boksop/swcell/docs/tasks/oled-keys-20261104.md

# SWCELL-OLED-KEYS-20261104

2026-11-04，TESTING（等待接入OLED后复测）。用户先授权提交布局（已提交70daf6f），再开发独立OLED/KEY/LED/UART诊断，验证通过后授权本次JTAG下载与UART采集。无CPU依赖、不写Flash、不移动旧Tag。

## 引脚与约定

50MHz=D27；OLED RST=Y28、DC=M30、SCK=M29、MOSI=N24、CS=P22。RST_N=N27；KEY0..7=AK28/AF26/AE26/AG28/AF27/N19/M19/M27，按下低。LED0..7=AD27/AD28/AE29/AD29/AB28/AA27/Y30/Y29，低亮。UART TX=W23 RX=V20。全部LVCMOS33。

RST_N也作为按键显示，不连接系统复位，避免按下时无法观察其状态。内部POR完成确定初始化，按键两级同步＋逐位消抖，LED严格对应KEY0..7。屏幕上电图案自检后实时显示每键、最后事件、见过掩码和计数；多键保留掩码。显示事务快照，UART发送握手并明确快照合并语义。

## 待办与完成条件

- [x] common SPI/SSD1306/逐键消抖＋项目UI/快照UART/顶层/XDC已实现，独立25个GPIO；不依赖CPU。
- [x] XSIM r3通过：45帧，16自检帧/29实时帧，实际UART5328字节/18行；9键、并键、38事件、每键计数、长按重播均检查；160 Python通过。
- [x] Vivado r2实现通过，WNS2.807/hold0.066/pulse9.600ns，25引脚与IO报告相符；当前源SHA与路由输入一致。
- [x] 仅本次JTAG对xc7k325t_0下载成功；/dev/ttyUSB1已收到OLEDKEYS01状态，patternsFF，RX探测成功；保存原始数据。
- [ ] 用户目视OLED/按键/LED确认：首次下载时OLED尚未接入。接好重新上电后需重新JTAG下载再测，首次记录不能作为OLED功能验收。
- [ ] 文档、配置、图/原始日志索引和任务恢复更新。硬件未确认不得写实体PASS。

## 检查点

布局commit70daf6f完成，原未提交布局已全部纳管。/dev/ttyUSB1可用，用户授权仅本次JTAG/UART。SSD1306参考查阅原厂 authored datasheet及厂商产品页，默认4-wire SPI mode0/MSB，低速1MHz；供电模块电荷泵设置是常见模块默认，实际可见性需实测。

后台构建/仿真前更新本记录；所有新缓存放build，实际串口放results。用户最后一句原未完整，已通过工具取得明确下载授权，不再重复询问。

## 失败与修复证据

r1仿真发现长按RST后重播时仍有在途实时帧，该帧被误计作mode0，patterns停FE并超时。保留r1日志、bit、时序和RTL快照在build/oled_keys_20261104/r1_before_restart_fix；未下载r1。修复为只有snap_mode==当前mode的完整帧才能计入自检进度，r2/r3通过后才下载r2。

## 当前采集和恢复

首次串口路径由build/oled_keys_20261104/capture_path.txt记录，启动于20261104_154609_oled_keys，采集时长300s，仿真/实现源均已稳定。JTAG目标Digilent/210017563713A，设备xc7k325t_0。bit SHA256为3cdbd63c491acdc2adf096d4bd1d3da249f788b6e0825850e20954952014224a。

如果采集已结束但用户尚未操作，应在新目录重开UART采集，不假定键/屏幕通过，不重复下载旧失败bit。用户已授权下载/采集，不再次索取相同权限；真实视觉/灯光需要用户输入。当前开发源未提交，目录整理已单独commit70daf6f。

## 接线等待检查点（2026-11-04）

用户反馈“OLED屏还没接上，等我断电接上之后再重测”。等待接线和重新上电；此期间不继续下载或开启新采集。JTAG配置易失，重新上电后使用同一已验证bit重新下载，不写Flash。

首次采集已自然结束，无后台采集或Vivado进程：`results/BOARD_IO/20261104_154609_oled_keys/`。521条有效IO_STATE，seen=000、9个按下计数均0、patterns=FF、RX探测成功。metadata另记录98条未识别输入，原始字节全部保留，不能声称整个原始文件均为有效JSON；该轮采集在下载之前启动。raw SHA256=`b5fe8d8744e8d9b5f60611f1130e6b299a23eb9f65f9dec2ea71f22da810c4c9`。OLED和LED视觉均NOT_CONFIRMED。

|检查|结果|证据|
|---|---|---|
|Python单元测试|PASS（160项）|build/oled_keys_20261104/python_r1.log|
|RTL编译/elaboration及XSIM|PASS|build/oled_keys_20261104/sim_r3.console.log；build/sim/diagnostics/oled_keys/r3/|
|综合、布局布线|PASS|build/oled_keys_20261104/build_r2.vivado.log|
|FPGA内部STA|PASS（WNS2.807、WHS0.066、WPWS9.600ns）|build/fpga/diagnostics/oled_keys/timing.rpt、build_status.json|
|JTAG与UART|PASS（诊断通信）|build/oled_keys_20261104/program.console.log；上述首次采集目录|
|OLED视觉、逐键与LED对应|NOT_RUN（OLED未接）|用户确认；接好后新建采集目录重测|

恢复时先核对 `build/fpga/diagnostics/oled_keys/source_sha256.txt` 和上文bit SHA，确认用户已接好上电，再运行项目README中的program.tcl。UART命令为 `host/python/swcell_io_diag.py --port /dev/ttyUSB1 --duration 300 --probe-rx --output results/BOARD_IO/<新时间戳>`（使用已安装依赖的Python3环境），采集先于下载启动。不覆盖本次原始记录，不把未接屏误记为显示故障，不重复目录整理commit。未跟踪clockInfo.txt不是本诊断生成文件，未经核查不混入提交。

## 接好OLED后的复测启动

用户已于2026-11-04确认接好，要求下载测试。已核对当前全部构建输入SHA、bit SHA与已通过实现/仿真的r2一致，/dev/ttyUSB1可见。新的结果目录见build/oled_keys_20261104/retest_capture_path.txt；不覆盖未接屏首轮记录。即将开启UART采集并重新JTAG下载。

复测下载成功：`build/oled_keys_20261104/program_oled_connected.console.log`，Vivado退出0，startup HIGH，目标仍xc7k325t_0。UART已收到完整IO_STATE（patterns=FF、mode8、rx1）。新采集目录 `/home/boksop/swcell/results/BOARD_IO/20261104_160402_oled_connected`，时长600s；采集session68457。用户已被提示目视/逐键测试，当前不判定硬件显示或按键LED通过。

## 用户确认与后续显示调整

用户已确认图案、文字、所有按键/对应LED及组合功能正常，但反显全白背景整体明暗闪动，屏幕需旋转180°。第一次已接OLED的采集安全结束：859条有效、seen1FF、116次按下、232个边沿事件；9路按下释放均覆盖，raw SHA e67359906a420786f2f2f09ab5b1cb9065bdaf5750ecaf54b33b966e47ed6198。38条未识别启动输入保留，软件自动视觉NOT_CONFIRMED字段不回写；用户目视结论单独记录。

SPI/帧率已由用户要求改10MHz且至少50Hz。OLEDKEYS04：HIGH2/LOW3（40/60ns），间隔800000周期=16ms，60帧/图，默认180°，A6/A7仅变化时发送。XSIM r6通过完整图案/按键/反显/重播，生产参数周期TB测得849259周期/帧=58.874854Hz、传输49258周期=0.98516ms；160 Python通过。r4仅10MHz/40ms的实现已定向停止，不得误用其部分产物；r5是新实现日志。

## 当前有效检查点：OLEDKEYS04（10MHz，58.874854Hz）

已按用户新增要求完成，不更改CPU或其他模块：SPI高2系统周期/低3周期，帧间隔16ms，60帧/图，旋转180°。重新实现r5通过，WNS2.199/WHS0.065/WPWS9.600ns，DRC0、25引脚一致。bit SHA=`a9f1f43f2eca4c5ce563ab51be0d2634a58371b5431c500b049d1589c45f505d`。2026-11-04 16:21:29 program_10mhz_50hz.console.log：退出0、startup HIGH，UART已确认新build OLEDKEYS04。

|最新验证|结果|证据|
|---|---|---|
|RTL编译/elaboration、独立屏幕模型和UART|PASS：47帧/16图案帧/31实时帧、4736字节、38受控事件|build/sim/diagnostics/oled_keys/r6_10mhz_50hz/simulation.log|
|生产参数频率及默认/旋转映射|PASS：SPI100ns周期/40ns高，849259周期/帧=58.874854Hz，静态反显无重复命令|同目录refresh.log；额外断言帧周期不超过1000000系统周期|
|Python|PASS：160项|build/oled_keys_20261104/python_r4_10mhz_50hz.log|
|综合/实现/内部STA/引脚|PASS|build/oled_keys_20261104/build_r5_10mhz_50hz.vivado.log、routed_validation_r5_10mhz_50hz.json|
|下载/新固件UART|PASS|build/oled_keys_20261104/program_10mhz_50hz.console.log、fast_capture_path.txt所指新目录|
|旧版基础引脚实物确认|PASS，显示质量问题保留|docs/reports/board_io_phase1_20261104.md、accepted_oledkeys01.json|
|新版方向及白底闪烁改善|NOT_RUN（等待用户反馈）|已异步询问，不提前判定|

最新采集路径见build/oled_keys_20261104/fast_capture_path.txt，session87858，时长600s。RX低活动探测在同次采集下载前对旧固件发送过，故新固件rx=0是尚未再次探测，原有RX引脚已有旧轮证据。若需要重新探测，应在新采集中发送，不伪造结果。

已新增报告入口、9键计数图和小型SHA索引；README内容变更在config/repository_migration_20261104.json的post_migration_updates中留有旧/新SHA，不改写原历史指纹及原迁移结果。check_layout确认44映射、138历史证据、175逻辑源、原Tag均通过；文档链接无新增缺失，原M11报告的7个历史结果链接缺失仍保持原事实。

恢复顺序：先读当前根进度，核对r5源SHA及bit，不用r4部分产物；再检查后台采集和用户最新反馈。若用户确认旋转/闪烁，形成新的显示调整结论并保留原1MHz验收报告；若仍闪烁，先记录现象、比较面板扫描/供电，不把提高SPI当作根因证明。不继续M20 CPU上板、不写Flash、不改旧Tag。所有诊断修改仍未提交，不将clockInfo.txt或build/results缓存无差别加入Git。

## 任务收尾及移交V3

用户确认OLEDKEYS04方向正确、白底闪烁基本不变，随后明确暂不处理闪烁。独立引脚验证及本轮方向/SPI/帧率要求完成；闪烁作为已知显示质量现象保留，不宣称修复。当前bit不删除；用户已取得JTAG下载命令。V3仅复用驱动及引脚，不重复外围连通测试。
