boksop/swcell/docs/m20/M20_157_FANOUT_POWER.md

# M20：扇出、负载和电源估算

2026-11-02。pin连接数量VERIFIED；Cin/PCB/活动率应用ESTIMATED；SI和稳压器额定TBD。

## 负载

见[逐网负载](physical_resources/loads.csv)和[结构扇出](v21_resources/fanout.csv)。内部最大MUX输出负载21pin，主输入rst为34pin。物理模型另加每位Q的Slave反馈、D驱动Master、33个QM反馈/Slave负载及FPGA输出接口负载；clock66个S另外计，不混入组合图。

以LVC典型Cin2.5pF、每网走线10pF、FPGA输入5pF的假设，n0095、n0235、rst超出50pF的手册时序测试负载。负载不是datasheet绝对最大允许值；“超测试负载”表示该延迟模型不再适用，不能据此直接判芯片损坏。Cin无最大值，未超也不是已保证PASS。

|信号|风险/处理|
|---|---|
|n0095、n0235公共译码/提交|高扇出跨模块；先考虑物理分组/专用缓冲，保持逻辑同源|
|rst|分区驱动，避免单FPGA IO直接驱动95pF估算负载|
|66个clock S|两相/分支扇出树，独立skew与边沿测量|
|ROM/状态选择网络|控制端延迟与数据端不同；每个分支负载列入分析|

157可用常量选择作逻辑缓冲，但每个实例应额外计数；速度/边沿/skew也需验证。优先研究专用缓冲，避免为节省外围器件破坏反馈时序。

## 功耗场景

参数来源：[Nexperia手册](https://assets.nexperia.com/documents/data-sheet/74LVC1G157.pdf)。543颗的ICC最大条件项估算约2.172mA、7.17mW；仅为输入在电源轨的静态条件，不含中间电平额外电流。

模型使用内部Cpd和输出电容分别估计动态项，66个DFF选择端内部Cpd不随数据活动率降低，clock外部必切换负载另列；活动率0.05/0.2/1.0、内部等效输入切换系数1，见[power_scenarios.csv](physical_resources/power_scenarios.csv)。它不是功耗上下界，未计多输入同时切换、组合毛刺、慢边沿额外ICC、缓冲/FPGA损耗及温漂，不能据此选定电源额定。

|CPU频率|示例模型总功率范围W，活动率0.05…1|
|---|---:|
|100kHz|约0.0096…0.0274|
|1MHz|约0.0313…0.2094|
|10MHz|约0.2483…2.0296|

这些数值包括假设的接口负载充放电，部分实际由FPGA/时钟驱动供电；不是单一CPU电源轨实测。须分轨测流。

## 电源约束

每颗157邻近一个100nF起点，共543个（名义54.3µF，非高频有效总值）；每功能分区再预留bulk和缓冲去耦。电容封装/介质/DC偏压/ESL和电源平面回路需PCB评审。100nF为工程建议，不是厂商专属强制值。

初始实验台具备3.3V、可调限流、约1A级供电能力；最终稳压器、电流裕量与瞬态额定待实测。上电时避免CPU输出向未上电FPGA反灌；MUX partial-power-down不能代替整个接口电源时序分析。快速边沿下L·di/dt地弹、串扰和慢输入ICC可能比平均功率更先限制可靠性。
