boksop/swcell/software/README.md

# 模块参考软件

小型汇编/ISA/冻结ROM按模块保存。既有m20_300保留，以保持原Pong/Snake镜像与版本证据；新增模块使用software/<模块>并记录确定的生成方法。

ROM是CPU功能参考，不是FPGA配置bitstream。大型构建镜像在build中保存和备份，不无差别纳管。
