boksop/swcell/docs/reports/README.md

# 阶段验收报告

这里保存每个正式通过阶段的中文总结，供查看、评审和交接。正式报告回答四个问题：**测了什么、在什么条件下测、结果如何、通过说明什么**。

| 模块 / 阶段 | 测试日期（UTC+8） | 验收结论 | 测试规模 | 报告 |
| --- | --- | --- | --- | --- |
| M11 / 第一阶段低速基础功能 | 2026-10-16 | 用户正式确认通过 | 17项，4742次检查，Q/QM错误0 | [正式报告](m11_phase1_20261016.md) |
| M20 / V1.0–V1.3 CPU RTL功能 | 2026-10-29 | 用户在V2任务确认通过；仅RTL仿真 | 87场景57331事件差分一致，86项Python通过 | [正式报告](m20_phaseV1_20261029.md) |
| M20 / V2.3 模式A两相联合仿真 | 2026-11-03 | 用户确认；仅FPGA直接两相数字仿真 | 每配置87/57331；全非法50521及恢复 | [正式报告](m20_phaseV2.3_20261103.md) |
| M20 / V2.4 前馈时钟完整数字联合 | 2026-11-04 | 用户批准有条件数字验收；实体/FPGA实现/硬件开放 | 六配置各87/57331；B/C各50521非法及恢复；151 Python | [正式报告](m20_phaseV2.4_20261104.md) |
| 板卡 / 第一阶段外设引脚 | 2026-11-04 | 基础功能用户确认；反显白底闪烁保留 | 9键/8LED/8图案，116次按下、232边沿；不运行CPU | [验收报告](board_io_phase1_20261104.md) |
| M20 / V3-F06 FPGA启动与按键交互 | 2026-11-04 | 用户确认完全正常；仅功能存储原型交互 | 164项Python；BOOT/游戏4帧SPI、5877 UART字节；实机75条记录及独立人工确认 | [验收报告](m20_phaseV3-F06_20261104.md) |
| M20 / V3 FPGA CPU游戏功能原型 | 2026-11-04 | 用户在发布任务确认两游戏实机通过；FUNCTIONAL_STORAGE | 87/57331核心差分；315乱序场景；实际游戏/有限ISA/全RAM快照；最终F06 | [正式报告](m20_phaseV3_20261104.md) |

| M20 / V3.1 CPU自主软件系统 | 2026-11-05 | 用户确认基本功能及修正版球拍/加号；FUNCTIONAL_STORAGE | 181 Python；2589535退役/9566 SPI字节；两次A重开仿真；实机45条UART及独立人工确认 | [正式报告](m20_phaseV3.1_20261105.md) |

## 后续阶段的记录方式

1. 确定用于验收的有效记录：实际 DUT 已连接、数据完整、条件明确，且用户已确认本阶段正式通过。
2. 从[模板](stage_report_template.md)创建 `{模块}_phase{阶段}_{YYYYMMDD}.md`，记录实际配置、逐项结果和证据路径。日期采用 Asia/Shanghai。
3. 用表格展示参数和结果；必要时增加时序图、检查量或性能曲线。图表须说明单位和依据；没有实测的数值应标为推导或仿真。
4. 写清本阶段成功的意义及尚未覆盖的范围，并说明诊断过程是否影响验收数据。
5. 核对报告与原始 JSONL、CSV、构建参数一致，更新本索引和主 README。后续验收另建报告，不覆盖旧结论。

`assets/`保存报告插图，Markdown 表格提供其对应的可读数值。正式报告和少量插图可纳入版本管理；原始数据仍在`results/`，交接时应同时归档报告引用的结果目录。仅取得 Markdown 而没有原始目录时，可以阅读结论和参数，但无法重新解析原始串口记录。

当前报告由工程协作流程维护；UART 采集程序负责保存数据，不会自行宣布某个阶段获得正式验收。
