boksop/swcell/docs/m20/README.md

# M20 — SwCell Game CPU

## 最新通过：V3.1 自主软件系统

[架构](M20_V31_ARCHITECTURE.md)、[软件SPI](M20_V31_SOFTWARE_SPI.md)、[性能](M20_V31_SOFTWARE_PERFORMANCE.md)、[测试状态](M20_V31_TEST_REPORT.md)。独立工程m20/autonomous；用户确认基本功能及修正版重开/加号正常，[正式报告](../reports/m20_phaseV3.1_20261105.md)。不改冻结ISA/477节点/V3 F06，FUNCTIONAL_STORAGE通过不代表实体双MUX DFF时序通过。下方V1～V3保留历史验收边界。

**2026-11-04：用户批准 V2.4 有条件数字验收。** [正式报告](../reports/m20_phaseV2.4_20261104.md)｜[本地定版及干净恢复](M20_V24_LOCAL_GIT_REPORT.md)｜[纳管文件清单](M20_V24_GIT_FILES.csv)。本地 annotated tag `m20-v2.4-digital-verified`；下列开发阶段“待审核”保留为历史，失败配置不改判，物理/实现/实物仍 OPEN。

## 当前V2.4主线：16级四抽头前馈20颗发生器

**最新 C/D：数字系统开发完成，待用户审核。** [完整联合验证报告](M20_V24_FULL_SYSTEM_VERIFICATION.md)：A/B/C logic/timed 各 87 场景、57,331 事件通过，B/C 各 50,521 非法终态/恢复，151 Python 通过；实际 TAP16 叶端 D1/D2=22/22ns（假设包络）。[实际波形](ffcd_resources/memory_service_timing_complete.svg)｜[存储服务](M20_V24_MEMORY_ADAPTER_DESIGN.md)｜[实体开放事项](M20_V24_PHYSICAL_TIMING_OPEN_ISSUES.md)。冻结 CPU/ISA/ROM 和 V23 不改，未 commit/Tag，未进入 V3。

以下为 A/B 历史评审；其停止门槛已被用户明确的数字/实体分层验收授权替代，原负测失败仍保留。

2026-11-04 B深化：[架构评审/十二项结论](M20_V24_ARCHITECTURE_REVIEW.md)、[参数灵敏度](M20_V24_TIMING_SENSITIVITY.md)、[时钟树与五种Buffer](M20_V24_CLOCK_TREE_BUDGET.md)、[79真实短路径](M20_V24_REAL_CPU_SHORT_PATH_ANALYSIS.md)。复核7ns为模型分配3ns＋有效边界4ns；新增632次局部实验、146项Python通过。存在条件工作区，建议保留20颗但暂不准入C/D，不作实体时序保证。

2026-11-04：[A/B开发报告](M20_V24_TEST_REPORT.md)、[结构审计](M20_V24_MUX_AUDIT.md)、[时序反例](M20_V24_NONOVERLAP_VERIFICATION.md)。固定20颗结构及模型检错VERIFIED；56组为32 CONDITIONAL、24 FAILED。快速链敏感性下四抽头均有负D1/D2，按门禁停止在A/B，尚无实体推荐抽头，不启动存储/完整CPU联合，不创建验收tag。CPU543、ISA、ROM和V2.3基线保持。

## 历史V2.4候选：116颗自主发生器与同源存储服务

[设计审核稿](M20_V24_DESIGN_REVIEW.md)：116颗发生器候选+543核心，A/B/C预设参数完整对照PASS；独立混合选择弧覆盖缺口尚未解决，已按用户指令暂停，无验收tag。V23模式A定版及原PASS不受影响。

## V2.3：真实双相锁存器与同步FPGA存储联合仿真

2026-11-03：保持477组合/33状态/543等价，新增IDEAL_FF与真实66反馈MUX状态切换，四阶段非重叠调度、停钟/单步和同步ROM/RAM服务。

- [双相架构](M20_300_V2_3_TWO_PHASE_ARCHITECTURE.md)
- [两相与FPGA存储接口时序契约](M20_300_V2_3_FPGA_MEMORY_TIMING.md)
- [回归入口及压力矩阵](M20_300_V2_3_VERIFICATION.md)
- [实际结果与关键波形](M20_300_V2_3_TEST_REPORT.md)

V1/V2.1旧源、机器码、历史证据和标签保留；不是实体157时序签核。

## 当前入口：V2.1正式543结构 / V2.2物理规格

2026-11-02：用户接受500+规模，不再以300为硬约束。正式版477组合+66存储折算=543（纯功能542），33状态/原ISA/2-5profile保持。本轮已重新完成全部50521非法CPU终态和恢复、87场景57331事件三方及内存测试；物理规格属于估算，真实DFF/时钟/PCB尚待实测。

|入口|内容|
|---|---|
|[V2.1结构](M20_300_V2_1_STRUCTURE.md)|正式生成器、完整退役接口、477/476口径|
|[V2.1审计](M20_300_V2_1_MUX_AUDIT.md)|独立SV/pin/FF/锥/扇出CSV|
|[V2.1验证](M20_300_V2_1_VERIFICATION.md)|全非法终态/数学/三方与一条命令|
|[V2.1结果](M20_300_V2_1_TEST_REPORT.md)|本轮实际PASS与未执行边界|
|[物理可实现性](M20_PHYSICAL_FEASIBILITY.md)|最长/最短路径、器件/时钟/接口/PCB规格导航|
|[活动任务](../tasks/m20-v21-physical-20261102.md)|检查点和证据|

## 历史入口：V2 157结构与精确审计

2026-10-29：V1原件及原始证据保留并复跑通过。新增baseline/shared两版显式MUX网表，保持33位状态/原ISA/2-5profile；每版87场景57331事件的V1/V2/Python三方回归通过。独立审计得到**738→603颗核心157等价**，尚未达到328/300；未进入板级/物理阶段。

|入口|内容|
|---|---|
|[V2结构](M20_300_V2_STRUCTURE.md)|唯一原语、MUX逻辑构造、生成网络及FF边界|
|[精确预算](M20_300_V2_MUX_BUDGET.md)|逐组/逐实例CSV、328偏差、共享效果与拓扑|
|[V2验证](M20_300_V2_VERIFICATION.md)|两版三方入口、不可变V1/输入、独立审计与失败证据|
|[V2结果](M20_300_V2_TEST_REPORT.md)|实际测试和最终八个问题的回答|
|[Git基线提案](M20_300_V2_GIT_BASELINE.md)|首次纳管范围/排除/历史证据归档，待用户确认，不commit|
|[V2任务记录](../tasks/m20-300-v2-20261029.md)|完成状态及下一次恢复入口|

## 已冻结的V1.3功能基线

2026-10-29：正式 ISA 为 **M20-300-ISA-0.1**，编码/标志/软件状态与V0一致。七模块功能RTL、原生FF状态33位；已用真实XSIM2026.1.1完成86项Python、全编码/ALU、87个CPU场景共57331事件差分，原Pong/Snake机器码执行通过到V1.3。

|文档|用途|
|---|---|
|[ISA正式冻结规范](M20_300_ISA_FROZEN.md)、[机器规则表](isa_v0_1.json)|软硬件共同依据；FAULT软件边界与ISA/周期profile分离|
|[V1 RTL设计](M20_300_V1_RTL_DESIGN.md)|实际模块/33位/提交边沿/总线/资源风险|
|[V1验证方法](M20_300_V1_VERIFICATION.md)|一条命令、输入/输出协议、独立比较及失败证据|
|[V1测试结果](M20_300_V1_TEST_REPORT.md)|实际XSIM统计、逐项PASS、镜像SHA及验证边界|
|[V1任务入口](../tasks/m20-300-v1-20261028.md)|当前恢复记录|

执行 `sim/scripts/run_m20.sh` 可重现。**ISA冻结不冻结微架构**；当前2/5周期是所选profile，328颗仍未结构审计。V1通过指RTL功能仿真，不包含综合/STA/FPGA上板或157物理性能。用户原架构文档保留撰写时状态，后续实现以本索引的冻结规范/设计/验证为准。

## V0 软件原型来源

2026-10-28：用户指定的 [M20_300_architecture_v0_1.md](M20_300_architecture_v0_1.md) 是本轮依据：16-bit 指令字、无 IR/B/T/LR、4-bit A、RAM 直接操作数、软件返回编号、候选 8 微状态。该源文档的“尚未实现工具”描述是撰写时快照，保留原文；当前实现与证据见以下新增文档。

|入口|内容|
|---|---|
|[16-bit ISA 与工具](M20_300_isa_v0_1.md)|完整编码、标志、汇编器/解释器及 trace 契约|
|[V0 验证与周期预算](M20_300_software_validation_v0_1.md)|77 项 Python 回归、2158 个核心场景、ROM 和实际动态指令计数、ISA 能力复核|
|[Pong/Snake 机器程序](../../software/m20_300/README.md)|汇编源码、RAM/输入/软件 ABI、一条命令复现|
|[当前任务记录](../tasks/m20-300-software-20261028.md)|进度、证据与下一阶段恢复入口|

Pong 为 168 words/336 bytes，Snake 为 368 words/736 bytes；尚无 OLED/SPI、按键消抖或硬件验证。328 颗仍待结构审计；本轮软件验证不构成架构冻结或物理阶段验收。此前 747 方案的 ISA/周期预算保留如下，作为历史比较，不能与 M20-300 混用。

## 历史方案：M20-747 规划 v0.2

日期：2026-10-28（Asia/Shanghai）。**提案v0.2，供评审；尚未冻结架构、实现CPU或验证性能。** 本目录现有10份中文规划Markdown及1份预算CSV，没有创建工程、RTL、XDC、程序工具或测试数据。

## 建议摘要

推荐优先评审**4位累加器、多周期、硬布线控制、12位PC、8位RAM地址、8位指令、单层CALL/RET**方案。程序ROM与数据RAM分离；8位物理数据接口中RAM先仅使用低4位，避免打包读改写。OLED先由CPU软件bit-bang，六键同步后轮询、软件消抖。Pong和Snake全部状态更新/碰撞/绘图决策由机器程序完成。

**用户已明确RAM/ROM不使用157构造**：方案1由FPGA提供；方案2使用外部并口芯片，例如IS61WV5128BLL-10TLI-TR与MX29LV320ETTI-70G。两方案存储容量均计0颗157，只计CPU侧寄存器及接口逻辑。原627–747估算已经不包含存储阵列，因此这个澄清不会自动从747扣除一块“RAM成本”。[747逐项明细](mux_budget.md)与[机器可读CSV](mux_budget_747.csv)已补齐。

**300颗目标与本提案不相容。** 显式MUX树及状态预算为：最小配置约555–651颗，Pong/完整Snake配置约627–747颗；加20%工程余量后，完整配置建议预算至900颗。控制器尚未逐门审计，这不是已证明的上界，也不是器件采购定案。应先决定是否接受该预算，或另立以300颗为硬上限的串行架构研究。

|问题|提案回答|
|---|---|
|为什么先4位|相对8位候选约省116–156颗的规划量级；可复用ALU做PC/地址运算，但执行更慢，须用真实软件验证|
|寄存器|PC12、AR8、A4、B4、T4、IR8、LR12、Z/C/K共3位、微状态6位、等待计数2位、GPIO5位；另键同步12位、复位同步2位|
|存储器|4KiB逻辑程序ROM；256个4位RAM单元；游戏各自独立程序镜像，暂不承诺一个镜像同时容纳两游戏|
|游戏可编程性|有完整条件分支、间接RAM读写、动态AR、借位/进位及单层调用；Snake用环形身体表与32-nibble占用位图|
|性能是否足够|条件性预算：零额外等待时，Pong突发帧≤390400周期，Snake含食物搜索最坏tick≤364900周期；约2MHz才有5Hz级规划余量，真实157频率未知|
|FPGA与实物一致性|同一寄存器/微状态/ISA/总线时序；FPGA仅把状态单元绑定原生FF，真实映射恢复MUX反馈DFF|

## 文档导航

|文档|内容|
|---|---|
|[architecture.md](architecture.md)|现有工程检查、候选比较、数据通路、寄存器、微状态与共享资源|
|[isa_proposal.md](isa_proposal.md)|完整候选编码、标志、周期、硬件与游戏用途、地址/调用示例|
|[memory_architecture.md](memory_architecture.md)|ROM/RAM总线、等待、8/16位接口比较、物理器件边界|
|[io_interface_plan.md](io_interface_plan.md)|软件SPI、六键、GPIO、辅助模块与外部器件职责|
|[mux_budget.md](mux_budget.md)|逐项157折算、三档预算、优化代价与网表审计方法|
|[game_feasibility.md](game_feasibility.md)|Pong/Snake循环、数组/位图、指令/访存/帧预算|
|[fpga_prototype_plan.md](fpga_prototype_plan.md)|FPGA分层、复用边界、观察口、原生FF与结构映射模式|
|[verification_plan.md](verification_plan.md)|P0–P8验收、独立参考模型、覆盖、故障注入与证据|
|[open_decisions.md](open_decisions.md)|必须冻结的决策、用户需补充的参数和风险|

## 事实、提案、TBD

- **工程已确认**：板卡part为`xc7k325tffg900-2`，配置50MHz；资料来自`fpga/projects/m11/functional/config/default.tcl`。M11 P1/P2/P2B证据保留，但不是M20频率依据。
- **用户已确定**：真实CPU主要由单路2:1 MUX构成；自定义ISA；CPU自主执行游戏；RAM/ROM由FPGA或外部并口芯片提供而非157；FPGA原型用原生FF；不复用/移植旧M11 Vivado工程；本次不编写CPU或引脚约束。
- **推荐、未冻结**：本文全部CPU位宽、编码、存储布局、GPIO位定义、显示假设及预算。
- **TBD**：OLED控制器/分辨率/时序/电平、六键电路、两存储方案的最终选择和候选器件的具体连接模式、M20实际157厂商料号、PCB时钟/复位/负载、外设引脚与可接受数量上限。

## 已有资料检查及本次完成状态

检查了AGENTS、TASK_PROGRESS、现有架构、公共RTL、板卡配置、M11正式与高速验证文档、用户本次附件。未找到独立项目纲要、既有M20设计或通用结构级ALU/MUX库；这表示**当前工作区未找到**，不声称工程外从未设计过。发现的旧模块保持原样。

- [x] 架构/ISA/总线/IO/资源/软件需求/验证路线规划落盘。
- [x] 规划内部的预算加总、编码族覆盖、周期计算、文档链接及原工程未改动检查；这是文档一致性检查。
- [ ] 用户审查并冻结P0（未执行）。
- [ ] P1资源网表审计、P2以后实现/仿真/FPGA/PCB验收（全部未执行）。

**规划编写任务完成，架构冻结与硬件验证未完成。** 本次遵守仅写M20文档的限制，未更新根TASK_PROGRESS或旧110文件首次提交清单。后续会话先读本页、open_decisions和verification_plan；如要实现，须先取得架构冻结结论并更新任务入口/纳管清单。不得把文档完成标成M20阶段硬件PASS。

## 外部资料口径

器件逻辑参考[Nexperia 74LVC1G157数据表](https://assets.nexperia.com/documents/data-sheet/74LVC1G157.pdf)：用来核对单路MUX功能及无运行时三态输出使能的接口边界，不将其料号/典型延迟当作用户实物规格。FPGA状态单元参考[AMD UG953 FDRE](https://docs.amd.com/r/en-US/ug953-vivado-7series-libraries/FDRE)。2026.1的器件/许可须在P6前核实，参见[AMD许可说明](https://www.amd.com/en/products/software/adaptive-socs-and-fpgas/licensing-faq.html)，本次没有执行工具检查。

## 本次文档核对

2026-10-28已检查10份文件的相对链接/代码围栏、63个微状态、229种有效首字节与27种非法IO编码的数量划分、预算加总和游戏周期算术，均一致。这是文本/数学自检，没有运行CPU模型或指令仿真。

原rtl/fpga/sim/host/results范围308个既有普通文件的路径+SHA映射摘要前后一致：`f041b6f2968310a116071cfdbee184aab5f431abbe10f4f6b739a69909949f69`；Git index的SHA仍为`ac2b0d7c6dbd88a804b174f62e84e0c672a987d508deabbed8bd5ff3d0ef0c6a`。本次没有新增暂存、commit或push。

v0.2补充：已将747取值拆成164颗存储MUX、62颗保持/使能MUX、521颗其它组合/控制预算；容量阵列为0。下一状态/控制240仍是估算上沿，存储/IO控制各12也待结构审计，不能写成已经实现的精确门数。此次只修改M20规划文件，根任务入口保持不变；下次继续时先阅读本页、预算和待决项。

## 本地版本与恢复

[版本历史/标签](M20_RELEASE_HISTORY.md)、[来源SHA与只读审计](M20_SOURCE_MANIFEST.md)、[实际恢复报告](M20_LOCAL_GIT_REPORT.md)。数字逻辑tag不代表实物时序；物理分析tag保留ESTIMATED/TBD。

## V3 FPGA实机原型（2026-11-04）

[工程与按键](../../fpga/projects/m20/cpu_validation/README.md)、[架构](M20_V3_FPGA_ARCHITECTURE.md)、[结构映射](M20_V3_STRUCTURAL_IMPLEMENTATION.md)、[时钟/存储](M20_V3_CLOCK_MEMORY_INTEGRATION.md)、[按键/OLED](M20_V3_KEY_OLED_INTERFACE.md)、[游戏](M20_V3_GAME_VERIFICATION.md)、[STA/资源](M20_V3_TIMING_RESOURCE_REPORT.md)、[硬件记录](M20_V3_HARDWARE_TEST_REPORT.md)、[总报告](M20_V3_TEST_REPORT.md)、[Pong固定发球说明](M20_V3_PONG_SERVE_REVIEW.md)。功能存储模式已实机运行且用户确认两游戏操作；严格反馈模式85项LUTLP-1，不宣称543物理反馈存储已在FPGA上通过。当前按用户反馈默认Pong10/Snake5tick/s，KEY5暂停，KEY4中键忽略。

F04方向事件缓存已获用户确认短按明显改善。另有[固定乱序食物变体](M20_V3_SNAKE_SHUFFLED.md)：原ASM/ROM不变，新软件315场景/154611事件及实机66tick/12份全RAM对照通过，已下载；食物分布的新人工体验尚待确认。

当前键位调整：[F05互换记录](M20_V3_KEY_SWAP_F05.md)，KEY5/A切游戏、KEY7暂停/继续。前述KEY5暂停为F03/F04历史确认，F05不改游戏ROM、CPU或速度。

启动页入口统一：[F06记录](M20_V3_BOOT_ENTRY_F06.md)。BOOT页KEY5启动当前游戏，KEY7不启动；游戏中继续KEY5切换、KEY7暂停。F05键位互换已获用户确认，新启动入口独立记录验证状态。

用户随后确认F06“已经完全正常了”；[启动与按键交互正式验收报告](../reports/m20_phaseV3-F06_20261104.md)及独立人工确认记录已保存。该范围不扩展为实体543颗157时序或整个V3最终冻结。

后续首次Private发布任务中，用户明确确认V3整体游戏功能已通过：[V3整体正式报告](../reports/m20_phaseV3_20261104.md)、[GitHub发布记录](../GITHUB_PUBLISH_REPORT.md)。Private仓库boksop/swcell及m20-v3-fpga-hardware-verified Tag保留历史代码；仅FUNCTIONAL_STORAGE通过，不修改早期证据或扩展实体时序结论。
