boksop/swcell/software/m20_300/rom/README.md

# 冻结参考机器码

2026-11-03从原汇编器只读组装并核对既有冻结SHA，不替换历史ROM或实测数据。

{
  "pong": {
    "words": 168,
    "binary_sha256": "e1029928d763ab5b0d21fe347687f52b326f545e9072f4c04365597439eead8c",
    "format": "16-bit word, little-endian unpadded binary; four hex digits per memh line"
  },
  "snake": {
    "words": 368,
    "binary_sha256": "466cb149c8e5d6914d0b78dc8a3ec5074c77020edf880cedbd520b41b3376b98",
    "format": "16-bit word, little-endian unpadded binary; four hex digits per memh line"
  }
}
