boksop/swcell/docs/reports/m20_phaseV1_20261029.md

# M20 第V1阶段验收报告：CPU RTL 功能与游戏ROM差分

> 状态：用户已在V2任务开头确认V1.0～V1.3完成并通过指令级差分。本报告验收对象是RTL仿真，不是FPGA板卡或157实物。

|项目|内容|
|---|---|
|测试日期/时区|2026-10-29，Asia/Shanghai|
|DUT|M20-300行为CPU RTL，33位状态；无物理板卡DUT|
|目标|冻结ISA，实现真正CPU执行Pong/Snake机器码，逐指令与Python一致|
|验收依据|用户V2任务确认；原`build/m20_300/v1/`及[V1详细结果](../m20/M20_300_V1_TEST_REPORT.md)|
|结果|86项Python通过；65536编码/32768 ALU向量通过；87场景57331事件一致，最终RAM一致|

## 1. 测试内容与方法

CPU RTL实际取16-bit ROM指令、读写256×4 RAM、读取逻辑六键，按冻结ISA更新A/AR/PC/Z/C/GPO。TB只装载启动夹具/外部输入，观察真正退役，不计算游戏行为。Python参考解释器独立计算预期，每条指令比较旧PC/机器字、next_pc、提交状态、RAM事务及实际微周期；所有场景结束比较完整RAM。

Pong包括初始化、运动、墙/球拍、双输入、得分进位；Snake包括清RAM、身体环/位图、旧尾格、自撞、增长、63次食物探测、64节封顶和重启。两游戏各有连续64tick，运行期间没有宿主状态回写。

## 2. 实际参数与频率

|参数|实际值|来源/边界|
|---|---|---|
|ISA|M20-300-ISA-0.1|冻结规则，机器码与V0不变|
|CPU状态|33bit|PC12/AR8/A4/ZC2/GPO4/uSTATE3|
|仿真微时钟|周期10ns，分辨率1ps|仅仿真时基；不是157实测100MHz|
|执行周期|普通2、RAM5、reset1单列|真实XSIM边沿计数与Python一致|
|ROM/RAM|4096×16 / 256×4|外部仿真模型，不使用157构造存储容量|
|内存模型延迟|ROM1.5ns/RAM2ns及注册读适配|逻辑时序压力，不是物理芯片规格标定|
|复位|同步高有效，立即屏蔽WE|不清RAM，不回滚已发生写入|
|工具|Vivado Simulator2026.1.1、Python3.12|实际xvlog/xelab/xsim|
|电压/温度/板卡时钟/UART|不适用，本阶段未实测|没有烧写、串口或板外仪器|

## 3. 逐项结果

|检查项|次数/规模|错误/差异|结果|
|---|---:|---:|---|
|Python回归|86项|0失败|PASS|
|严格译码|65536 word，15015合法/50521非法|0不符|PASS|
|ALU独立数学oracle|32768向量|0不符|PASS|
|内存/运行中复位|7组|0失败|PASS|
|CPU指令差分|49场景、22223事件|0差异|PASS|
|游戏CPU差分|38场景、35108事件|0差异|PASS|
|完整RAM|87场景×256nibble|0差异|PASS|

57331事件中57314正常退役、17 TRAP；一条事件可比较多个信号，但不将信号数重复计入事件总数。全空间编码是译码单元覆盖，不宣称CPU逐个时序执行了50521非法字。

## 4. 图表及解读

|程序|ROM指令字|有效字节|普通tick周期|本轮关键长路径周期|
|---|---:|---:|---:|---:|
|Pong|168|336|202|308，多分支/得分进位|
|Snake|368|736|926|13419，63次食物探测|

表中单位是执行微周期，来自真实RTL轨迹；单tick未含末尾NOP/JMP的4周期，不是完整游戏帧率或Fmax曲线。

## 5. 通过的意义及验证边界

V1建立了可综合行为RTL作为以后MUX结构优化的可信功能基线，证明核心算法确实能由当前ISA机器码和CPU数据通路执行。ISA冻结不冻结内部微架构；调整周期必须同步性能profile和参考测试。

未综合、未实现/STA、未上板；未做OLED/SPI/消抖/WAIT、同步ROM/最终BRAM或物理反馈DFF验证；33位只证明功能状态边界，不证明328颗预算。原始数据和报告保留供后续三方对照。

## 6. 异常与排除记录

本机xelab有LIBRARY_PATH环境提示，实际编译/仿真成功。早期根目录产生的M20编译缓存已移入build，旧.Xil不动。V2后来发现的结构生成命名冲突不属于本V1验收，不改写原V1记录。

## 7. 证据与复现

|证据|路径/标识|
|---|---|
|源码/规则/测试方法|[冻结ISA](../m20/M20_300_ISA_FROZEN.md)、[V1设计](../m20/M20_300_V1_RTL_DESIGN.md)、[验证入口](../m20/M20_300_V1_VERIFICATION.md)|
|原始数据|`build/m20_300/v1/{instructions,games}/`的输入、预期、实际CSV、完整最终RAM|
|日志/波形|`build/m20_300/v1/xsim/`及四个WDB、`python_tests.log`|
|汇总SHA256|原`verification.json`：`f0ab7e77643c1fd24fcad6cb330dc1b4ffbb9251f3cb1158baa6721bf3d2d8cb`|
|Pong小端ROM SHA256|`e1029928d763ab5b0d21fe347687f52b326f545e9072f4c04365597439eead8c`|
|Snake小端ROM SHA256|`466cb149c8e5d6914d0b78dc8a3ec5074c77020edf880cedbd520b41b3376b98`|

入口`sim/scripts/run_m20.sh`；为了不覆盖正式原证据，后续应指定新的`M20_OUTPUT_DIR`。源/输入关联清单与报告一并归档；本次Git尚无首个提交，不虚构commit。
