boksop/swcell/docs/tasks/m20-v31-autonomous-20261105.md

# M20 V3.1 自主软件系统

**COMPLETED，2026-11-05，Asia/Shanghai。** main基线4a7d1fd。用户确认菜单/两游戏/长按/暂停/复位正常，随后报告Pong重开球拍和图案问题；固件0.2修复、验证、重新下载后，用户确认“重开后两边球拍均正常”“两处均已显示为加号”。正式报告[已保存](../reports/m20_phaseV3.1_20261105.md)。

## 完成清单

- [x] 检查AGENTS/TASK/Git，保留用户docs.zip和先前Public进度修改，不改现有历史/Tag。
- [x] A：冻结ISA下软件可行性、统一重定位和软件ABI；最终ROM4052/4096字，剩44字，RAM剩10nibble。
- [x] H1/H2：六GPI仅2FF，GPO直连；所有SSD1306初始化/字节/SPI边沿由CPU OUT产生，无FPGA硬件渲染。
- [x] H3/H4：软件菜单、消抖/单次事件/长按、两游戏、乱序食物、局部绘图和软件节奏；Pong重开缓存/加号回归已修复。
- [x] H5：原CPU指令/存储/非法/算术回归，真实新系统V1/结构CPU/Python逐退役对照、STOP/STEP/RESET和单次写。
- [x] H6：综合/实现/STA/DRC/CDC、route audit、bit/JTAG、UART及独立人工确认。
- [x] 正式阶段报告、报告索引、README/模块入口、JSON人工确认、源SHA及原始证据索引。

不属于本次验收：ILA（采用UART辅助）、STRICT_MUX、真实157/两相发生器/PCB时序签核、温压/长期可靠性、Flash。没有开始这些后续工作。

## 最终配置和验证

|项目|命令/方法|结果|证据|
|---|---|---|---|
|Python|tools/test/run_python_tests.py|PASS，181项|build/m20_v31/restart_plus_python_r2.txt|
|原CPU基线|sim/scripts/run_m20_v3_core.sh|PASS，87/57331、50521非法/恢复、27840数学、7访存|build/sim/m20_v31/v3_core_baseline_r1|
|GPIO/平台|run_m20_v31_units.sh；源未因本次软件修复改变|PASS|build/sim/m20_v31/units_r4|
|完整新系统|sim/scripts/run_m20_v31.sh|PASS，2589535退役、9566SPI字节、373773RAM写、最终全RAM相同；A重开2次与plus像素|build/sim/m20_v31/restart_plus_joint_r2|
|游戏重定位|tools/m20/v31/verify_relocation.py|PASS，177 Pong/315 Snake，Python独立规则对照|build/m20_v31/restart_plus_relocation.json|
|综合/实现/STA|autonomous/scripts/build.tcl|PASS，750LUT/984FF、2RAMB36+1RAMB18、DSP0、1BUFG；WNS1.972/WHS0.092/WPWS9.6ns、DRC0|build/fpga/m20/autonomous/restart_plus_r2|
|路由审计|tools/m20/v31/route_audit.tcl|PASS，477MUX/33CPU FF，4OLED唯一驱动为GPO FDRE/Q|同上route_audit|
|JTAG|fpga/common/tcl/program.tcl|PASS，12:31:13 startup HIGH|build/m20_v31/restart_plus_program_r2.txt|
|最终UART|host/python/swcell_m20_v31.py，45s|PASS，45条完整记录，errors0；1起始残行单列|results/M20_V31/20261105_restart_plus_r2|
|UART控制，原平台|swcell_m20_v31_control_test.py|PASS，7条状态；STOP稳定、STEP+1、RESET PC0/GPO8无新写、RUN恢复|results/M20_V31/20261105_debug_controls_r1；属于原r5实机，平台未改|
|人工验收|本会话两个阶段的独立回复|PASS，基本功能及两处修复均确认|v31_resources/user_acceptance_restart_plus_20261105.json关联初始确认|

当前bit：build/fpga/m20/autonomous/restart_plus_r2/swcell_m20_v31_top.bit；SHA181fb8844407a69f405594440245dc5ed1e50a24e81e103d194aa531835cfd0f。ROM SHAae5be5055052c8ea9c8a5e4d00de5dcaf2dfe531e84a57fb9dec0b4feef71619。原F06 bit仍972d8ebc5378c244ce5f530be9c8f0b0c9b04853c6c56576c82f96e995d79c49。

## 决策与限制

固定477组合MUX＋33原生FF；无新增ISA/CPU状态/FPGA游戏逻辑。普通2/RAM5微周期，50MHz单域＋CE，CPU1MHz。共享软件例程使用RAM返回编号静态分派，非递归。无framebuffer，用SSD1306 GDDRAM；软件SPI54..89μs/bit，不能仍称V3的10MHz硬件SPI。当前常规Pong约9.59Hz、Snake约4.76Hz，为指令预算而非板外仪器实测。

本次bug修复仅6个软件/生成/测试文件改变，平台RTL/冻结CPU/ISA不动。每次launch_pong置OLDL/OLDR=15使缓存失效；PIX6输出00/00/18/7E/7E/18/00/00。最长轮询间隙58.523ms；3样本滤波不保证所有短按。Pong顶行比分布局取舍及仅44字ROM余量保持披露。

## 失败与历史证据保留

- 原r5 179 Python/2051485指令/7250SPI字节和最初用户回复仍是真实历史。后来新增实际A重开测试复现球拍全黑、旧球8列0x66；v31_initial_r5_resources/restart_and_glyph_counterexample.json。
- 初始源/ROM/测试快照build/m20_v31/pre_fix_20261105，初始指标/SHA/图在docs/m20/v31_initial_r5_resources；当前指标在v31_resources，两个版本不混用。
- 首个加号比较方向错误导致181测试2项失败、软件验证断言失败，未下载；build/m20_v31/plus_first_encoding.json和restart_plus_python_r1.txt原位保留。
- restart_plus_r1构建检测ROM改变而拒绝写bit，SOURCE_CHANGED_DURING_BUILD不是器件时序失效；锁定输入的新r2通过。
- 更早joint_r1超时常量在0时刻溢出、units_r1漏端口elaboration、implementation_r1误计同步器等失败仍原位；不放宽产品断言。
- 新仿真UART351完整行＋1末行截断；新实机45完整行＋1起始残行。旧r5首次143新协议＋8旧协议/前缀、旧控制7记录不回写为新固件。

## 恢复入口

任务已完成，不自动继续STRICT_MUX/PCB/Flash或优化。先看根TASK、正式报告和当前验收JSON；板上是restart_plus_r2，正常运行菜单/游戏，无后台仿真或采集依赖。不重复下载旧r5。

如有新缺陷，基于当前固件0.2保存新的复现/目录，保持旧证据。若用户要求Git定版，先检查全部未跟踪和已有修改，docs.zip不自动纳管。当前没有本轮commit/Tag/push，HEAD仍4a7d1fd，暂存区空；不能将V3旧Tag当作V3.1已发布。

最终收尾检查：32份当前源指纹、冻结V3、初始r5源快照及两个版本的全部原始证据SHA一致；正式报告链接和7工程catalog检查通过，git diff --check通过。文档收尾未改任何功能源码/测试数据，未重复运行已通过的大规模仿真或重新下载。

后续Git/Release定版已由用户授权完成，源码d0df9f9及Tag m20-v3.1-autonomous-fpga-verified已发布；旧“未commit/Tag/push”仅指功能验收当时检查点。新入口m20-v31-release-20261105.md及M20_V31_LOCAL_GIT_REPORT.md，不重复建立版本。用户也已自行删除未跟踪docs.zip。
