boksop/swcell/docs/tasks/m20-v31-release-20261105.md

# M20 V3.1 本地定版与Release归档

2026-11-05，COMPLETED，main起点4a7d1fd。用户授权commit/annotated tag/远程同步/GitHub Release bit归档；不包含新的设计或实物测试。

- [x] 读取AGENTS/TASK/本地工作流，暂存区空、只有V3.1和先前Public进度/入口变更，用户docs.zip另保留。
- [x] gh认证boksop，origin明确为https://github.com/boksop/swcell.git；live Public，main与5个旧Tag和本地一致。
- [x] 生成82来源/16实际bit构建输入绑定，65份原字节精选证据（1122412bytes）入Git；73份完整证据50566239bytes压缩为2307369bytes Release包，大文件索引与bit SHA通过。
- [x] 82来源/16输入、三文件再生成、独立计数、发布扫描和155路径暂存门禁通过；原181测试与硬件阶段证据原样归档。
- [x] 源码commit d0df9f97893019687bb2d8c81473a13ac6a074fb，干净detached worktree恢复/181 Python/完整XSIM/新综合全部PASS。
- [x] annotated tag对象42c2b7f3539551d238512309ea4db3b200fcf71c、main/tag正常atomic push；Release四附件已发布。
- [x] 真正远程Tag检出来源/ROM/证据/资源校验PASS；四附件及73份内层文件完整读回PASS，报告/索引落盘。

采用最终固件0.2（4052字/余44，ROM ae5be505…）和已用户验收的restart_plus_r2 bit（181fb884…）。FUNCTIONAL_STORAGE 477组合MUX+33原生FF，非STRICT_MUX/实体157/物理两相签核。所有原始build/results保持，失败不能改PASS；无新增许可证。

下一步打开tools/git与docs/m20/v31_resources；所有新发布辅助输出写build/v31_release_20261105新目录。不要重做Git初始化、移动旧Tag或混入docs.zip。提交/Tag/Release如果中断，先核对实际对象与远程资产后恢复，不能盲目重建或--clobber。

预提交审计：所有当前源/ROM/实际build输入及65份拷贝SHA通过，3个固件文件可逐字节再生成，独立CPU477/33/543通过；故意错误ROM预期SHA被拒绝。发布扫描17历史提交与当前候选PASS，无匹配秘密/超限文件/缓存；新增厂商版权抬头均为原始Vivado生成报告，不含工具或许可。暂存清单将按明确V3.1路径建立，docs.zip已忽略留本机。

源码提交已实际建立：d0df9f97893019687bb2d8c81473a13ac6a074fb（155路径变更）。干净worktree路径见build/v31_release_20261105/worktree_path.txt；clean_source_audit.json已PASS，82源/16实际输入、3生成文件、477/33/543、65归档证据均可仅由提交文件恢复，git status空。clean_python/clean_units/clean_joint/clean_synthesis正在独立运行；等实际结果再Tag/push，不重做硬件。

用户后续明确告知已自行删除docs.zip：这是未跟踪备份文件，不在source commit或Release选择中，不恢复也不将其删除计为工程变化；早期“保留本机”仅描述删除前检查点。/docs.zip忽略项仍用于防未来同名备份误提交。当前发布归档/源码不受影响。

干净恢复全部PASS：181 Python、2589535退役/9566SPI/373773写/全RAM、GPIO/存储/控制及新工程综合，原V3 67源/10生成文件也保护通过。已创建annotated tag对象42c2b7f3539551d238512309ea4db3b200fcf71c，目标d0df9f97893019687bb2d8c81473a13ac6a074fb；已正常atomic push main与新Tag。准备4个Release资产，manifest已绑定精确source/tag/SHA，等Release创建及独立下载校验。

## 最终恢复入口

任务COMPLETED；主功能交付及远程Release均已实际核实。source/tag目标d0df9f97893019687bb2d8c81473a13ac6a074fb，Tag对象42c2b7f3539551d238512309ea4db3b200fcf71c；后续main仅提交本轮恢复/下载证明，不移动Tag。Release https://github.com/boksop/swcell/releases/tag/m20-v3.1-autonomous-fpga-verified 。

独立远程克隆和下载路径见build/v31_release_20261105/{remote_clone_path.txt,downloaded_assets}；干净源码恢复181 Python、GPIO/内存/控制、2589535指令联合及新综合均PASS；原板上用户验收与源/bit绑定不变，发布期间未重跑硬件。源82/构建16/小证据65/Release内原文件73全部SHA通过，5旧Tag保持，未重写历史。完整报告docs/m20/M20_V31_LOCAL_GIT_REPORT.md及v31_release_resources/{recovery_verification,release_asset_manifest,download_verification,publication_verification}.json。

最后执行只对本轮元数据新增/更新文件显式暂存、独立补充commit及正常push；如这一步中断，核对git status、本地HEAD、ls-remote main后恢复，不重复source commit/Tag/Release创建。不自动--clobber或改Tag。最终精确main/资产SHA另存build/v31_release_20261105/final_receipt.json；该文件不嵌入自身Git提交。docs.zip已经用户自行删除，不恢复。本任务后不继续设计/PCB/硬件开发。
