boksop/swcell/docs/tasks/m20-v3-fpga-20261104.md

# M20-V3-FPGA-20261104

状态COMPLETED（FUNCTIONAL_STORAGE功能原型），2026-11-04，main。任务来源：用户附件10551b44的V3要求及按键补充。实现独立fpga/projects/m20/cpu_validation，不改冻结ISA/477组合网表/原游戏ROM、不改M0～M19和V23/V24证据或Tag。原“无远程/无V3 Tag”是开发阶段限制，已由用户后续首次Private发布授权取代，详见github-publish-20261104.md。

## 已核实

- [x] V24已在本地tag m20-v2.4-digital-verified（48564b5）正式定版；当前HEAD70daf6f为后续目录整理。
- [x] 现有独立OLED诊断在工作树未提交，硬件功能/方向已用户确认：SSD1306、SPI10MHz/58.87Hz、180°，驱动rtl/common/display/swc_ssd1306.sv；引脚fpga/boards/swcell_k325t/oled_keys.json及独立io.xdc。白底闪烁保留，用户要求暂不处理。
- [x] 冻结CPU rtl/m20/v21/generated/m20v21_cpu_core.sv含477显式组合MUX和33原生FF；V23/V24是仿真双锁存器适配，不可直接将延迟链当FPGA时钟。
- [x] 按键用户映射：逻辑K0=KEY2上，K1=KEY0下，K2=KEY3左，K3=KEY1右，K4=KEY5预留A，K5=KEY6 B重启。均低按下，经同步消抖转高有效。Snake由原IN1bit1重启；Pong原机器码该位预留，不改ISA/ROM。

## 待办

- [x] 派生可追溯V3适配网表和逐位存储映射；477节点/33位校验，保持冻结源字节不变。
- [x] STRICT_MUX综合/布局布线尝试，实际85项LUTLP-1；无严格bit，不关闭组合环检查，继续FUNCTIONAL_STORAGE。
- [x] 同一50MHz时钟＋受约束CE调度、同步ROM/RAM、单次写、RUN/STOP/STEP/RESET、每tick只读一致快照与节奏控制。
- [x] 复用OLED像素流，实现CPU状态只读可视化，不实现游戏规则或回写CPU RAM推进游戏。
- [x] 原87/57331及非法/访存、新系统/输入/控制/游戏回归通过，详细证据见后文。
- [x] F模式综合/布局布线/STA/CDC/资源审计、bit/JTAG/UART；用户确认游戏、慢速键位、F04短按改善。
- [x] V3八份技术报告已落盘并更新F04/变体信息；严格模式限制明确。
- [x] 独立乱序食物变体已实现、315场景差分、实机66tick/12份全RAM对照通过，原版保留。
- [x] 用户在首次GitHub发布任务明确确认两游戏实机通过，整体功能阶段报告m20_phaseV3_20261104.md完成；不扩展为实体157或全条件时序通过。

## 设计决定与风险

优先一个50MHz全局时钟，CPU用CE提交；多周期约束必须对应已验证的输入稳定窗，不能用全局false_path掩盖。ROM不添加CPU IR，保持CPU执行期间原字；RAM状态只由CPU写，显示另用只读端口/停止边界快照。硬件调试采用ILA或可完整快照/事务记录的UART等价接口。

## 恢复入口

先检查根进度及git diff，保留现有未提交OLED/V3代码与clockInfo.txt、tight_setup_hold_pins.txt（后两项非正式源码）。实现、仿真、实机均已有证据，不重新生成覆盖旧目录。当前板上snake_shuffled_r1，原版F04 functional_r6保留。打开M20_V3_SNAKE_SHUFFLED.md、变体manifest、hardware_snake_shuffled.json；下一步收集新食物分布体验，用户正式阶段确认后按模板写docs/reports报告及索引。无新的commit/Tag授权，不操作Flash或远程Git。

## 2026-11-04 实际验证检查点

- core_r1：F模式原87场景/57331事件与V1/Python一致，27840算术、50521非法TRAP及恢复、7访存专项通过。生成器逐项477连接校验通过。
- system_r5：F/严格MUX数字模型40398次提交边界一致，129帧，STOP/STEP/运行/停止复位/速度切换通过；两游戏各64tick完整256nibble与Python一致。
- board_r4：复用真实SSD SPI接收模型验证两游戏像素及6实体键映射，真实UART3918字节/6条完整JSON，UART控制STOP/STEP/选游戏通过。
- STRICT_MUX实际Vivado strict_r2保留543LUT3，综合及P&R完成，但85项LUTLP-1违规，故未生成bit/未下载；全部日志/DRC保留，不加ALLOW_COMBINATORIAL_LOOPS。该次是两周期复位调度的中间版本，反馈网络与当前仍相同；当前F有3周期复位释放修正。
- core_strict_r1尝试同样完整套件：ISA阶段通过，datapath反向注入初态后PC与参考不一致，未宣称87严格模式全套通过；从真实RESET启动的129帧F/S模式一致证据独立保留。强制初始化与反馈网络的交互仍待核实；不是已经证明CPU算法错误。
- functional_r1综合/P&R/DRC0，但WNS=-7.059ns，路径是游戏帧定时器runtime除法（并非CPU）。未生成bit；改为两个编译期常量除法再选择，不改ISA/CPU；functional_r2及system_r6/board_r5正在验证。未用多周期/false_path掩盖该失败。
- Python163项通过（build/m20_v3_python_r1.log）。当前新模块/脚本尚未提交，没有V3tag或远程操作，尚未对CPU实机下载。

关键原始日志：build/fpga/m20/cpu_validation/{STRICT_MUX,strict_r2,FUNCTIONAL_STORAGE,functional_r2}；sim证据build/sim/m20_v3/；控制台/tmp/swcell_v3_*.console.log（最终需将必要摘要/索引落在工程build或文档中，不依赖/tmp长期存在）。

## 用户实机确认及易用性修改（2026-11-04）

用户已确认Pong显示/控制/反弹得分正常；Snake方向/反向拒绝/食物/死亡/B重启、游戏切换、暂停等“有效，都正常”。仍认为原30/10tick/s偏快，并要求实体KEY4中键不用于暂停，因五向键易误触。决定暂停改KEY5（A），KEY4无操作；逻辑K4仍读KEY5，游戏ROM预留该位不变。新默认Pong10tick/s、Snake5tick/s，CPU主动1MHz不变。

functional_r3（F02）已通过实机UART STOP、单步、停止复位、100k/500k/1MHz三速和Snake128tick全RAM对照，证据results/M20_V3/20261104_181159_controls_and_snake/verification.json。原F02源和bit保存；准备F03新配置，需重新仿真/实现/STA后下载，不覆盖旧结果。

## F04输入可靠性修改检查点

用户新增：食物一直沿中间横条依次出现、按一次有时无反应。核实冻结snake.asm为从旧食物后一个位置顺序查空，不是随机；保留ROM。短按问题存在5Hz轮询空隙200ms，20ms消抖后仍可能漏采；相反方向另受原ROM拒绝，不混同消抖。

新增rtl/common/swc_key_event_buffer.sv：bank0深度8方向按下状态FIFO、bank1动作sticky；只有真实CPU IN0/IN1退役才消费，phase0给呈现token。覆盖采样后新事件不能被旧ACK清掉、空队列采样与入队同拍不能重复、满队列同时出入、溢出饱和上报等。该逻辑是FPGA外设，不增加33位CPU或修改477网表。

inputs_r1单元通过；board_r8集成验证暂停时短按已松开仍送到CPU（监视实际IN0 ack），KEY4忽略/KEY5暂停/六键及OLED/UART通过；system_r9保持F/S40398提交及两游戏64tick完整RAM与Python一致。F04新bit functional_r5正在实现，尚未下载。原F03bit及全部源已快照。

UART M20V3F04：debug[94:91]队列占用、[90:81]10位饱和溢出计数、bit95溢出标志；其余CPU状态格式不变，旧F01～03保留兼容。LED7合并报告CPU周期错误或输入溢出。

用户已确认F04短按正常、明显改善。V3功能原型基础和输入修正已有实机认可；新要求固定乱序食物表，作为独立Snake软件变体实现，原snake.asm/ROM保持不变。表128唯一格子、CPU软件选择与跳过占用，RAM22/23存索引；不新增CPU状态或指令。原V3源/bit已快照，程序tick_done地址须随变体元数据参数传入，不能沿用316。

## 20:20 固定乱序食物完成检查点（优先于前文历史状态）

原始需求：用户希望预设乱序坐标，蛇身占用则跳下一项。独立软件SNAKE-SHUFFLED-0.1已完成，生成器tools/m20/v3_snake_shuffled.py，软件目录software/m20_300/variants/snake_shuffled_v0_1。128唯一位置、索引循环，额外2个软件RAM单元；ROM1295/4096words，tick_done313。原版368words及CPU/ISA不改。

|测试|命令/方法|状态|证据|
|---|---|---|---|
|Python|tools/test/run_python_tests.py及unittest discover|PASS，164项；末次postcontrol日志见build|build/m20_v3_python_shuffled_final.log；build/m20_v3_python_shuffled_postcontrol.log|
|原核心RTL|run_m20_v3_core.sh|PASS，87场景/57331事件、50521非法、27840算术、7访存|build/sim/m20_v3/core_r2/|
|同步系统RTL|run_m20_v3_system.sh|PASS，40398 F/S提交、129帧；原两游戏各64tick全RAM|build/sim/m20_v3/system_r11/|
|输入FIFO|run_m20_v3_inputs.sh|PASS|build/sim/m20_v3/inputs_r1/|
|变体V1/V3/Python|run_m20_v3_snake_shuffled.sh|PASS，315场景/154611事件/464505周期|build/sim/m20_v3/shuffled_r1/|
|变体板级|run_m20_v3_board.sh，显式传变体文件和断点313|PASS，SPI/6键/UART3918字节|build/sim/m20_v3/shuffled_board_r1/|
|综合|build.tcl显式--snake-rom/--snake-done 313|PASS|build/fpga/m20/cpu_validation/snake_shuffled_r1/|
|实现/STA|独立路由及STA|PASS，WNS0.735/WHS0.060/WPWS9.232ns、DRC0|同上timing.rpt、drc.rpt|
|路由结构审计|v3_route_audit.tcl|PASS，477 LUT3/33CPU FF/1 BUFG|同上route_audit/counts.json|
|实机|20:14:18 JTAG成功；control_test.py显式变体source|PASS，STOP/STEP/RESET/三速、Snake66tick/12份完整RAM一致，错误/溢出0|results/M20_V3/20261104_201445_snake_shuffled/|
|新食物体验|用户试玩|NOT_RUN，尚无回复|不把UART结果当作人工确认|

当前bit：build/fpga/m20/cpu_validation/snake_shuffled_r1/swcell_m20_v3_top.bit，SHA256 d58128b860ff512fd0bb36b6ae70afa35496844b098c39df6b27bf2e77eb3440。新实机raw SHA256 55cbab6e1f415e82e45e4b9a977b5faae16f4f9dc88f22b5aebee694d2457d45。实际食物10,3→2,6，新增表索引0→1、长度3→4；12份全RAM匹配并不代表板上已经遍历128个食物。

所有主要新增源/测试/报告尚未提交，main HEAD70daf6f；不创建V3 Tag。历史core_strict_r1、strict_r2、functional_r1失败保留；本次没有改它们的结论。原版F04 bit及源在functional_r6保留，原始599条/600s采集及用户短按确认均保留。新功能小型证据在docs/m20/v3_resources/snake_shuffled_*，只含汇总/CSV/哈希，构建缓存/大波形/原始数据不纳管。

## 六键游戏选择方案咨询

用户询问能否取消暂停、改用六键切游戏。实际核对：KEY7选择ROM并复位、KEY5切RUN均在FPGA板级top；CPU仍只有六逻辑键。两款CPU程序的IN1 bit0（A）未用于游戏规则，Snake只检查IN1 bit1（B）重启。建议四方向＋KEY5/A切游戏＋KEY6/B重启，暂停保留UART空格；不增加CPU输入或157、不改ISA。此处是方案说明，尚未修改RTL/镜像；如果希望切换本身也由CPU程序执行，需要另建合并ROM/菜单软件并验证，不与当前FPGA切ROM机制混同。

## F05键位互换实施中

用户明确要求“先将切换游戏和暂停位交换”：KEY5/A切游戏，KEY7暂停/继续，保留暂停功能。仅交换板级select_request/run_toggle两个按键来源，UART命令不变；F05标识及Python兼容同步更新，原F04原始证据/bit保留。板级测试新增物理A切Snake且RUN不变、KEY7暂停不切游戏、暂停时A切回Pong仍暂停、KEY7恢复不切游戏的断言。

当前未验证修改：top两键及F05版本、TB期望、PythonF05兼容。运行中：build/sim/m20_v3/swapped_keys_r1/、build/fpga/m20/cpu_validation/snake_shuffled_keys_r1/；Python build/m20_v3_python_swapped_keys_r1.log。STA/仿真通过前不下载；继续使用乱序变体ROM和313完成断点。无CPU/ISA/软件修改。

### F05完成检查点（取代上一段运行中状态）

- [x] XSIM编译/elaboration/板级互换断言、6键/短按/SPI像素/UART3918字节PASS：swapped_keys_r1。
- [x] Python164项PASS：build/m20_v3_python_swapped_keys_r1.log。
- [x] 综合/布局布线/STA/DRC PASS：snake_shuffled_keys_r1，WNS0.849/WHS0.042/WPWS9.232ns、DRC0；8789LUT/5986FF、4RAMB36/1RAMB18/4LUTRAM，DSP0。
- [x] CPU路由477逻辑LUT3/33原生FF/1BUFG；22输入SHA、25引脚核对PASS；与F04比较，top只有按键来源/版本变化，其余21输入SHA不变。
- [x] 21:00:11 JTAG下载成功；bit SHA256 8143bb2d4b1a38ebdd65b06ec15d9dcc65151dc03e8a746ccf22557413e16afe。
- [x] UART60有效记录/1未识别启动行，错误/溢出0，当前Pong；results/M20_V3/20261104_210020_swapped_keys_f05/，raw SHA256 f7a472d18587f5bdab4948f2fe66a9209234ed71a1319de23dcb0b2b509b161a。
- [x] 用户后续确认F05互换“符合预期”；另要求BOOT页改KEY5入口，由F06独立处理。互换实现及下载子任务COMPLETED，V3整体正式验收仍待收尾。

当前操作KEY5/A切游戏、KEY7暂停/继续，KEY6/B重启、KEY4无用；暂停切换后仍暂停。详见M20_V3_KEY_SWAP_F05.md，关键记录和哈希在v3_resources/f05_*。原F04 bit及历史失败保留，不commit/Tag/远程Git/Flash。

## F06启动页KEY5入口实施中

用户确认F05新键位符合预期，但“M20 CPU”页面仍需KEY7进入，要求该入口也改KEY5。先只读采集8条复现：build=F05，frame_valid=0/run=0/PC0/FETCH，计数稳定，错误0；results/M20_V3/20261104_boot_entry_diagnosis_r1/。这是暂停后复位、尚未生成游戏快照，不是独立菜单；未断言用户确实断电或Flash版本错误。

F06策略：frame_valid=0时KEY5恢复当前游戏，不切ROM；KEY7只在frame_valid=1游戏页承担暂停/恢复。默认自动启动不变、UART控制不变；暂停时切换仍先保持暂停，BOOT后再按KEY5进入。无新增CPU状态，依赖已有frame_valid/run_requested。OLED BOOT第二行显示KEY5: START。F05原始PASS及用户确认保留。

当前修改top/显示/TB/版本兼容尚待验证。板级boot_entry_r1及实现snake_shuffled_boot_r1运行中；不能在仿真/STA失败时下载。无CPU/ISA/机器码改动，无Flash/远程Git/commit/Tag。

### F06实现与下载完成检查点

- [x] 164项Python PASS，build/m20_v3_python_boot_entry_r1.log。
- [x] boot_entry_r2 XSIM编译/elaboration/集成PASS：暂停复位BOOT、KEY7不启动、KEY5进入当前游戏不切ROM、第二行提示真实SPI像素；2Pong/1Snake/1BOOT帧、5877 UART字节，正常互换/短按/单步检查保留。
- [x] boot_entry_r1失败保留：旧测试在Snake初始化尚无快照时期待KEY7暂停，新定义该页KEY7不启动；r2等待实际游戏快照后再验证暂停，不放宽产品断言。
- [x] F06综合/实现/STA/DRC PASS：snake_shuffled_boot_r1，WNS0.982/WHS0.062/WPWS9.232ns、DRC0；8774LUT/5986FF、4RAMB36/1RAMB18/4LUTRAM、DSP0，477CPU逻辑MUX/33原生FF/1BUFG不变。
- [x] 22输入SHA、25引脚校验；除top/显示外20个构建输入与F05未变；源快照保留。
- [x] 21:27:31 JTAG成功，bit SHA256 972d8ebc5378c244ce5f530be9c8f0b0c9b04853c6c56576c82f96e995d79c49。
- [x] F06 UART75条有效/1未识别启动行，错误/溢出0；明确发送空格＋r暂停/复位，BOOT页等待已复现。results/M20_V3/20261104_212750_boot_entry_f06/，raw SHA256 0b89238f60ea046d27febdc2baae0336523ec5c70f777a5b8f34b699a1801f63。
- [x] 用户后续明确确认新BOOT入口“已经完全正常了”，并说明为本次JTAG下载后或切游戏后的页面。人工确认独立保存，不将75条等待快照当作按键轨迹。F06入口/键位子任务COMPLETED。

F06当前启动行为及复现命令见M20_V3_BOOT_ENTRY_F06.md，证据与哈希在v3_resources/f06_*。默认JTAG启动自动运行不变，测试期间主动停在BOOT供KEY5试玩。F05互换已用户确认；旧Tag/原始证据/软件/CPU不改，无本轮Git提交。

### F06人工验收完成

2026-11-04用户确认“已经完全正常了”。仅落盘人工确认JSON及正式报告docs/reports/m20_phaseV3-F06_20261104.md，更新报告/README入口和任务；不改RTL、不重构建、不重新下载、不改变原采集和测试结论。已核对f06_evidence_sha256.csv全部原指纹一致、板级PASS及164测试日志存在。新报告限定FUNCTIONAL_STORAGE启动/按键交互；未推定实体157时序或全部V3最终冻结、未提交Git/Tag。恢复时无需重复F06修复。

## 后续整体确认与Private发布

用户在最新发布任务明确确认V3 FPGA上CPU、按键、OLED、Pong/Snake已通过。整体FUNCTIONAL_STORAGE子任务COMPLETED，正式报告docs/reports/m20_phaseV3_20261104.md，代码commit8fab9f6及Tag m20-v3-fpga-hardware-verified已发布至Private boksop/swcell。早期“待整体确认/不提交”保留为历史检查点，不能阻止最新授权；实体157时序及STRICT_MUX仍开放。

发布后工具origin兼容修正仅改审计策略，不动F06硬件代码；新远程检出170项Python和源/ROM再生成通过，干净核心/板级XSIM与综合通过。恢复入口为根TASK及docs/GITHUB_PUBLISH_REPORT.md；不重复实现或重新下载本阶段，不自动做后续功能/PCB工作。
