boksop/swcell/docs/tasks/m11-phase2b-20261016.md

# M11-PHASE2B-20261016：75/100/125MHz独立扫描与可靠性验证

## 当前任务

- 状态：**COMPLETED（实现、回归、实物采集和分析完成；待用户正式验收，不是所有频率全面PASS）**。
- 更新时间：2026-10-17 06:35:03 +0800。后台runner于`2026-10-17T02:22:00.486885+08:00`正常结束；本次恢复已核实无遗留控制器，不要重复启动。
- 目标/范围：75/100/125MHz独立Q/QM各16点、全部窗口、中心0101/0011、PRBS1e6→门控1e8、可恢复采集与离线图表。在既有Phase1/2增量开发。
- 非目标：Flash、完整setup/hold、温压扫描、GUI、其它模块；32点扫描为可选，未实现。
- 分支：`main`尚无首个commit；用户仅授权初始化及暂存四份进度文档，其它源码仍未跟踪。
- 完整图文参数/测试/证据见[验证总结](../m11/phase2b_validation.md)，[使用与文件清单](../m11/phase2b.md)，根入口[TASK_PROGRESS.md](../../TASK_PROGRESS.md)。

## 完成清单：已修改、已验证

- [x] 复用静态MMCM/ODDR/独立Q/QM IOB架构；相位真实改变采样边沿，重配后重新初始化。
- [x] M11 engine本域启动同步、reference早相位相同事务标签；无任意延后参考周期。
- [x] UART固件m11_hs_v2_2两路独立首错，旧v1/v2兼容；Python真实日志解析通过。
- [x] 构建脚本逐镜像STA/DRC/ILOGIC门控；局部复位PRE例外，保持内部数据计时。
- [x] Python独立双轴、全窗口/参考边界、分级门控、原始校验/恢复、CSV/JSON/三图/报告。
- [x] 三频率共96个轴测点实采；无UNSUPPORTED、无漏扫QM；另一轴错误未中止当前轴。
- [x] 每频率0101、0011、PRBS百万次及亿次两路均零错，窄窗频率结论保持MARGINAL。
- [x] 全部XSIM回归PASS；最新Python52项PASS；105个独立镜像综合/P&R/STA/DRC通过。
- [x] 最终离线重建和108个有效job的raw/bit/source/计数/偏移/时序证据核验PASS。
- [x] 更新README、验证总结、3张文档插图、根进度与任务详情；保留Phase1报告和全部旧诊断。
- [x] 可上传证据包约5.4MiB，含原始数据、源码、105个镜像文本报告和三份亿次镜像；逐成员SHA256读回复核通过，路径见验证总结。

**已修改、未验证：无当前已知功能修改。** 未完成的工程外部标定、125MHz裕量证明及用户正式验收不冒充已验证内容。

## 最终实测结果

|DUT频率|Q零错索引 / 点数|QM零错索引 / 点数|所选Q / QM|最终分类|
|---:|---|---|---|---|
|75MHz|9,10,11,12,13,14,15 / 7点|1,2,3,4,5,6,7 / 7点|12 / 4|`PASS_1E8_ZERO_ERRORS`|
|100MHz|12,13,14,15 / 4点|4,5,6,7 / 4点|13 / 5|`PASS_1E8_ZERO_ERRORS`|
|125MHz|15 / 1点|7 / 1点|15 / 7|`MARGINAL_WINDOW`|

每轴每点10000次；每频率36个job、35个独立镜像。亿次N/f分别1.333333、1.000000、0.800000秒；这是有效数据时长推导，不含主机JTAG/UART墙钟。最高可靠窗口亿次零错100MHz，最高观测125MHz，不是器件保证Fmax。逐长测结果及全部镜像最差WNS/WHS/WPWS见验证总结。

## 关键设计决策

|决策|依据 / 必须保持|
|---|---|
|多静态bitstream|MMCM/BUFG/ODDR，Q由CLKOUT2/2B、QM由3/3B，各独立；不在运行中切Fabric时钟MUX|
|16点 / 最少3点可靠窗口|75/100/125MHz步进833.333/625/500ps；1或2点保守MARGINAL，全部候选窗保留|
|参考事务边界|D于nT+T/4发b[n]；Q=b[n−1]，QM0..7=b[n−1]、8..15=b[n]；Q15→0不合窗，QM7→8不合、15→0可合|
|PRBS31|x^31+x^28+1，左移反馈bit30 XOR27，输出旧30，seed13579bdf；冻结/停止不得误推进|
|统计 / CDC|两路64bit本域计数；完成冻结256bit快照，done同步+额外稳定等待；禁止逐位同步递增计数器|
|时序例外|只对未知外部pad→IOB及首级控制同步、复位同步PRE端局部例外；所有内部数据路径保留STA|
|频率分类|可靠多点窗口+模式/百万/亿次门控才频率PASS；125MHz亿次单点零错仍MARGINAL|
|构建预算|--jobs2，仅预构建当前频率未完成点；扫描结束后本频率长测，再下一频率；避免OOM及预算额外+1|
|协议兼容|Phase1v1和旧v2仍解析；独立首错字段可选，不能破坏旧数据|

系统50MHz、UART115200、IO LVCMOS33 DRIVE12 SLOW；名义3.3V、实际V/T未知。相位ps为配置推导值，未标定绝对延迟。

## 测试与验证

|项目|命令/方法|结果|证据|
|---|---|---|---|
|语法/elaboration|xvlog/xelab|PASS|完整回归及各elab日志|
|Phase1/2/2B XSIM|`sim/scripts/run_all_regressions.sh`|PASS|`build/phase2b/regressions.console.log`，最终SWCELL_ALL_REGRESSIONS_PASS|
|独立模型 / 采样 / 周期故障|`sim/scripts/run_phase2b.sh`|PASS|`new_regression.console.log`；三频率双轴全点、外部可配置延迟、整周期故障|
|Python全套|`.venv/bin/python -m unittest discover -s host/python/tests -v`|PASS，52项|`build/phase2b/python_tests_final.log`|
|综合|105个静态镜像|PASS|各console/build_status|
|实现 / 布局布线|同上|PASS|各routed.dcp、DRC违例0|
|内部STA / IOB / CDC审查|逐镜像报告及只读核验|PASS（外部IO未标定）|`final_timing_audit.csv`、`final_evidence_audit.json`及各镜像报告|
|真实中断恢复|SIGINT后同目录--resume，保留中断attempt、跳过完成job|PASS|`resume_exercise.log`和resume系列控制台|
|实物测试|JTAG/UART完整矩阵及分级长测|75/100 PASS；125 MARGINAL|当前checkpoint/CSV/raw；不是总体三个频率PASS|
|离线分析 / 校验|`--analyze`及`build/phase2b/final_audit.py`|PASS|`final_offline_analysis.log`、`final_evidence_audit.log`|
|外部绝对延迟 / 电气时序|示波器和PCB延迟标定|NOT_RUN|超出本轮测量范围|
|用户正式验收|用户明确确认阶段通过|NOT_RUN|确认后才生成正式docs/reports报告|

## 后续动作与完成条件（不影响本轮任务完成）

1. 用户评审验证总结；正式确认通过后，按`docs/reports/stage_report_template.md`生成新报告并更新索引，保留125MHz MARGINAL边界。
2. 如安排125MHz裕量扩展，先定义更细网格、邻点重复及外部测量条件，再新建独立任务/结果目录；不得把本轮改成全面PASS。
3. Git完整源码纳管和首个commit尚未获授权；仅四份进度文档暂存，不自动add其它文件或commit/push。

## 证据与历史风险

- 当前源指纹 `b0209deae54271113fb461148b4a794d467ba2612ed6996ff19f13c1d16fb79b`；FPGA21文件归档`build/phase2b/source_b0209deae542.tar.gz`，SHA256 `ff5a3c3410c94a313fbbd33c9338d33eca04130e2a1358cf7796e0629a13e35c`。
- 当前完整目录`results/M11/phase2b_20261016_reset_sync/`，raw SHA256 `bcbcc762a6b4eaed474da83274722a0414112dd39d908ae42b2b14c4e25b4a56`。111条attempt保留108成功、2中断、1历史STARTED，latest_jobs均完成；另保留1个0字节孤立attempt，不计入统计。
- 旧88e源码轮次有复位PRE recovery −0.586ns正确拒绝；已与当前b020轮次隔离，诊断/局部约束依据见验证总结。更早25/50MHz结果保持历史边界。
- 真实闪退时曾出现checkpoint.RUNNING但进程消失；下次仍须核对PID/cmdline而非仅看字段。22:29内核OOM杀Chrome，VS Code闪退直接原因未证实；减至jobs2后完整结束。
- 快照CDC报告512项warning及外部输入/复位critical项经过结构审查，不称零告警；外部IO延迟仍未知。电压/温度null、没有保证Fmax。
- build/results受Git忽略，保留原始证据后才可清理；暂存不是提交历史或异机备份，不引用不存在commit。

## 下一次恢复入口

本任务实现、采集、分析均已完成，无后台扫描需要续跑。先读根文件、验证总结和本文件，核实Git/源指纹/结果hash；**不重新启动--resume或重跑已完成亿次测试**。仅离线核查可运行：

```bash
MPLCONFIGDIR=/tmp/swcell-mpl .venv/bin/python host/python/swcell_phase2b.py \
  --analyze results/M11/phase2b_20261016_reset_sync
.venv/bin/python build/phase2b/final_audit.py
```

没有已落盘未测试的功能修改；下一步是用户评审和按确认生成正式报告。新硬件测试使用新目录及明确条件，不改raw/原checkpoint，不写Flash，不自动提交Git。无可引用commit。

## 附录：完整扫描矩阵

### 已实采矩阵（当前b0209源码，最近核实 2026-10-17 06:30:48 +0800）

|频率MHz|轴/相位|固定另一相位|每路检查|Q错误|QM错误|WNS ns|WHS ns|
|---:|---|---:|---:|---:|---:|---:|---:|
|75|Q0|6|10000|5016|0|+3.468|+0.108|
|75|Q1|6|10000|5016|0|+3.465|+0.093|
|75|Q2|6|10000|5017|0|+3.259|+0.079|
|75|Q3|6|10000|5017|0|+3.253|+0.108|
|75|Q4|6|10000|5016|0|+1.895|+0.101|
|75|Q5|6|10000|5017|0|+2.534|+0.093|
|75|Q6|6|10000|5016|0|+2.994|+0.100|
|75|Q7|6|10000|5016|0|+3.460|+0.108|
|75|Q8|6|10000|5017|0|+3.359|+0.085|
|75|Q9|6|10000|0|0|+3.482|+0.108|
|75|Q10|6|10000|0|0|+3.208|+0.108|
|75|Q11|6|10000|0|0|+2.918|+0.108|
|75|Q12|6|10000|0|0|+3.549|+0.085|
|75|Q13|6|10000|0|0|+3.276|+0.085|
|75|Q14|6|10000|0|0|+3.134|+0.108|
|75|Q15|6|10000|0|0|+3.349|+0.108|
|75|QM0|12|10000|0|5016|+3.793|+0.085|
|75|QM1|12|10000|0|0|+3.839|+0.108|
|75|QM2|12|10000|0|0|+3.463|+0.085|
|75|QM3|12|10000|0|0|+3.598|+0.099|
|75|QM4|12|10000|0|0|+1.682|+0.078|
|75|QM5|12|10000|0|0|+2.685|+0.108|
|75|QM6|12|10000|0|0|+3.549|+0.085|
|75|QM7|12|10000|0|0|+3.548|+0.108|
|75|QM8|12|10000|0|5016|+1.808|+0.108|
|75|QM9|12|10000|0|5016|+2.493|+0.108|
|75|QM10|12|10000|0|5016|+3.180|+0.108|
|75|QM11|12|10000|0|5016|+3.550|+0.108|
|75|QM12|12|10000|0|5016|+3.483|+0.108|
|75|QM13|12|10000|0|5016|+3.567|+0.108|
|75|QM14|12|10000|0|5016|+3.521|+0.108|
|75|QM15|12|10000|0|5016|+3.714|+0.108|
|100|Q0|6|10000|5016|0|+2.386|+0.108|
|100|Q1|6|10000|5017|0|+2.392|+0.108|
|100|Q2|6|10000|5017|0|+2.416|+0.108|
|100|Q3|6|10000|5017|0|+2.247|+0.086|
|100|Q4|6|10000|5017|0|+1.018|+0.108|
|100|Q5|6|10000|5017|0|+1.498|+0.047|
|100|Q6|6|10000|5017|0|+2.280|+0.108|
|100|Q7|6|10000|5017|0|+2.161|+0.068|
|100|Q8|6|10000|5017|0|+2.163|+0.108|
|100|Q9|6|10000|5017|0|+2.286|+0.086|
|100|Q10|6|10000|5017|0|+1.978|+0.092|
|100|Q11|6|10000|2520|0|+2.253|+0.108|
|100|Q12|6|10000|0|0|+2.144|+0.067|
|100|Q13|6|10000|0|0|+2.127|+0.108|
|100|Q14|6|10000|0|0|+2.202|+0.085|
|100|Q15|6|10000|0|0|+2.012|+0.099|
|100|QM0|12|10000|0|5016|+5.203|+0.108|
|100|QM1|12|10000|0|5016|+4.926|+0.078|
|100|QM2|12|10000|0|5017|+4.470|+0.075|
|100|QM3|12|10000|0|5017|+4.886|+0.079|
|100|QM4|12|10000|0|0|+1.002|+0.108|
|100|QM5|12|10000|0|0|+1.518|+0.108|
|100|QM6|12|10000|0|0|+2.144|+0.067|
|100|QM7|12|10000|0|0|+2.748|+0.108|
|100|QM8|12|10000|0|5016|+1.101|+0.102|
|100|QM9|12|10000|0|5016|+1.495|+0.108|
|100|QM10|12|10000|0|5016|+2.221|+0.063|
|100|QM11|12|10000|0|5016|+2.730|+0.065|
|100|QM12|12|10000|0|5016|+3.444|+0.093|
|100|QM13|12|10000|0|5016|+3.883|+0.093|
|100|QM14|12|10000|0|5016|+4.518|+0.108|
|100|QM15|12|10000|0|5016|+5.179|+0.079|
|125|Q0|6|10000|5016|5017|+1.269|+0.108|
|125|Q1|6|10000|5016|5017|+1.445|+0.108|
|125|Q2|6|10000|5017|5017|+1.169|+0.085|
|125|Q3|6|10000|5017|5017|+1.256|+0.102|
|125|Q4|6|10000|5017|5017|+0.512|+0.108|
|125|Q5|6|10000|5017|5017|+0.964|+0.108|
|125|Q6|6|10000|5017|5017|+1.257|+0.108|
|125|Q7|6|10000|5017|5017|+1.276|+0.108|
|125|Q8|6|10000|5017|5017|+1.063|+0.108|
|125|Q9|6|10000|5017|5017|+1.277|+0.108|
|125|Q10|6|10000|5017|5017|+1.141|+0.108|
|125|Q11|6|10000|5017|5017|+1.202|+0.108|
|125|Q12|6|10000|5017|5017|+1.218|+0.108|
|125|Q13|6|10000|2509|5017|+1.076|+0.108|
|125|Q14|6|10000|2443|5017|+1.073|+0.108|
|125|Q15|6|10000|0|5017|+1.285|+0.107|
|125|QM0|12|10000|5017|5016|+1.256|+0.099|
|125|QM1|12|10000|5017|5016|+1.138|+0.085|
|125|QM2|12|10000|5017|5017|+1.260|+0.064|
|125|QM3|12|10000|5017|5017|+1.331|+0.108|
|125|QM4|12|10000|5017|5017|+0.407|+0.108|
|125|QM5|12|10000|5017|5017|+1.044|+0.070|
|125|QM6|12|10000|5017|5017|+1.218|+0.108|
|125|QM7|12|10000|5017|0|+1.537|+0.085|
|125|QM8|12|10000|5017|5016|+0.638|+0.108|
|125|QM9|12|10000|5017|5016|+1.041|+0.092|
|125|QM10|12|10000|5017|5016|+1.190|+0.078|
|125|QM11|12|10000|5017|5016|+1.259|+0.108|
|125|QM12|12|10000|5017|5016|+1.309|+0.108|
|125|QM13|12|10000|5017|5016|+1.282|+0.108|
|125|QM14|12|10000|5017|5016|+1.289|+0.085|
|125|QM15|12|10000|5017|5016|+0.845|+0.108|

表中Q/QM是每条轴记录的两路原始错误数；判断窗口只使用当前轴。逐点首错、hash和完整build路径见CSV/checkpoint。
