boksop/swcell/docs/tasks/m20-v24-release-20261104.md

# M20-V24-RELEASE-20261104：有条件数字验收与本地定版

2026-11-04，COMPLETED（本地定版，最终tag以Git解析）。用户明确批准V2.4有条件数字验收，并授权本地commit及annotated tag `m20-v2.4-digital-verified`；不进行远程Git、V3、PCB或实机。

## 已核实

- [x] main原HEAD5e601a9；V23 tag对象及目标已快照；无remote；本仓库作者boksop <boksop@163.com>。
- [x] 原90份stage逐文件检查，均属V24历史116/前馈A/B开发；保存索引原件、各blob和SHA至 `build/m20_300/v24_release_20261104/`，不reset索引。
- [x] 206份V23保护源及C/D源指纹、8089原始文件SHA重新核对；未改ISA/CPU/发生器/旧数据。
- [x] 清单审计发现旧632实验入口依赖ignored历史build。保留原入口，新纳管157071字节原79见证JSON及来源，新独立重放入口使用相同网表/模型/判据；一键C/D入口仅改调用，不修改CPU/测试预期。
- [x] 新独立632重放、全151Python（12.858s）通过；干净恢复另执行。
- [x] 正式阶段报告、纳管/排除清单及当前release源指纹已建立。
- [x] 原90 stage历史快照提交86fdc9e，90个blob完全一致。
- [x] 完整当前版本提交4a95665，干净夹具修复80593a1；无amend/rebase。
- [x] 最终干净检出151测试、56/632负测、B/C门禁、7份生成文件/563计数通过；最终文档和annotated tag按本记录完成。

## 决策及范围

不伪造开发时间点。原90 staged blob逐字保存为独立“历史候选/A-B开发快照”提交；其旧TASK反映当时进度，完整正式版本提交包含当前进度和最新接口。历史候选与失败证据是版本树中的历史资料，不属于tag认可的物理时序保证。

新入口隔离“历史证据重新审计”和“固定向量负测重放”：原review保留原用法，clean源码可用版本化79向量独立重跑632例，并逐项比较每个错误path ID，不能只看有非零错误。负测既有24问题配置及131局部错误不改判。

忽略build/虚拟环境/XSIM数据库/大波形/bitstream；正式生成SV/JSON、参数、关键结果CSV/JSON、图和复现脚本纳管，原始数据原位保留＋SHA索引，不上传。

## 验证与恢复

最后证据 `build/m20_300/v24_release_20261104/`；新负测 `build/m20_300/v24_ff16/release_versioned_replay_20261104/`。提交前检查两个进程/日志已完成，避免在Python测试检查索引期间修改Git。下一步完成正式报告和明确路径清单，先历史再当前commit，最后恢复验证和tag。无远程、无rebase/amend/reset/clean，不覆盖V23 tag，不重写历史数据。

## 干净恢复发现的测试夹具依赖

首轮151测试：149通过、2个“拒绝覆盖既有输出”断言失败，原因是干净树中`small_r4`/`session_20261103`不存在，不是CPU失败。日志`clean_python_initial_FAILED.log`保留。冻结V23及测试文件不修改；新增`tools/test/run_python_tests.py`仅在缺少时创建受控空目录夹具，结束后只rmdir自己创建且仍为空的目录；不复制历史数据，不删除任何已有文件。一键system使用该入口，待重新实际验证后再tag。

## 最终恢复结果与后续入口

最终干净树80593a1：151测试PASS/13.309s，创建2受控空目录夹具后清理；56仍24问题、632仍131错误；B/C内存/控制/最小CPU通过。7生成件字节一致、513技术指纹及206V23保护匹配。记录`docs/m20/v24_release_resources/recovery_validation.json`，原始SHA索引相邻；旧失败日志不覆盖。最终标签`m20-v2.4-digital-verified`只代表条件数字验收，目标commit以Git解析，最后提交不改逻辑。

下一会话先读根TASK、定版报告和Git状态，不重复commit/tag；不移动V23标签、不改失败为PASS。阶段已完成，等待用户下一项任务；本轮不继续V3/PCB/实机/远程。原90stage已完整历史提交86fdc9e，当前不应有遗漏未提交非忽略文件。两个本次创建的detached worktree及其新证据保留在build，未清理原数据。
