boksop/swcell/docs/tasks/m20-v24-b-review-20261104.md

# M20-V24-B-REVIEW-20261104：前馈时序深化评审

更新2026-11-04（Asia/Shanghai）。**COMPLETED：本轮分析/评审交付；V2.4整体未验收，C/D不准入。** main HEAD5e601a9、V23 tag目标aecf570保持。

## 范围

用户要求先复核56组，再分解根/叶裕量、扫描TAP16包络、核对79真实短路径，最后评审20颗架构。保留固定16级/四tap/20颗、543核心/ISA/机器码、原A/B/17/116历史。禁止本轮完整CPU、PCB、远程Git和新验收tag。

## 已完成与验证

- [x] 旧10源码/116输入/272证据SHA及XSIM日志逐项校验，56＝32 CONDITIONAL＋24 FAILED，normal为3/8/10/11，原数据不改。
- [x] 根/叶重新计算；7ns损失为原假设聚合分配3ns＋锁存有效差4ns，PCB/跨芯片/输出skew未被独立辨识。输出6,864叶事件、113,256配对、104方向最坏记录。
- [x] 新 `ff16_review.py` 输出816链延迟、784独立分配/有效边界、144频率点及译码/控制/安全包络。全部min和系统偏差assumed；五款Buffer原厂资料及未知字段在 `config/m20/ff16_buffer_sources.json`。
- [x] 79组历史轨迹、source翻转/side条件/实际route/目的布尔影响重验。含4层4组、5层17、6层14、7层17、8层27。
- [x] 原477连接生成局部模型，仅两位活动反馈双MUX状态、其余固定历史见证；632次实际XSIM。名义316次全一致；压力0.125/0.25/0.5/1ns每级分别79/52/0/0次错，共131。不是全CPU回归。
- [x] Python146项PASS（12.571s，原142保留），新4项覆盖原证据对照、1089配对、独立分量和Buffer指标口径。
- [x] 四份新中文分析/评审、三份既有报告追加新证据入口；图表/CSV/JSON/原始SHA/本地证据包落盘。
- [x] 字节保护、Git索引保护、文档链接/JSON/CSV/SVG及脚本语法检查，详见新resources/review_validation.json。
- [x] 用户追加“有效非重叠D1/D2—79条短路径错误数”图： `tools/m20/plot_ff16_margin_errors.py`只读提取原632条，输出8点CSV、PNG/SVG及SHA；现有−2/22ns两组不插值，未独立扫描D2或新增CPU仿真。图在 `ff16_review_resources/margin_error_relation/`，生成后实际查看与数据核验通过。

## 结果与决策

保持20颗主线，不增加延迟级。平衡译码家族R(τ)=max(τ−3,0)；L=7ns时，guard0/4/8需每方向累计链至少10/14/18ns。TAP16平均每级min分别0.625/0.875/1.125ns。它们不是原厂保证，也不能覆盖任意译码不匹配角落。

没有发现需要改变20颗布尔连接才能规避的SAFE_HOLD问题，但任意解除不安全；FPGA需合格窗口/初始化/周期身份/写事务状态。当前仅设计契约及原小测，完整控制器NOT_VERIFIED。保留20颗，不准入C/D，不能只降低参考频率或用0.5ns/级未错替代全局A约束。

## 验证表

|项目|方法/命令|结果|证据|
|---|---|---|---|
|证据复核/扫描/79条件|`python -B -m m20.ff16_review --output <fresh-build-dir>`|PASS计算，时序仅CONDITIONAL|deep_review_r4/baseline_review.json及分析CSV|
|局部SV语法/elaboration|run_m20_ff16_review.sh自动xvlog/xelab|PASS|deep_review_r4/xsim/compile.log/elaborate.log|
|632局部实验|`M20_FF16_REVIEW_OUTPUT_DIR=$PWD/build/m20_300/v24_ff16/deep_review_r4 bash sim/scripts/run_m20_ff16_review.sh` 已执行，勿覆盖|PASS引擎/正对照；压力131 FAILED|cone_verification.json、cone_results.csv、xsim/cones.log/VCD|
|Python全量|`PYTHONPATH=host/python build/venvs/python312/bin/python -B -m unittest discover -s host/python/tests`|PASS，146项|deep_review_r4.python.log|
|冻结/旧证据/索引|SHA、tag逐字节、git ls-files --stage前后比较|PASS|review_validation.json|
|SAFE_HOLD完整控制/RAM事务|只评审，未实现本轮控制器|NOT_RUN|架构评审的控制契约|
|完整CPU/综合/实现/STA/硬件|明确不执行|NOT_RUN|没有借用V23或旧116 PASS|

deep_review_r1保存首次分析和资料获取记录；直接下载四份PDF遇HTTP403，但已通过web工具阅读原厂PDF，未伪造本地PDF SHA。TI原厂PDF另在r1/sources保存。deep_review_r2保留新TB实数字面量编译失败及源码；修正后r3运行，r4增加完整配对/包络后作为最终依据。原small_r1～r4不覆盖。

## 文件与恢复入口

- 主报告 `docs/m20/M20_V24_ARCHITECTURE_REVIEW.md`。
- `M20_V24_TIMING_SENSITIVITY.md`、`M20_V24_CLOCK_TREE_BUDGET.md`、`M20_V24_REAL_CPU_SHORT_PATH_ANALYSIS.md`。
- 新代码 `host/python/m20/ff16_review.py`、`tools/m20/ff16_review_{xsim,evidence}.py`、`sim/m20_ff16_review/`、`sim/scripts/run_m20_ff16_review.sh`、`host/python/tests/test_m20_ff16_review.py`。
- 原始新运行 `build/m20_300/v24_ff16/deep_review_r4/`；摘要 `docs/m20/ff16_review_resources/`。完整30文件12,374,519字节有索引，数据包853,192字节/SHA df1c3d4fe827d76fb68dfb35a0cc7afa24b5fb2eaeb180e57400259a016ded9b，未上传。

本轮不改Git索引，原90份暂存blob保持；新增交付暂未暂存/提交，已有报告与进度的工作文件有新修改。不能直接commit整个索引；无新tag/远程操作。旧A/B任务仍保持未验收状态。

下一项须由时序/控制边界评审决定：获取或明确批准链min/max、全部叶端分配/有效开闭边界和控制预算，按小型门槛再验证。硬件测量需要用户安排，本轮未执行；不得自动进入87场景或改CPU来通过。若只是复现，使用全新输出目录运行上述脚本；不得改原配置匹配SHA。
