boksop/swcell/docs/tasks/m20-v24-ff16-20261103.md

# M20-V24-FF16-20261103：固定16级前馈发生器

更新2026-11-04（Asia/Shanghai）。状态 **IN_PROGRESS / STOP_BEFORE_C_AND_D**。main HEAD `5e601a99019f09d2ca59360165106e089826415b`；无本轮commit或验收tag。

后续[B深化评审任务](m20-v24-b-review-20261104.md)已完成独立分析和局部实验交付，仍不批准C/D。本文件保留原A/B检查点；恢复以新任务和根TASK_PROGRESS当前入口为准，不重复原56组。

## 当前目标与范围

用户指定NC7SZ157P6X、3.3V，固定16级链、TAP4/8/12/16静态0Ω选一；2译码＋2SAFE_HOLD共20颗。CPU543/ISA/机器码不修改。先A结构和B独立延迟/小型反例，通过可信条件后才C存储和D完整回归。全部tap在未排除角落失败时必须停止报告。

非目标：PCB/新选型、M0～M19、FPGA工程/bitstream/实体测试、V23重定版、17/116候选继续优化、Git远程或新V24验收tag。

## 已完成：已修改且已验证

- [x] `rtl/m20/v24_ff16/`：纯MUX原语与固定20颗结构，四tap仅静态接线，未删后级、无状态/反馈。原参考SHA一致，无需改极性。
- [x] `host/python/m20/ff16_structure.py`独立SV/引脚/DAG/计数审计；9项结构测试；导出20连接、0Ω装配、负载和信号表。
- [x] `sim/m20_ff16_static/`实际XSIM 24项真值/四tap/末级存在检查。
- [x] `sim/m20_ff16/`逐芯片DATA/SELECT独立上下降、33叶端开/关与Buffer/skew、真实双MUX锁存、跨位流水反例。原语自测能实际检出上下两个方向穿透。
- [x] `ff16_timing.py`及 `run_m20_ff16_small.sh`完成14场景×4tap；完整脉冲重汇合min/max解析与实际时间一致，未删失败角落。
- [x] 最终small_r4完整结束；32 CONDITIONAL、24 FAILED；全部fast_chain_sensitivity为负全局裕量，各有4次流水错误而自身重叠为0。门禁STOP_BEFORE_C_AND_D。
- [x] 全部Python142项PASS（12.608s），包含新增9结构＋6时序工具测试。输出 `build/m20_300/v24_ff16/python_all_20261104.log`。
- [x] `tools/m20/ff16_evidence.py`实际整理272份原始证据、图表、两寄存器见证和本地tar.gz；所有原始文件/数据包SHA复核一致。
- [x] 8份 `docs/m20/M20_V24_{FEEDFORWARD_ARCHITECTURE,DELAY_TAP_DESIGN,TIMING_MODEL,NONOVERLAP_VERIFICATION,SAFE_HOLD_CONTROL,FPGA_MEMORY_TIMING,MUX_AUDIT,TEST_REPORT}.md`及来源/边界JSON完成，链接/JSON/CSV/SVG及shell语法检查通过。
- [x] 独立只读复核10源码/116输入/206冻结文件、实际反例时间和充分条件；修正文档的SAFE_HOLD描述与额外检查次数，没有改变模型/断言/原始数据。

## 尚未执行与完成条件

|优先级|具体下一步|完成条件|依赖/阻碍|
|---|---|---|---|
|P0|评审 `parameter_sources.json` / `parameter_envelope.json` 的链最小延迟与叶端开/关差|建立每方向可接受边界，或先提出20颗以内修正方案|datasheet没有所需保证min；不能直接排除0.5ns敏感性|
|P0|若获合理边界或修正方案，在新目录重跑小型A/B|保留原反例且模型能检错；合格tap在明确条件内满足D1/D2、透明窗和功能要求|不要覆盖small_r1～r4，也不以CPU运行替代交接检查|
|P1|C：按 `M20_V24_FPGA_MEMORY_TIMING.md`建立快服务事件/稳定总线采样|最小LDI/LD/ST/OUT、地址变化和7组事务/复位通过；写一次、停钟不重复|先通过B门槛；f_micro=f_REF，不能复用Johnson除8事件|
|P1|完整SAFE_HOLD/RESET/STOP/STEP控制|持续外部参考、请求相位、复位和RAM提交有日志/断言|当前只有手动延长窗口的保持/恢复小测|
|P2|D：模式A/B/C冻结CPU完整对照|49CPU＋38游戏/57331事件、50521非法终态、64tick及原异常回归，分别列零延迟/带延迟|C与B先通过；ISA/477组合网表/33状态不可改变|

上述未执行项没有伪装成“已实现未验证”。当前最终A/B源码都有对应实际仿真或工具运行；存储/控制文档只是设计要求，尚非实现。

## 关键决策与已知风险

1. 物理固定20，不因tap改变；543＋20＝563不含Buffer/FPGA控制。四tap只模拟静态装配，不能热切换或多个0Ω短接。
2. 全局D1=min所有SlaveOpen−max所有MasterClose；D2反向，覆盖33×33最坏组合。只同位检查不足，实际跨位反例已出现。
3. 惯性数字模型可取消短脉冲；不模拟电压/亚稳态，多毛刺不能简化为完整脉冲公式。锁存有效开关不是原厂保证，全部自行配置最低值均assumed。
4. 4ns guard和100ns小测Master窗口是测试假设，不是CPU或实体setup/hold。所有物理结论NOT_VERIFIED。
5. nominal D1/D2=8/16/24/32ns；fast_chain=−7/−6/−4/−2ns。TAP16仅在11组normal_assumed中最坏6ns，不能据此批准实体配置。降低参考频率不消除同边沿负裕量。
6. SAFE_HOLD正常例在C/Cd稳定高、Slave更新已稳定且仍透明时钳位，拉长参考高窗口；监视全程启用。晚释放每tap漏1窗/错1次。它不证明完整单步或RAM事务正确。
7. 新服务应使用较长稳定窗口和明确截止时间，不要求在短死区内完成BRAM；外部源与FPGA关系须独立约束/CDC预算。当前C/D均NOT_VERIFIED。

## 测试与证据

|检查|命令/方法|结果|证据|
|---|---|---|---|
|固定20连接/无环|`python -B -m m20.ff16_structure --output <fresh-build-dir>`|PASS / VERIFIED|small_r4/structure；docs/m20/ff16_resources/structure_audit.json|
|SV语法/elaboration|XSIM入口自动xvlog/xelab|PASS|small_r4/xsim/compile.log、各elaborate.log|
|实际SV静态24项|run_m20_ff16_small.sh内structure快照|PASS / VERIFIED|structure.log的vectors=24|
|独立延迟/双向穿透自测|同入口pin_model快照|PASS / VERIFIED|pin_model.log标记actual_penetration_directions=2|
|14×4场景|`M20_FF16_OUTPUT_DIR=$PWD/build/m20_300/v24_ff16/small_r4 sim/scripts/run_m20_ff16_small.sh`（已执行，勿原位重跑）|FAIL时序门槛；32 CONDITIONAL / 24 FAILED|timing_results.csv、small_verification.json、全部cfg/trace/错误CSV|
|Python全量|`PYTHONPATH=host/python build/venvs/python312/bin/python -B -m unittest discover -s host/python/tests`|PASS，142项|python_all_20261104.log|
|证据/源码完整性|逐文件SHA256、protected tag逐字节、JSON/CSV/SVG/相对链接|PASS|ff16_resources/additional_checks.json|
|新FPGA存储/完整控制/CPU|未运行，按用户门禁暂停|NOT_RUN|project_gate=STOP_BEFORE_C_AND_D|
|综合/实现/STA/硬件|本轮未要求执行|NOT_RUN|不以仿真替代物理签核|

small_r1有SV字面量编译失败，small_r2发现重汇合预测公式错误，均保留；修复后r3完整运行，再增强oracle/证据后r4作为最终依据。不要删除失败目录或反向改变V23 PASS。

原始目录 `build/m20_300/v24_ff16/small_r4/`，272文件/5,258,980字节有索引。汇总SHA `e9a12918974062d4e970a5f6e8075879724a622f383d92978fb4a83d82097aab`。本地数据包 `small_r4_evidence.tar.gz` SHA `ec6ae1e549db0e3fc4f85373f9d1434878cd3fcf3f863d9af72a64f492dcd652`；未上传。文件清单、参数、图、索引在 `docs/m20/ff16_resources/`，原始构建缓存仍忽略。

## Git与冻结边界

V23 tag `m20-v2.3-two-phase-sim-verified`仍指aecf570，206份指定保护范围已有文件与tag一致；V23正式报告另与HEAD一致。没有修改CPU/ISA/ROM、V23源码/报告/原始证据或tag；没有远程操作、commit或新tag。

恢复时已有38份暂存内容先做快照 `build/m20_300/v24_ff16/resume_20261104_index.json`，另按明确路径暂存52份FF16/原提案来源交付，索引共90份，38份旧blob全部未变。TASK_PROGRESS、M20索引和版本历史保留“旧暂存＋新工作文件”的可见差异，待后续审查合并；不得盲目commit整个索引。原提案/紧凑设计记录纳入新增文件审查组，仍标历史未验证。[本轮Git文件清单](../m20/ff16_resources/git_review.json)记录两组路径。无未跟踪的本轮源码；原始build/波形/数据包保持忽略。

## 下一次恢复入口

1. 读本文件、 `M20_V24_TEST_REPORT.md`、 `M20_V24_NONOVERLAP_VERIFICATION.md`，确认STOP门槛及实际失败。
2. `git status --short`、 `git diff`、 `git diff --cached --name-status`；核对旧38暂存保护，不能假设索引只含FF16。
3. 只读读取 `docs/m20/ff16_resources/small_verification.json` 及 `parameter_sources.json`、 `parameter_envelope.json`；检查原始small_r4配置/波形。不要重写原数据匹配SHA。
4. 下一项为P0时序边界评审。仅在修正/边界明确后，以新 `M20_FF16_OUTPUT_DIR`执行小型入口；原目录禁止复用。不能自动启动87场景、CPU/ISA/ROM修改、PCB或Git提交/tag。
5. 之后才按P1/P2条件继续。当前V24没有被正式接受，不在docs/reports新增阶段通过报告。
