boksop/swcell/docs/tasks/m20-v24-ffcd-20261104.md

# M20-V24-FFCD-20261104：20颗前馈完整系统数字联合

2026-11-04，**COMPLETED：数字开发交付完成，待用户审核定版**。分支main，HEAD5e601a9；V23 tag aecf570保持。范围仅RTL/仿真/工具/文档，不进入PCB、板级综合/实机或V3。

## 目标与已验证工作

用户本轮明确授权数字系统功能和实体可靠性分别验收。缺原厂min不再阻塞C/D，旧B门槛是历史结论；不删旧失败，不改CPU/ISA/ROM或20颗发生器。

- [x] 50MHz新服务从实际REF两级同步/边沿age导出，不用Johnson/V23内部计数。B寄存分频1MHz，C独立约0.9916MHz，共用同一个20-MUX模型；有效RUN下1REF=1微周期。
- [x] 新FPGA RUN/STOP/STEP：高age12释放/钳位，下一完整低窗口激活，写/ROM完成后停车，4tick guard。STEP ready/ack、STOP优先、RESET忽略STEP。
- [x] 从冻结V23派生的新存储绑定；477组合主体字节不变，33×2反馈MUX；独立审计总563，latch分支CPU原生FF=0；生成器临时重建全部文件字节一致。
- [x] dev_r3门禁：B/C各7内存＋7控制、各2最小场景9事件；服务单元6项PASS后才进入full_r1。
- [x] full_r1六配置A/B/C logic/timed，各49指令22223事件＋38游戏35108事件＝87/57331全部通过；另外5压力/12事件＋2smoke/9事件也通过。
- [x] 独立A运行冻结V23调度器/BRAM/CPU；B/C实际前馈；六配置全部PC/AR/A/Z/C/GPO/FSM/HALT/TRAP微状态、退役/事务/最终RAM一致。原87套件每配置166991微状态行，含额外项167066行。
- [x] B/C_timed各65536编码分类，50521实际TRAP及50521复位恢复；原2/5微周期保持。Pong/Snake原机器码冷启动及各64tick通过。
- [x] 内存7项×6配置、控制7项×B/C（各26显式单步）、服务6项PASS。RAM额外500ns与ROM额外300ns延迟负测分别触发原窗口断言。
- [x] 全量Python151项PASS（12.576s），不是146/5分开结果代替全回归。
- [x] 新目录重放旧56场景：32条件通过/24问题；79路径632次：131错误，316正向无错。保持问题配置FAILED，不借数字正常配置清除旧风险。
- [x] CSV/JSON/VCD提取图、原始SHA、系统本地tar与报告、源/输入和Git保护核对完成。

## 重要设计决定与限定

- 指定TAP16/链每级2ns，原独立33叶模型，ROOT29ns、LEAF22ns；clock DATA/SELECT路径不改。logic仅CPU数据延迟为0；timed数据组合DATA0.2/0.8、SELECT0.3/1ns，存储DATA0.1ns，均assumed。
- PREVIEW只是验证快照/参考FF取旧D，实际CPU只受真实H/S驱动；实际观察在Slave更新之后。写持久点在高WRITE事件，RESET之前取消pending、之后不回滚；不隐瞒与旧V23提交点的区别。
- 逻辑RAM读与CE/OE连续三状态期间的BRAM重复采样区分；逐项校验逻辑读、实际持久写、最终RAM，不将读重采样伪装成一次物理读。
- STEP只接受ready时上升沿，忙脉冲不排队；HALT/TRAP无CPU退役/RAM请求，不自动停止振荡或ROM刷新；STOP才是全服务停车。
- 实体链min/max、跨相Buffer/PCB、真实锁存边界/污染/hold、供电默认安全和FPGA亚稳态/实现STA均OPEN，不用于无限期阻塞数字开发，也不将数字PASS称实体签核。

## 实际测试与证据

|测试|命令/方法|结果|证据|
|---|---|---|---|
|RTL编译/elaboration、C门禁及六配置全回归|`M20_FFCD_OUTPUT_DIR=$PWD/build/m20_300/v24_ffcd/full_r1 bash sim/scripts/run_m20_ffcd.sh`（已执行，勿覆盖重跑）|PASS，exit0|full_r1.console.log；full_r1/verification.json；各profile/xsim日志|
|全量Python/旧负测重放/归档|`M20_FFCD_RESUME_FINISH=1`运行新system入口，指向full_r1（已完成，勿重复）|PASS，exit0|full_r1.finish.log、python_tests.log、readable_evidence/|
|旧56场景|旧small脚本，新`full_r1_ffcd_negative_small`输出|检测PASS；32 CONDITIONAL/24 FAILED配置|build/m20_300/v24_ff16/对应目录|
|79路径×8条件|旧review脚本，新`full_r1_ffcd_negative_cones`输出|检测PASS；131错误、316正向无错|同上，cone_verification.json|
|独立资源、重生成、全部原始SHA与冻结保护|临时目录重建、逐文件校验|PASS|docs/m20/ffcd_resources/final_checks.json|
|一键入口后加的独立baseline捕获/参数路径|shell/Python语法、实际快照与拒绝覆盖检查、代码核对|PASS（轻量检查）；未为此再次重复13分钟全回归|final_checks.json；交付源清单|
|综合/布局布线/STA/实物|未执行|NOT_RUN|实体事项另列NOT_VERIFIED|

主输出：`build/m20_300/v24_ffcd/full_r1/`；小型可读证据 `docs/m20/ffcd_resources/`。全系统原始索引8089文件、211505057字节；tar25187797字节，SHA256 `c1ceb0f32f305aa1ee567620f4d014799c8e27638c4d4bc70618bed2aa21c0f3`。系统tar不替代两套独立负测原始目录的备份。

本轮源147保护文件SHA保持；原V23保护206文件、正式报告和tag保持。原90暂存blob完全未动，本轮新增文件/文档保留工作区未暂存；无commit/tag/远程。

## 已定位开发失败（保留）

- dev_r1：测试驱动复位后未清STOP就等ready，握手超时。修正驱动；失败TB/日志原位保留。
- dev_r2：新4e9看门狗字面量32位溢出，t0触发；恢复原2e9合法界限。保留失败生成TB/日志，不改功能预期/断言。
- 最终文档核对时纠正bin和memh不同序列化的SHA标签；游戏字内容和冻结文件没有改动，填充4096字的仿真ROM另校验程序前缀一致。

## 下一步与恢复入口

1. 当前数字开发验收材料已完整交付；无未跑CPU功能项。先阅读[完整报告](../m20/M20_V24_FULL_SYSTEM_VERIFICATION.md)、[存储契约](../m20/M20_V24_MEMORY_ADAPTER_DESIGN.md)、[物理开放项](../m20/M20_V24_PHYSICAL_TIMING_OPEN_ISSUES.md)。
2. 等用户审核后再决定正式commit/tag或V3，不自动进入新阶段。正式docs/reports阶段报告应在用户确认通过后创建。
3. 若要复现：使用新的`M20_FFCD_OUTPUT_DIR=$PWD/build/m20_300/v24_ffcd/system_<new>`，执行`bash sim/scripts/run_m20_v24_system.sh`。不要复用full_r1；RESUME_FINISH仅用于未归档的中断收尾，不幂等重跑。
4. 未修改ISA/ROM/477主体/20发生器，保持V23及原A/B负测。禁止改期望、放宽断言或把原负测STOP历史分类重新变为本次数字门禁。
5. 原90暂存文件属此前工作；如用户批准提交，应单独审阅本轮清单，不执行git add全仓，也不重置用户索引。

## 2026-11-04 用户批准与后续本地定版

用户已批准有条件数字验收并授权本地commit/tag。[定版任务](m20-v24-release-20261104.md)为当前入口，[正式报告](../reports/m20_phaseV2.4_20261104.md)已创建。上文“等待审核/未提交/原90stage保持”是数字开发交付时的检查点，不再是当前Git状态；原90blob已单独归档提交86fdc9e，当前恢复补充不重写旧证据。
