boksop/swcell/docs/tasks/m20-v24-precheck-20261103.md

# M20-V24-PRECHECK-20261103

状态PLANNING（发现阻塞，按用户明确指令暂停，等待方案选择），2026-11-03。

## 目标与当前结论

先审V2.3与最终双模式时钟兼容性，条件满足后本地commit/tag，再开发纯157自主两相。用户特别要求发现理论缺陷/更优方案即提出并停止，不能先跑耗时验证。

已读附件、实际AGENTS/TASK、Git暂存48文件、V23适配器/调度器；隔离解压Johnson ZIP并检查源码，枚举16状态。发现V23服务CE依赖内部计数、外部相位CDC服务未定义；Johnson自身raw-clock DFF竞争风险未闭合，非法8状态独立环，17颗不含STOP/STEP/CDC。审查证据见[实施前审查](../m20/M20_V23_V24_PRE_IMPLEMENTATION_REVIEW_20261103.md)。

## Checklist

- [x] 检查main/c2edd9b、原48 staged文件SHA与manifest相符；无remote、原暂存未改。
- [x] ZIP只读校验并隔离解压`build/review/johnson8__2j78a1x/`；未覆盖正式源码。
- [x] 记录静态缺口、准确正常/非法环、候选改进及不确定项。
- [ ] 用户决定冻结范围与外部服务/发生器方案；补全截断附件。
- [ ] 后续才检查五款Buffer原厂电气/静态兼容性。
- [ ] 条件满足后才提交V23及annotated tag，不混入本轮审查文档。
- [ ] 方案通过评审后才实施V24并运行验证。

## 验证与边界

|项目|状态|证据|
|---|---|---|
|V23原暂存源码/文档SHA|PASS，只读检查|与delivery_manifest逐项git show :path比对，48文件；不能替代仿真|
|Johnson转移枚举|静态分析完成|build/review/johnson8__2j78a1x/static_review_evidence.json，两独立8状态环|
|新RTL/XSIM/长回归|NOT_RUN|用户要求先停|
|Buffer电气兼容|NOT_RUN|不据印象给规格|
|V23 commit/tag|NOT_RUN|架构审查未批准|
|硬件/远程|NOT_RUN|禁止范围|

## 恢复入口

先读实施前审查。原48文件索引仍是V23快照；根TASK工作树更新用于新任务，因此显示MM属预期，不重置索引。本轮审查/任务文档尚未暂存，避免混入V23。原V23 delivery_manifest的TASK哈希对应**索引中的旧TASK**，不是新增审查任务工作树；不要修改历史manifest追平。无新RTL，无待验证功能修改。等待用户选择后再继续，不能自动跑run_m20_v23.sh或任何V24长回归。

## 后续决定（2026-11-03）

用户已批准仅模式A冻结V23，并按同源参考优先方案继续V24架构/实施。V23原48文件提交aecf570，annotated tag m20-v2.3-two-phase-sim-verified，未混本文件。最新用户明确要求已覆盖附件截断处，不再以旧截断阻塞。当前活动任务转至[m20-v24-implementation-20261103.md](m20-v24-implementation-20261103.md)。本前置审查已完成；原静态发现保留历史，不回写V23 PASS。五种Buffer实物电气验证未执行，仍属后续物理工作。
