boksop/swcell/docs/tasks/m20-v23-two-phase-20261103.md

# M20-V23-TWO-PHASE-20261103

状态 **COMPLETED**，2026-11-03；工程任务完成，等待用户确认正式阶段验收。main基线c2edd9ba5baff58c86ef471b4435275e3f1bc876。没有本轮新commit。

## 目标和边界

原477组合节点/ISA/33状态/2-5周期不改；独立IDEAL_FF或真实双MUX反馈状态绑定，注册四阶段相位/双死区/停钟单步、同步FPGA存储服务、完整四RTL+Python对照及数字压力负测。不选器件、不做PCB/外设/bitstream/远程，不将模型当实体Hold签核。

## 已修改、已验证

- [x] 原284个跟踪文件建立SHA检查点；旧V1/V2/V21/ISA/游戏/历史证据不变。仅更新.gitignore、README、M20索引和TASK进度等管理文档。
- [x] 独立V23生成器与审计：477逐pin相同，33原D/Q/QM，66反馈MUX；543完整/542纯功能；临时目录重生成字节一致；拒绝额外原生FF/逻辑/伪造计数。
- [x] 四阶段注册调度、不对称死区、四阶段发起停钟及5次单步；真实CPU12单步及停钟33位冻结。
- [x] FPGA同步ROM/RAM RTL与sim延迟包装分离；地址快照/保持/单写、已知且新鲜响应/稳定窗口断言，IO模型及真实初始化。
- [x] 零/带延迟各49+38/57331事件，四RTL与Python及256项独立最终RAM一致；连续64tick不使用非零初态夹具。
- [x] 50521非法实际TRAP保持与复位恢复；零/带延迟分别7memory/reset。
- [x] 5短路径×6配置（含A3→C的历史SUBI3001），缩死区/偏斜/晚关/早开/min-max传播；实际穿透和fatal、ROM/RAM窗口负测。
- [x] 原V21原入口独立复跑PASS；全部123 Python测试PASS。
- [x] 4文档/接口契约、实际CSV与关键波形、原始证据SHA索引、自动入口、本地Git审阅文件。

无已落盘未验证RTL/测试修改；完整构建缓存和大量CSV未纳管，不删除原位置。小型证据docs/m20/v23_resources，原始2802项64,531,391字节文件在r6，逐项SHA索引。

## 设计决策

- CPU无额外状态，不用原生FF冒充锁存器；每bit两颗显式MUX反馈。监视器/FPGA服务不计入核心。
- commit_ce在M关闭边沿供同步适配器单写及参考观察，真正CPU可见状态在S打开后更新；观察延后，禁止瞬间比较。
- 同步BRAM地址先锁存、2系统边沿返回并保持。无IR保持指令直到提交；ROM只在Master关闭期更新。未增加等待状态，2/5仍原契约。
- 同步CPU复位依靠两个完整主从序列再RESET入口；RAM不清零，pending写可取消，完成写不回滚。
- 非零夹具只停钟驱动D/透明阶段捕获，禁止强制Q释放；冷启动/64tick无后门。
- 延迟参数为探索，不是物理标定；不选择新Buffer/器件，不开展PCB设计。

## 测试与证据

|测试|命令/方法|结果|证据|
|---|---|---|---|
|原V21回归|M20V21_OUTPUT_DIR=build/m20_300/v23/v21_baseline_20261103 sim/scripts/run_m20_v21.sh|PASS|v21_baseline_20261103/verification.json|
|V23 compile/elaboration|run_m20_v23.sh内xvlog/xelab|PASS|r6各profile/xsim/compile.log与elaborate日志|
|完整V23仿真|M20V23_OUTPUT_DIR=$PWD/build/m20_300/v23/regression_r6 sim/scripts/run_m20_v23.sh|PASS|r6/verification.json；零/延迟87/57331、50521全非法、2×7memory及6压力配置|
|实际穿透/fatal/错误内存窗口|脚本内负测，指定fatal标记并验证穿透Q错误|PASS|r6/zero/xsim/penetration.csv、bad_ram.log、bad_rom.log、negative/xsim/overlap.log|
|Python全测试|PYTHONPATH=host/python build/venvs/python312/bin/python -B -m unittest discover -s host/python/tests -q|PASS 123|session_20261103/python_tests_delivery.log|
|重生成/结构计数|v23_verify prepare与v23_audit|PASS|r6/resource_audit.json|
|综合|未运行|NOT_RUN|本轮纯仿真|
|布局布线/STA|未运行|NOT_RUN|无板级工程|
|实体157/FPGA实物|未运行|NOT_RUN|不能宣称物理Hold或Fmax通过|

r6验证JSON SHA：38b3de525918fcbd0689150f349e5e71f6bc01d0997b8956696d83cc7630adaa。各源及原输入结束哈希均与开始一致。r6本轮最终版本；r4/r5曾通过但不能证明其后增加的RTL。

## 已知问题/风险与失败保留

实体亚稳态、实际污染/传播、FPGA IO往返、PCB及缓冲skew未签核。RAM2ns观察阈值不是器件setup；下阶段应按接口契约实测标定。当前安全启动由联合平台任务发起，后续板级控制必须实现同一序列。

dev_r1 elaboration失败为漏连scheduler reset；dev_r2为强制Q夹具释放X。已修复并重跑。r4中A3→C压力使用ADCI2001不能证明目标活动，r5/r6改为V2.2见证SUBI3001。全部开发证据保留。预期相位重叠及ROM/RAM窗口fatal是检测验收，不混入正向失败。

## 下一次恢复

1. 阅读根TASK及4份V23文档，检查Git与source_sha256/delivery_manifest；本任务已完成，无需重复实现。
2. 要复跑用**新目录**：`M20V23_OUTPUT_DIR="$PWD/build/m20_300/v23/新名称" sim/scripts/run_m20_v23.sh`。压力入口run_m20_v23_stress.sh执行同一完整保护回归。
3. 已有r6不得覆盖。旧V1/V21、机器码/期望、旧tag不可改。没有远程；本轮只暂存，不自动新commit。
4. 用户确认正式阶段通过后按AGENTS模板另建docs/reports正式报告；当前测试报告不冒充用户验收。
5. 后续PCB/选型/硬件任务需用户新指令，本轮到此停止。
