boksop/swcell/docs/m20/M20_300_CANDIDATE_COMPARISON_20261102.md

# M20-300：545颗候选与603颗V2的结构对比评审

日期：2026-11-02（Asia/Shanghai）。这是候选分析与隔离验证记录，不是正式采用或阶段验收。未覆盖V1/V2、冻结ISA、游戏、既有测试期望或历史数据；未执行Git暂存/提交/推送。

## 1. 结论

候选的 **479个显式组合MUX＋33bit×2存储折算＝545颗** 可以从实际Verilog和连接JSON独立核实，计数边界与V2的603颗基本一致，没有把译码/ALU转移到FPGA外围。其译码和AR网络优于当前V2，原包最大MUX拓扑深度30，V2为50。

但原包不完全等价：**非法指令在EXEC被识别后进入HALT(6)，而不是TRAP(7)**。原包Python测试通过、Pong/Snake测试通过，均不能覆盖这个缺陷。本次使用原样候选RTL的最小XSIM测试，以及接入既有V1锁步的指令/内存测试，分别复现失败。

在build隔离副本中，仅删除状态低位方程的一项多余条件，得到 **477＋66＝543颗**，最大拓扑深度29；实际通过既有49指令＋38游戏、57331事件的V1/候选/Python三方比较及7组memory/reset测试。该版本可作为后续优化候选，但本轮没有并入正式RTL，也没有改变603颗基线的历史结论。

## 2. 比较对象与来源

|对象|来源/标识|状态|
|---|---|---|
|V2 shared|`rtl/m20/v2/generated/shared/`；[既有报告](M20_300_V2_TEST_REPORT.md)|603颗，已有完整指定回归|
|原候选|`docs/m20/swcell_m20_structural_candidate.zip`|545颗；本轮发现非法转态缺陷|
|修正实验|`build/m20_300/candidate_review_20261102/corrected_remove_guard/`|543颗；仅临时副本，指定回归通过|

原ZIP SHA256：`a3f3aff6199eab779e63df997508e31c41fde5aa7d180acb347e9daca9feef0c`。

原候选RTL SHA256：`85ab7b67584e99441471d7ce9a299468070a52b83f32890839632093381081a4`。

543实验RTL SHA256：`33c806bdc0880a6ef03baaec288f782b235074e5b47cf3c22266adf9164d1f52`。

原包23个文件全部保留原字节；仿真在其build子目录及独立评审目录运行。源/索引保护清单在评审目录的`protected_before.json`，最终核对见`review_receipt.json`。

## 3. 同口径数量及结构深度

|指标|V2 shared|原候选|修正实验|
|---|---:|---:|---:|
|显式组合MUX|537|479|477|
|功能状态bit|33|33|33|
|DFF折算，2颗/bit|66|66|66|
|总等价数量|603|545|543|
|其中显式复位选择，已含组合列|33|33|33|
|最大MUX拓扑层数|50|30|29|
|最大内部pin负载，含主输入|34，rst|34，rst|34，rst|
|MUX输出最大内部pin负载|21|21|21|
|普通/RAM指令周期|2/5|合法路径2/5；非法终态错误|2/5|

原候选相对603减少58颗（9.62%）；修正实验减少60颗（9.95%）。33位均为PC12、AR8、A4、Z/C2、GPO4、微状态3，没有增添IR、B、T或FPGA算术器。

候选中1个MUX只用于`trap_event`观察输出，未进入状态D或物理总线的功能锥。因此严格只算CPU功能根时，原候选为478＋66＝544、修正实验为476＋66＝542。本报告主数字保留候选完整交付端口的545/543，不混淆“修复”与“删除调试门”的收益。V2的537个均可从功能根到达。

两者都采用MUX常量/接线以及有成本的反相，均已含保持和复位选择。ROM/RAM容量、OLED、按键同步/消抖、外部存储器适配、驱动缓冲、电气时钟与PCB均不包含在这个核心数中。两MUX/bit仍是存储折算，不代表已经实现真实主从反馈时序。

## 4. 节省来自哪里

候选分组与V2不同。下表将候选storage组里的3个状态复位MUX归入控制；其余A/Z/C/GPO保持复位与输入/结果/标志逻辑合并比较。共享实例仍按其首次归属一次，表内差额不等同于逐门一一替换的因果分解。

|组合逻辑归属|V2|原候选|修正实验|修正实验−V2|
|---|---:|---:|---:|---:|
|译码|169|132|132|-37|
|AR更新|79|51|51|-28|
|PC更新|74|73|73|-1|
|微控制，含state复位|47|52|50|+3|
|RAM地址/控制|17|17|17|0|
|输入、ALU、结果/标志及A/Z/C/GPO更新|151|154|154|+3|
|**组合合计**|**537**|**479**|**477**|**−60**|

**译码：集中合法性判断，内部按类别控制。** V2先构造带保留位校验的各操作命中，再组合出legal和后续控制。候选将严格legal检查与内部操作分类分开：全局legal门控提交和访存，内部用major/sub的局部位直接选择。二者可以具有同样非法副作用保护，但候选少了重复校验/选择项。候选还用分层相等比较及AND/OR交换输入规范化，增加公共子表达式共享机会。不能把legal检查本身取消或将非法编码当don't-care。

**AR：按更新动作和nibble设计选择。** V2对ARL/ARH/MOVARL/MOVARH/INCAR逐项做8位选择，然后加寄存器写使能/保持。候选先以指令bit9选择立即数或A，共享4位来源；按低/高nibble分别使能加载，递增与保持直接进入每位更新路径。避免了部分重复“选回自己/再保持”的网络，因此AR少28颗。该方法不改变AR宽度、寻址或周期。

**数据通路并非全部更省。** 候选把AR/按键来源选择移到结果侧，并按指令原始位分层选择逻辑/移位结果；V2采用通用ALU构造及输入侧选择。合并同类后候选这一大组反而多3颗。因此不能用候选“alu55”直接对比V2完整“ALU107”，宣称ALU减半：两者归属边界不同。

**更浅的译码/合法性路径。** 候选按指令家族分层组织legal；V2较长的命中项OR链参与控制路径。相同单位延迟拓扑分析为50→30（修正后29），说明逻辑级数有优势。它不是真实关键路径的ns值，未证明所有路径可敏化，也不能推导Fmax比例。最大负载相同不代表每个节点的负载分布相同。

## 5. 原包功能缺陷及修正实验

原`tools/build.py`中状态低位的一项为：

```python
N.AND(S_exec, N.N(ram_exec), N.N(halt_instr), N.N(trap))
```

在EXEC执行FFFF时：`trap=1`，`ram_exec=0`，`halt_instr=0`。这项被最后的`!trap`清零；低位OR中又没有加入当前`trap`。状态高两位却均包含`trap`，最终产生`110`，进入HALT。注释写“illegal=111”与实际网络不符。

原样RTL的最小XSIM输出：

```text
ILLEGAL_BEFORE state=2 trap_event=1 retire_valid=0
ILLEGAL_AFTER state=6 expected_TRAP=7
Fatal: ILLEGAL_TRANSITION_FAIL got=6 expected_TRAP=7
```

这不是端口适配引入的差异：该最小测试直接编译ZIP中的原样`m20_300_mux.v`，没有使用适配器。

隔离修正为：

```python
N.AND(S_exec, N.N(ram_exec), N.N(halt_instr))
```

非法EXEC便会令低位为1，同时保持HALT、合法普通和RAM路径的原行为。相较原包删掉两颗live MUX，得到543。另评估“在低位OR末端显式加trap”的直接修复为546、深度31；该546副本仅完成结构计数，没有跑完整HDL回归，不作为已验证替代版。

候选原`test_isa.py`虽检查全部65536编码的legal，却在非法定向测试中只检查`trap_event`、`retire_valid`和PC，没有断言`u_next=TRAP`。游戏程序没有执行非法编码，因此也掩盖了缺陷。它说明“合法编码统计正确/游戏可运行”和“异常状态契约正确”需要分别验证。

## 6. 本次实际验证

环境：Ubuntu24.04，Python3.12，XSIM2026.1.1；所有新输出在`build/m20_300/candidate_review_20261102/`。没有综合、布局布线、STA或实物测试。

|测试|原候选545|修正实验543|证据，相对评审目录|
|---|---|---|---|
|MUX逐pin、SV/JSON、33FF-D/复位检查|PASS|PASS|`variant_audits.json`、`audit_variants.py`|
|原包Python legal穷举65536、数据/标志27648向量及控制定向|PASS|NOT_RUN（未对修正副本重复此入口）|`package_python.log`|
|原包Python两游戏最大场景及冷启动|PASS|NOT_RUN（已有下列更完整HDL回归）|`package_python.log`|
|原包HDL smoke，Pong2500退役|PASS|NOT_RUN|`smoke_pong.console.log`|
|原样RTL非法FFFF最小HDL|**FAIL，HALT代替TRAP**|NOT_RUN（修正由完整差分覆盖）|`minimal/original.log`|
|V1锁步＋Python，49指令场景|**FAIL，第15个场景触发非法终态差异**|**PASS，49case/22223事件**|两版各自`full_regression/xsim/instructions.log`、修正版`instructions/three_way_comparison.json`|
|V1锁步＋Python，38游戏场景|**PASS，35108事件**|**PASS，35108事件**|两版各自`games/three_way_comparison.json`|
|7组内存/复位|**FAIL，TRAP测试处终态差异**|**PASS，7组**|两版各自`full_regression/xsim/memory.log`|
|所有完成场景最终256nibble RAM与读写事务|游戏38组PASS|全部87组PASS|各case真实CSV/最终RAM及Python期望|
|33状态、2/5周期、连续64tick、RAM异步/同步适配|游戏覆盖PASS，指令全套未完成|PASS，包含既有指定覆盖|修正`full_regression.console.log`|
|隔离重生成SV/连接JSON|逐字节相同|生成及逐pin审计PASS|`regeneration.json`；候选报告JSON仅键顺序不同，解析后相同|
|源文件/ZIP/Git索引保全|PASS|PASS|`review_receipt.json`|
|综合/实现/STA/真实157电路|NOT_RUN|NOT_RUN|范围外|

三方测试使用未修改的V1 RTL和Python参考期望。为复用原TB，在build中只做候选端口/寄存器重命名，额外观察候选实际FF-D形成退役投影；未引用V1结果生成候选输出，所有479/477颗MUX保持对应接线。原TB也在每周期比较实际状态与总线，检查所有最终RAM。适配器观察逻辑不进入预算，也没有反馈至CPU。

临时适配器最初因`trap_event`声明位置编译失败，已将声明前移；日志保存在`adapter_attempt1_compile.log`，属于本轮测试接线问题，不算原候选缺陷。真实非法终态失败另有原样RTL最小复现。

原候选ROM二进制与既有游戏一致：Pong168字，SHA `e1029928d763ab5b0d21fe347687f52b326f545e9072f4c04365597439eead8c`；Snake368字，SHA `466cb149c8e5d6914d0b78dc8a3ec5074c77020edf880cedbd520b41b3376b98`。没有重新编译或更换游戏来取得通过。

## 7. 优劣与建议

|方面|候选方案|现有603方案|
|---|---|---|
|面积|译码/AR明显更少；修正后543|多60颗；是已审计基线，不是最小实现|
|拓扑深度|原30，修正29，明显较浅|50；控制译码OR链值得改进|
|功能正确性|原包有非法转态缺陷；修正实验通过既有完整指定回归|已通过原指定回归，异常/复位行为已有证据|
|结构复用|单个紧凑生成脚本易做局部优化，但单元边界和公共构造测试较少|通用MUX构造/ALU/译码、独立单元穷举和CPU回归分开|
|资源审计|包内audit主要数实例并硬编码33bit，未验证SV/JSON每pin或功能锥；本轮已补独立审计|已有独立审计、负向测试、来源/共享记录及可再生CSV|
|接口整合|CPU存储接口可对应；调试/退役端口与原工程不同，需要适配|直接匹配现有工具链与退役契约|
|物理可信度|真实反馈DFF、缓冲、STA均未完成|同样未完成；不能认为603版已有物理优势|

推荐保留603版作为冻结对照，将候选的局部译码和AR更新方式作为下一版优化基础。若采用候选，应带上非法转态修正，增加覆盖全部非法编码终态的专门测试，接入原有独立审计和完整回归，再形成正式候选版本。不要直接以原ZIP替换现有RTL。

本次已经表明：**603不是同ISA/同周期条件下的最小数量；面积约543颗的结构具有真实回归证据。** 但这仍不是全状态形式等价证明，也没有达到300颗。543距离300还差243颗，不对后续优化收益预作承诺。
