boksop/swcell/docs/m20/M20_300_V2_MUX_BUDGET.md

# M20-300 V2：精确MUX资源审计

> 此文件由 `python -m m20.v2_audit` 从实际结构SV/JSON重新生成；不是Vivado LUT估算。日期：2026-10-29。

## 1. 结论与口径

朴素结构版为 **672 组合MUX + 66 DFF等价 = 738颗**；全局共享版为 **537 + 66 = 603颗**。这是本次具体网表、普通DFF按2颗157/bit的核心逻辑等价数，包含显式CE/保持和复位选择，不是已完成物理PCB的全部BOM。

共享优化减少135颗组合MUX，未增加状态（仍33位）或改变2/5微周期。当前共享版相对328超出275颗，相对300超出303颗。

唯一原语为swc_mux157，每个显式实例一颗；接线/常量tie不计，NOT必须MUX。表中CE和reset是组合列的子集，DFF等价另加；共享MUX已计在唯一归属组，不重复相加。standalone ALU/decoder是单元测试副本，不再加进CPU top。

## 2. 两版逐组统计

|版/语义组|组合MUX|CE保持子集|复位子集|其它组合|状态bit|DFF等价|物理157等价|有CSE复用的归属MUX|
|---|---:|---:|---:|---:|---:|---:|---:|---:|
|baseline/decoder|264|0|0|264|0|0|264|0|
|baseline/control|60|0|3|57|3|6|66|0|
|baseline/input_select|20|0|0|20|0|0|20|0|
|baseline/alu.decode|11|0|0|11|0|0|11|0|
|baseline/alu.arithmetic|29|0|0|29|0|0|29|0|
|baseline/alu.logic|20|0|0|20|0|0|20|0|
|baseline/alu.result|32|0|0|32|0|0|32|0|
|baseline/alu.flags|42|0|0|42|0|0|42|0|
|baseline/writeback_a|9|4|4|1|4|8|17|0|
|baseline/flags|6|2|2|2|2|4|10|0|
|baseline/pc|74|12|12|50|12|24|98|0|
|baseline/ar|79|8|8|63|8|16|95|0|
|baseline/gpo|9|4|4|1|4|8|17|0|
|baseline/bus|17|0|0|17|0|0|17|0|
|**baseline合计**|**672**|**30**|**33**|**609**|**33**|**66**|**738**|**0**|
|shared/decoder|169|0|0|169|0|0|169|46|
|shared/control|47|0|3|44|3|6|53|7|
|shared/input_select|20|0|0|20|0|0|20|0|
|shared/alu.decode|11|0|0|11|0|0|11|4|
|shared/alu.arithmetic|29|0|0|29|0|0|29|4|
|shared/alu.logic|16|0|0|16|0|0|16|0|
|shared/alu.result|32|0|0|32|0|0|32|0|
|shared/alu.flags|19|0|0|19|0|0|19|0|
|shared/writeback_a|9|4|4|1|4|8|17|0|
|shared/flags|6|2|2|2|2|4|10|0|
|shared/pc|74|12|12|50|12|24|98|0|
|shared/ar|79|8|8|63|8|16|95|0|
|shared/gpo|9|4|4|1|4|8|17|0|
|shared/bus|17|0|0|17|0|0|17|0|
|**shared合计**|**537**|**30**|**33**|**474**|**33**|**66**|**603**|**61**|

## 3. 与原328预算按一致口径比较

为避免复位双算，本表先从各组移除reset子集，再集中到复位行；控制器与译码合并比较原70，并加原uSTATE存储6。原预算没有真实网表，归属只能按这一公开映射比较，不能声称找到了原估算中的逐门差异。

|对应模块|原预算|共享版精确数|差额|
|---|---:|---:|---:|
|PC12|82|86|+4|
|AR8|62|87|+25|
|A4写回|20|13|-7|
|Z/C|6|8|+2|
|GPO4|12|13|+1|
|控制/译码+uSTATE存储|76|219|+143|
|ALU|40|107|+67|
|RAM地址/控制|8|17|+9|
|输入选择|10|20|+10|
|集中复位选择|12|33|+21|

## 4. 优化与拓扑代价

|指标|baseline|shared|
|---|---:|---:|
|组合MUX拓扑最大层数|50|50|
|核心状态bit|33|33|
|内部信号最大输入pin负载数（不含常量/调试）|34|34|
|有跨语义组CSE复用的唯一MUX|0|19|

O1只合并完全相同(S,I0,I1)节点，包含重复NOT；两版采用同一逻辑构造/常量简化。拓扑层数不是ns，也未证明所有路径都可被敏化；扇出是内部pin负载代理，不能替代PCB驱动/缓冲/物理时序分析。最大路径节点清单在audit.json中。

## 5. 300颗目标与外围边界

当前共享版必须再减少303颗才达到300；这不是已证明不可达的理论下界，也没有证据可保证仅靠继续CSE达到。当前固定存储66、显式保持30和复位33合计129，余下171的目标额度需容纳其它组合；现有其它组合474。应另评审局部译码/控制因式分解和数据路径选择，再做每项等价验证。

PC/AR共用增量器、改微状态/复位策略可能引入选择MUX、扇出或周期代价；本轮没有实施，不能填入假节省。保持冻结ISA和本轮2/5验收配置，不为压数字隐藏状态/运算器。

六键两级同步12bit按storage至少24颗、复位同步2bit至少4颗另列；其CE/复位/输入整形及真实时钟缓冲仍需各自电路审计。RAM/ROM容量为0颗157但物理器件另列；SRAM方向/三态驱动、PCB负载、供电去耦不包含于核心逻辑数。

当前仅组合网络已逐MUX构造。nativeFF可继续用于FPGA原型；2-MUX/DFF是用户指定折算，尚未实现/验证真实反馈DFF时序。没有三态157原语或免费反相；电气辅助不能由本表凭空省掉。

## 6. 独立审计与复现

审计器不导入生成器/其stats：逐个解析SV的MUX实例和S/I0/I1/Y，核对JSON、端口/输出接线、无条件FF-D、33位边界、显式hold/reset和功能根可达性；拒绝其它单元/行为组合/组合环。共享请求也核对同一live节点/相同pins。

```bash
PYTHONDONTWRITEBYTECODE=1 PYTHONPATH=host/python \
build/venvs/python312/bin/python -B -m m20.v2_audit \
  --output docs/m20/v2_resources \
  --markdown docs/m20/M20_300_V2_MUX_BUDGET.md
```

逐组module_budget.csv、逐实例gate_instances.csv及audit.json同时生成；SHA关联实际SV和连接清单。独立单元副本统计在audit.json的standalone_units，不与top相加。功能三方验证和已知边界另见M20_300_V2_VERIFICATION.md及M20_300_V2_TEST_REPORT.md。
