boksop/swcell/docs/m20/M20_PHYSICAL_FEASIBILITY.md

# M20：真实157 CPU物理可实现性评估

2026-11-02。V2.1结构与指定数字回归 **VERIFIED**；V2.2物理规格/可配置分析已交付，物理数值为 **ESTIMATED**；完整CPU PCB投板放行 **TBD**。接受500+核心规模，不再为了300重复推翻架构。

## 结论

正式版完整验证口径477组合+66存储=543，纯CPU476+66=542；原V1/603保留。ISA/33状态/2-5profile保持，本轮重新执行50521非法终态/恢复和87场景57331事件通过。详见[V2.1结果](M20_300_V2_1_TEST_REPORT.md)。

可以继续围绕此结构进行时钟、供电、接口和小样实测；**尚不能保证任一实物主频或直接放行整板**。关键风险是主从交接、短路径与分布时钟，远不止最长组合逻辑。

## 关键物理发现

- 最长拓扑ROM→state 29层，FF→FF最多16；Top50没有被证明为真实可敏化最差路径。纯门数乘2–4ns只是粗算，不是CPU Fmax。
- 最短跨寄存器2层A→GPO未在同边沿发射；实际游戏轨迹找到79对最短路径同边沿活动见证，最短4层，包括PC0→PC1、AR0→AR1、A→C。需做真实hold/skew测量。
- clock负载为66个S；LVC典型输入电容合计165pF未含布线。建议评估非重叠两相、分支缓冲，辅助器件另计。
- 同步复位MUX能在数字模型中复位，但真实反馈DFF必须靠确定相位序列初始化；不能依赖FPGA GSR。
- FPGA ROM/RAM由固定相位适配器服务，不能省掉存储服务和IO往返时间。现有2/5周期通过模型验证，板级约束仍待闭合。

## 频率与游戏预算

[频率CSV](physical_resources/frequency_scenarios.csv)默认LVC85℃/50pF测试延迟，最长图149.35ns，再加假定FPGA服务160ns和CQ/setup/skew/PCB/裕量55ns，总场景364.35ns。全部值可在config/m20/157_timing_models.json修改。此是跨器件保守示例，不是测得的CPU临界周期；高负载和DFF hold缺口使所有点最终资格仍TBD。

|候选CPU频率|示例setup预算|Pong定向最长观察tick|Snake食物搜索最长观察tick|
|---|---|---:|---:|
|100kHz|正余量，实物未定|3.08ms|134.19ms|
|500kHz|正余量，实物未定|0.616ms|26.838ms|
|1MHz|正余量，实物未定|0.308ms|13.419ms|
|2MHz|正余量，实物未定|0.154ms|6.710ms|
|5MHz|该场景负余量|0.0616ms|2.684ms|
|10MHz|该场景负余量|0.0308ms|1.342ms|

游戏表来自本轮CPU实执行周期Pong308、Snake13419；未加主循环/调度/渲染开销，不是所有游戏输入最坏上界。100kHz下Snake该搜索tick约7.45次/秒，10Hz预算可能不足；500kHz逻辑余量更大。OLED刷新/输入由FPGA独立运行，但游戏状态仍由CPU指令计算。

建议物理启动100kHz并用充足死区，P1/P3闭合后研究500kHz–1MHz。减慢周期不能解决hold或时钟重叠。M11单DFF100MHz不作为M20主频依据。5/10MHz场景负余量也不等于已实测DUT失效。

## PCB可操作规格和待放行项

初步研究4–6层、160×180mm级CPU板，按PC/AR/ALU/译码/状态分区；每位Master/Slave紧邻，clock/reset分支，543个本地去耦起点。不是正式外形/封装/引脚。完整规格导航：

|文档|内容|
|---|---|
|[器件时序模型](M20_157_TIMING_MODEL.md)|三份原厂参数、模型局限和DFF简化仿真|
|[关键/最短路径](M20_157_CRITICAL_PATHS.md)|Top50、79个同边沿活动、setup/hold形式|
|[时钟复位](M20_157_CLOCK_RESET.md)|66负载、两相死区、缓冲与真实上电序列|
|[扇出功耗](M20_157_FANOUT_POWER.md)|逐网估算、3个超测试负载节点、去耦/功耗口径|
|[PCB初步规划](M20_157_PCB_PREPLAN.md)|面积、层叠、分区、辅助BOM、放行门槛|
|[FPGA接口](M20_FPGA_INTERFACE.md)|59/60基础IO、BRAM/写事务适配与联合仿真|
|[硬件验证计划](M20_HARDWARE_VALIDATION_PLAN.md)|P0–P4及每步实测验收条件|

未确定项：最终厂商/批次及缓冲器、真实DFF污染延迟/setup/hold/脉宽、两相skew/死区、PCB几何/寄生、FPGA HR引脚/IO时序/读延迟、供电时序/功耗/SI。模型不提供可信最高主频，待小样校正。没有伪造SPICE、FPGA综合STA或实物结果。
