boksop/swcell/docs/m20/M20_V21_GIT_PLAN.md

# M20 V2.1首次Git纳管提案

2026-11-02。main仍无首个commit，原四份Markdown staged保持；本轮不add/commit/push或切换分支。

在原201文件提案基础上，新增正式v21原语/生成SV/连接JSON、生成器/审计/验证、物理参数和分析器、独立测试、仿真模型与回归脚本、FPGA外设适配器、12份设计/物理文档、少量可重生成CSV/JSON、任务记录及索引。完整当前文件列表/大小/SHA见`M20_V21_GIT_FILES.csv`；它是待确认清单，不是已提交状态。

排除build/、虚拟环境、Vivado/xsim缓存、WDB/VCD/FST、原始采集results、硬件诊断镜像、个人提示词、.git内部。旧Git清单是历史快照，不覆盖。本CSV自身不填SHA，最终receipt另行绑定。现有.gitignore保持原样。

原候选ZIP和docs/m20.zip保留工程原位并建议外部归档，不自动加入首次提交；正式生成器/网表已独立保存，ZIP不再是唯一源码。对需审阅的结构生成SV/JSON及精简参数/结果CSV纳管，有助复核真实器件数；不能以归档ZIP替代可读源码。

证据独立归档建议：备份P1/P2/P2B原始UART/CSV/图表、routed报告/bitstream关联，V1/V2原始差分/波形、候选原包SHA和真实失败日志，以及本轮v21/regression_r3输入/期望/真实CSV/最终RAM/源码快照、异常/物理模型日志及receipt。用独立介质保留SHA256清单并验证恢复；Git保存可再生源码与小报告，不能替代历史实测数据。未自动执行复制/同步/外部备份。

建议用户确认后按独立单元提交：既有基线；V2.1正式化及异常回归；V2.2模型/物理规格。提交前重新核对工作区和清单，修改过的文件须重新计算SHA。当前尚未授权commit，本文不执行提交。
