boksop/swcell/docs/tasks/env-prep-20261028.md

# SWC-ENV-PY312-20261028：新机环境与首次Git纳管准备

- 状态：COMPLETED（环境与审核材料已准备；首次Git提交仍待用户确认）。日期2026-10-28，Asia/Shanghai。
- 当前分支main，无首个commit；索引保留原四项。本轮不新增暂存、不commit/push、不切分支。
- 范围：保留旧.venv；新Python3.12；现有依赖、52项测试、独立P2B重分析/图表；纳管与备份方案。
- 边界：没有修改RTL/XDC/Tcl/既有Python程序或单元测试/已有测试数据；未进行Vivado适配或实物测试。

## 已完成（修改/验证均已完成）

- [x] 新环境`build/venvs/python312`，Python3.12.3；原`.venv`不变，现有build忽略规则覆盖新环境。
- [x] 系统无ensurepip/pip，先--without-pip，再按官方PyPI元数据SHA引导pip26.2.2，仅安装到新环境。
- [x] 根据原requirements-analysis.txt（含requirements.txt）安装依赖，pip check PASS；原依赖声明未修改。
- [x] 全部52项Python单元测试PASS，无跳过，包括伪终端串口；未修改测试以绕过错误。
- [x] 独立新目录重新生成P2B全部统计和三张PNG；96/12行CSV、summary/report与历史版字节一致。
- [x] 新增已验证版本快照、环境说明、Git纳管/排除/备份方案及拟议忽略规则；根.gitignore未改。
- [x] 完整首次提交逐文件清单与审核SHA manifest；逐文件排除清单，全部不暂存。
- [x] 原4806个旧环境/源码/原始结果节点指纹校验PASS；Git index字节未变。

已修改但未验证的功能内容：无。需要用户确认的是纳管方案/忽略规则及以后的首次commit，不是环境测试。

## 实际参数与决策

- 新env位于build中以复用现有忽略规则；不替换旧venv、不装系统包。build可再生，清理它会移除新env，重建依据为版本快照。
- 原requirements仍作为兼容范围声明；新增`host/python/requirements-py312-ubuntu24.lock.txt`记录此次实际13项依赖，不号称跨平台严格hash lock。
- 关键版本：pyserial3.5、numpy2.5.4、matplotlib3.11.2。pip26.2.2独立记录。
- P2B只对新副本运行--analyze；已有results不写。新版PNG可因渲染版本不同而改变字节，CSV/JSON必须一致。
- Git只提出可审核清单；`.gitignore`不自动合并补充规则，不git add/commit/push。查询禁用diff.autoRefreshIndex避免前次审计的缓存副作用。

## 测试与证据

|验证|命令/方法|结果|日志/证据|
|---|---|---|---|
|依赖|新env python -m pip check|PASS|build/env_setup_20261028/pip_check.log|
|Python全套|新env python -B -m unittest discover -s host/python/tests -v|PASS，52项，无skip|python_tests.log，同目录|
|P2B数据重生成|新env swcell_phase2b.py --analyze build/env_setup_20261028/p2b_reanalysis|PASS|p2b_reanalysis.log、reanalysis_validation.json|
|PNG有效性|Pillow verify+尺寸/大小检查|PASS，3图|reanalysis_validation.json|
|保护校验|4806节点SHA/链接目标，对比原基线|PASS|protected_before.json、protected_validation.json|
|Git index|原始SHA比对|PASS，未改变|index_before.sha256|
|Git纳管候选|逐文件清单/现有忽略规则/文件存在性|PASS|git_first_commit_manifest.csv及git_plan_validation.json|
|RTL/XSIM/Vivado/硬件|本轮不执行|NOT_RUN|不能把Python通过称为新工具RTL通过|

日志均在build/env_setup_20261028/。详细使用方法见[环境说明](../environment_python312.md)；纳管与备份见[Git方案](../git_tracking_plan.md)。

## 下一步与恢复入口

1. 直接使用`build/venvs/python312/bin/python`；旧`.venv`不要修改。
2. 评审`docs/git_first_commit_files.txt`及`docs/gitignore.proposed`；用户确认范围后再另行暂存/首次commit，push需要单独授权。
3. 本轮无需再次安装或重跑已通过测试。若环境丢失，按新环境说明和版本快照重建，再重新验证。
4. 源数据`results/M11/phase2b_20261016_reset_sync`保持原样；重绘副本在build/env_setup_20261028/p2b_reanalysis。
5. 保护历史P1 ZIP、P2/P2B原始数据、bit/routed报告及源归档，勿因位于build或.gitignore中就删除。
6. 没有Git commit可引用；当前任务完成不表示用户已批准首次提交、2026.1适配或硬件测试。
