boksop/swcell/docs/tasks/m20-300-software-20261028.md

# M20-300-SOFTWARE-20261028：ISA 工具和游戏机器程序

- 状态：COMPLETED（本轮 V0 软件任务）；2026-10-28，Asia/Shanghai。
- 依据：用户指定 `docs/m20/M20_300_architecture_v0_1.md`；不沿用旧 747 的字节 ISA/IR/B/T/LR/63 微状态。
- 目标：真实 16-bit 编码/汇编/解释执行、两套游戏核心机器程序、ROM/动态指令/周期预算、ISA 缺项复核。
- 范围：软件 V0；不创建 RTL/FPGA 工程、不修改 XDC/Tcl/M11 源码或结果，不运行硬件，不改用户架构源文件。
- Git：main 无首个 commit；仍原四份文档 staged。未新增暂存/commit/push；无可引用 commit。

## 已完成（均已验证）

- [x] 新候选架构检查：PC12 word 编址、16-bit 单 word 指令、无 IR/B/T/LR、RAM 直接 ALU 操作数、软件单层返回编号。
- [x] `host/python/m20/{isa,assembler,machine,__main__,__init__}.py` 通用编码、汇编、指令解释及 CLI；二进制/memh/listing/符号/trace。
- [x] `software/m20_300/{pong,snake}.asm` 及规则/ABI README：168/368 words、336/736 bytes；无 OLED。
- [x] `game_reference.py` 独立数学 oracle；`benchmarks.py` 预置夹具/定向与随机场景、RAM 写白名单/不变量、连续执行、动态统计/输出指纹。
- [x] `host/python/tests/test_m20_300.py` 15 项；`test_m20_games.py` 10 项。新 25 项加既有 52 项，完整 77 项 PASS。
- [x] 正式 V0 benchmark：Pong 1077/Snake 1081 场景，固定种子；每游戏 512 tick 由 CPU 连续执行，boot 后宿主不回写 RAM。
- [x] 最大观测场景完整输入及 retire trace，镜像/事务/计数/时间预算输出一致性验证；两游戏最大为 308/13419 模型周期，含循环分别 312/13423。
- [x] `docs/m20/M20_300_isa_v0_1.md`、`M20_300_software_validation_v0_1.md` 和 M20 索引/软件 README 已核对；ISA 对两核心无必须新增指令。
- [x] 既有 308 文件内容/路径映射、用户架构原文和 Git index 指纹不变；六份相关 MD 的 30 个相对链接及代码围栏检查通过。

本轮无已修改但未验证的代码。后续硬件/OLED 工作不属于本任务验收条件。

## 关键设计决策

1. 高 4 位 major opcode，子编码、保留位和 flags 明确在软件 ISA 文档；15,015 合法、50,521 保留编码，保留位非零 TRAP，无副作用。
2. LD/LDI/logic 更新 Z 保留 C；AR_CTRL/IO 保持 Z/C；减法 C=无借位。MOVA/IN 改 A 但不改 Z，要判断需显式操作。后续 RTL 必须按版本匹配。
3. 普通 2、RAM 5、reset 单列 1 为候选软件成本；不是 RTL 微周期/传播延迟仿真，不证明 328 MUX、主频或完整帧率。
4. RETURN_ID 占普通 RAM F0，单层调用，函数以现有指令分派，无 CALL/RET/LR/栈；参数和分派全部纳入动态计数。
5. Snake 食物为 CPU 有界线性探测，非随机；损坏位图 65 次候选后显式诊断。身体环/位图/增长/碰撞由机器程序完成。
6. 逐场景夹具只在 CPU 启动前装载；独立数学模型只核对输出。另测脏 RAM boot 与连续循环，防止宿主更新掩盖指令程序问题。
7. 游戏镜像分别链接；暂未合并镜像。未实现 OLED/SPI/软件消抖/WAIT，不把旧 747 预算套用到新架构。
8. 子 Agent 分别完成通用工具/Pong/Snake，根维护 oracle、预算、回归、文档和进度；最终只读交叉复核已通过。修复预算辅助 drive 恰好在 limit 抵达断点的边界并覆盖测试。

## 测试与验证

|测试项|命令/方法|结果|证据或日志|备注|
|---|---|---|---|---|
|完整 Python 回归|`PYTHONDONTWRITEBYTECODE=1 PYTHONPATH=host/python MPLCONFIGDIR=/home/boksop/swcell/build/m20_300/software_v0_1/matplotlib build/venvs/python312/bin/python -B -m unittest discover -s host/python/tests -v`|PASS，77 项/6.041s|`build/m20_300/software_v0_1/python_tests.log`|52 既有+15 ISA+10 游戏；无硬件测试|
|V0 游戏 benchmark|`PYTHONDONTWRITEBYTECODE=1 PYTHONPATH=host/python build/venvs/python312/bin/python -B -m m20.benchmarks --output build/m20_300/software_v0_1 --random-cases 1000`|PASS|`summary.json`、`benchmark.log`、`case_metrics.csv`|2158 场景；各 512 连续 tick|
|ISA 编码与指令|独立 mask 全编码、全非法字 TRAP、4-bit 算术/逻辑 oracle、全地址/输入及异常|PASS|`test_m20_300.py`、完整回归日志|不依赖游戏模型或 RTL 实现|
|故障检测|错 IN 指令比较失败、损坏位图诊断、非法返回 ID HALT|PASS|`test_m20_games.py`、完整回归日志|负向测试通过不等于所有任意损坏可恢复|
|导出和预算|镜像 SHA/字节、最大场景完整 trace、事务/动态周期、假设时钟换算|PASS|`test_m20_games.py`、`clock_budget.csv`|时间源标记 ASSUMED_NOT_MEASURED|
|静态链接/保护范围|六份相关 MD/30 相对链接；12 个新软件源码指纹；308 个既有文件/index/架构指纹|PASS|`verification.json`、`legacy_files_after.json`、`baseline.json`|不写旧源文件、旧数据或 Git 索引|
|RTL 语法/elaboration / XSIM|本任务不创建 CPU RTL|NOT_RUN|V1/V2 尚未开始|不能将 Python PASS 当 XSIM PASS|
|综合 / 实现 / STA|本任务不创建 M20 工程|NOT_RUN|后续独立任务|不引用 M11 时序代替|
|FPGA / 157 实物|本任务不运行硬件|NOT_RUN|无|无正式阶段实物验收结论|

## 已知限制和后续计划（本轮范围外）

- V1 优先实现 CPU/总线 RTL，并与当前 retire trace 逐指令比对 PC/A/AR/Z/C/GPO/RAM；覆盖无 IR 时 PC/ROM 稳定、写脉冲/地址保持、HALT/TRAP。
- 为 FPGA BRAM 或外部异步 SRAM/NOR 明确采样边沿/延迟，必要 WAIT 的周期及结构成本须新审计。
- 补 OLED/SPI、键消抖和 tick 定时后重新实跑程序容量/完整帧周期，当前不能给完整游戏 FPS。
- 328 核心 MUX 只为用户提案点估；ALU40、控制70、使能/复位和辅助 BOM 均需结构级实现后计数；不能从软件或 LUT 数倒推物理157。
- 最大周期是保存夹具上的最大观测，不是全 RAM 状态最坏上界。Snake 随机测试涵盖两类连通身体，仍非穷举。
- 当前仓库多数工程仍未跟踪，源码/文档尚无 commit。首次提交纳管清单是此前快照，若准备提交应重做清单以纳入本轮新文件；须用户另行授权。

## 证据指纹

- 用户架构：`65e7ca419dd37183880116d7b4ab191a53b38eee2c9d7aa8601e8d71f265a16a`。
- 308 个既有文件路径→SHA256 映射的 `json.dumps(sort_keys=True)` 摘要：`f041b6f2968310a116071cfdbee184aab5f431abbe10f4f6b739a69909949f69`（含原 bytecode，不包含新增 M20 包/测试）。
- Git index：`ac2b0d7c6dbd88a804b174f62e84e0c672a987d508deabbed8bd5ff3d0ef0c6a`。
- 程序源/镜像和 12 份软件源码 SHA：见 `summary.json` 与验证报告。

## 下一次恢复入口

1. 本任务完成，无未验证代码。打开 `docs/m20/M20_300_software_validation_v0_1.md`、ISA 文档、`software/m20_300/README.md` 和用户架构。
2. 若仅复现，运行上表完整回归和 benchmark（建议输出新目录）；检查真实 JSON/CSV/trace，不依赖本文件 PASS 文字。
3. 若用户开始下一任务，再按 V1 创建 CPU/总线 RTL 对照模型；不要因用户源架构的旧“未实现工具”描述重复重写 V0。
4. 不改 M11 数据，不自动 Vivado/烧写，不混用 747 ISA；不自动暂存/commit/push/切分支。根 TASK_PROGRESS 由主 Agent 协调写入。
