boksop/swcell/docs/tasks/m20-300-v1-20261028.md

# M20-300-V1-20261028：ISA冻结至V1.3

- 状态：COMPLETED；最近更新2026-10-29（Asia/Shanghai）。
- 目标：正式ISA v0.1、33位可综合功能RTL、XSIM单元与Python差分、原Pong/Snake ROM真实RTL执行。验收终点V1.3已达到。
- 范围外：MUX复杂优化/准确157计数、OLED、WAIT、板级约束、综合/实现/STA/bitstream/实物。未开展这些工作。
- Git：main无首个commit，原staged四份不变；无新增暂存/commit/push/分支操作，无关联commit。

## 已完成（均有验证证据）

- [x] 从实际文件/进程恢复：旧进度不完整，冻结文件及6测试实际已落盘，RTL/TB此前未落盘；无运行进程，未重复改写冻结主体。
- [x] V1.0：M20_300_ISA_FROZEN.md、isa_v0_1.json、正式ID/legacy来源；编码/语义不变，45规则全65536匹配及原机器码SHA验证通过。
- [x] V1.1：rtl/m20七模块，33功能FF；普通EXEC、RAM_RELEASE提交，无IR/临时数据/调试FF；xvlog与xelab通过。
- [x] V1.2：全编码译码、全四位ALU、独立总线/周期断言、active-WE复位及终端保持；49 CPU指令case真实差分通过。
- [x] V1.3：38游戏case，原ROM boot/连续64tick/关键边界/63探测/64封顶/重启/内存适配，逐事件与最终256nibble RAM全部相同。
- [x] 自动入口sim/scripts/run_m20.sh、host/python/m20/rtl_regression.py；实际RTL CSV由XSIM写出，Python只生成预期/离线比较；错误保留输入/日志/WDB。
- [x] Python86项PASS（原77+冻结6+比较器3）；比较器缺数据/未知值/逐字段/最终RAM破坏负向测试通过。
- [x] 源码/规则覆盖与原件保护：45/45规则实际执行，32份运行源指纹一致，308旧文件+解释器/汇编器/游戏/架构/index不变。
- [x] 四份V1文档、M20/软件索引和进度已更新；资源风险明确，不把仿真当157数量或物理主频证明。

无已修改但未验证的功能代码。本任务完成不代表用户已经正式验收实物阶段。

## 重要实现/接口决定

1. ISA冻结仅编码/标志/软件可见状态/操作语义。8状态FSM、PC/AR内部结构、周期/预算可后续优化；周期变化必须更新显式profile/性能模型/测试。
2. 当前profile M20-300-V1-TIMING-0.1：普通2/RAM5/reset1单列。RAM读/ALU写回统一RELEASE，无数据临时寄存器；ST只ACCESS写，RELEASE退役。
3. 33位：PC12+AR8+A4+ZC2+GPO4+uSTATE3。retire/debug全组合，TB preedge捕获旧PC/ROM与提交后投影，NBA后核对真实状态；核心不增加trace/计数寄存器。
4. FAULT仅软件短镜像/仿真映射元数据，无核心FAULT端口或锁存器。CPU完整4096 ROM未加载区FFFF实际TRAP，不能伪装FAULT。
5. TB启动边界可deposit寄存器/RAM夹具；执行期间仅提供keys，游戏状态全由CPU机器指令推进。正常boot从标准复位及非零RAM运行。
6. OE跨三个MEM状态仍只一次逻辑读；同步适配重复取样不增加ISA read。ST物理写后再reset不回滚；WE已高但边沿未到时reset应立即阻断，已真实覆盖。
7. 异步ROM1.5ns、异步RAM2ns及同步RAM读适配通过；不支持可变WAIT，不证明同步ROM/最终BRAM/物理器件建立保持。仿真10ns时钟不是Fmax。
8. 原328预算中仅33位状态/66颗DFF storage等价可精确核对；其余262组合/保持/CE/复位未结构审计。FPGA验证辅助、外部器件及同步器另列，不隐藏资源。

## 实际测试记录

完整命令：`sim/scripts/run_m20.sh`，实际退出0，证据根`build/m20_300/v1/`。工具实际Vivado Simulator2026.1.1。无新xpr或bitstream。

|测试项|执行方法|结果|证据|边界|
|---|---|---|---|---|
|Python全回归|脚本unittest discover|PASS，86项/5.541s|python_tests.log|原77+冻结6+比较器3|
|冻结规则/镜像|6项freeze测试|PASS，65536匹配15015/50521，机器码不变|isa_frozen_tests.log、完整Python日志|只ID/注释元数据改变|
|RTL语法与elaboration|xvlog及三份xelab snapshot|PASS|xsim/compile.log、tb_m20_*.elaborate.log|非综合；LIBRARY_PATH非阻塞warning记录|
|RTL译码|tb_m20_isa全word|PASS，65536|xsim/isa.log|全空间是译码单元，不声称全50521逐个CPU异常|
|RTL ALU|独立数学oracle|PASS，32768vectors|xsim/isa.log|64内部op×16×16×2，含独立写使能|
|内存与运行中reset|tb_m20_memory|PASS，7checks|xsim/memory.log|最终版本含WE已经高时reset阻断|
|CPU指令差分|49cases，22223events，51193cycles|PASS|instructions/comparison.json、xsim/instructions.log|完整状态/事务/实际周期与RAM|
|游戏CPU差分|38cases，35108events，115651cycles|PASS|games/comparison.json、xsim/games.log|boot及各64tick持续；63探测等定向场景|
|执行覆盖|实际CSV按规则分类|PASS，45/45，57314正常退休+17TRAP|coverage.json、verification.json|观测A/Z/C八种改变模式都覆盖|
|源/保护基线|32运行源、308旧文件、V0输入/index指纹|PASS|inputs_manifest.json、baseline.json、verification.json|未改M11/游戏/Python参考算法|
|综合/实现/STA/硬件|范围外|NOT_RUN|无|不能从仿真推物理时序/157计数|

## 产物与证据

- 文档：docs/m20/M20_300_ISA_FROZEN.md、M20_300_V1_RTL_DESIGN.md、M20_300_V1_VERIFICATION.md、M20_300_V1_TEST_REPORT.md；规则isa_v0_1.json。
- RTL：rtl/m20/m20_{pkg,alu,decoder,pc,ar,control,cpu_core}.sv。
- TB：sim/m20/{rom_model,ram_model,tb_m20_isa,tb_m20_memory,tb_m20_cpu}.sv、m20_tb_fixture.svh、run_all.tcl。
- 自动工具：sim/scripts/run_m20.sh、host/python/m20/rtl_regression.py、test_m20_frozen.py/test_m20_rtl_tools.py；isa.py正式ID/legacy来源。
- 输出：87个启动ROM/RAM/keys、独立预期JSONL、实际CSV和完整最终RAM；两个comparison.json，coverage/verification/input manifests及4个WDB。
- 一次早期root cwd编译产生的仅M20缓存已核对并移入build/m20_300/v1/root_compile_cache，旧.Xil保留。正式编译都在build；没有删除旧缓存/源码。
- 机器码Pong168word/336B，SHA e1029928d763ab5b0d21fe347687f52b326f545e9072f4c04365597439eead8c；Snake368word/736B，SHA466cb149c8e5d6914d0b78dc8a3ec5074c77020edf880cedbd520b41b3376b98。

## 下一次恢复入口

1. 本轮已完成V1.3，无未验证功能修改。先看M20_300_V1_TEST_REPORT.md、冻结ISA和设计/验证文档，核实build证据后再决定下一任务。
2. 重跑用`sim/scripts/run_m20.sh`，建议M20_OUTPUT_DIR指向新的build目录。Python比较可离线运行`python -m m20.rtl_regression compare --directory <suite>`；不要多进程写同一目录。
3. 下一阶段候选为结构化MUX/计数，或同步ROM/BRAM/外设集成，须另明确范围；本轮不提前实现OLED/FPGA工程。
4. 保持ISA不变；周期优化更新profile/模型/测试。V1作为可信行为参照，不能为了结构版本方便修改解释器/游戏含义。
5. 不改M11/旧测试证据/用户架构原文；不自动暂存/commit/push/改分支。Git多数工程未跟踪，准备首次提交时重新核对纳管清单并获得授权。
6. 根TASK_PROGRESS由主Agent维护；正式阶段验收报告按AGENTS在用户确认后进入docs/reports，当前报告只表述已执行RTL仿真结果。
