boksop/swcell/docs/tasks/m20-300-v2-20261029.md

# M20-300-V2-20261029：结构实现与精确资源审计

状态COMPLETED；2026-10-29，Asia/Shanghai。结构/等价/精确审计已完成，数量未达300或328，不冒充数量目标通过。Git纳管/后续优化等待用户决定，未commit/push。

## 完成清单（实际证据核实）

- [x] V1/旧文件1191项SHA保护，含旧V1目录848文件；未增删覆盖原证据，源快照保存在v2。
- [x] 现有run_m20.sh新目录v1_recheck复跑PASS：86 Python、87case/57331events。
- [x] 安全Git提案及实际201文件CSV已完成，排除build/缓存/波形/数据/个人文件，历史归档方式明确；不执行提交。
- [x] 唯一swc_mux157与MUX DAG/ALU构造、反相/AND/OR/XOR/算术/共享规则，7项独立构造测试PASS。
- [x] 分组结构ALU、A/Z/C、PC、AR、GPO、译码/控制、RAM/IO；全部组合显式MUX，FF无条件更新、保持/reset额外。
- [x] baseline与shared两版源码/连接JSON；33位状态，无IR/B/T/LR或新增游戏功能；实际2/5profile未变。
- [x] 两版XSIM全部单元与V1/V2/Python三方；原49CPU+38游戏及输入/预期不改，每版57331事件和全部RAM一致。
- [x] 独立SV/JSON逐实例/每pin/FF-D/功能根/共享检查，5项审计负向测试PASS，CSV/JSON/MD可重生成。
- [x] 12份SV/JSON隔离重生成逐字节一致；全Python98tests PASS。
- [x] 四份V2文档及328/300偏差/优化风险完成；V1已确认阶段正式报告补入reports索引；最终进度及保护检查完成。

当前没有已落盘未验证的功能修改。后续优化、物理DFF和上板均不属于本轮已执行范围。

## 数量与设计决定

|项目|baseline|shared|
|---|---:|---:|
|组合MUX|672|537|
|显式CE保持（组合子集）|30|30|
|显式复位（组合子集）|33|33|
|状态bit|33|33|
|DFF等价2/bit|66|66|
|核心157等价|738|603|
|MUX拓扑最大层数|50|50|

- 603相对328超275、相对300超303。当前具体网表不是ISA全局最小成本下界；不能保证再CSE即可到300。
- 一颗显式swc_mux157对应一颗单通道157；常量tie/线0成本，NOT真实计数。standalone ALU/decoder用于单测不重复加入core top。
- 同一MUX输出多消费者按唯一实例归属一次；shared合并相同S/I0/I1，包含NOT，合计省135（decoder95/control13/ALU27）。不把共享请求数当额外器件。
- baseline也用同一初始单热/加减复用构造，不是人为最差；只有global hash-cons是本次优化开关。
- nativeFF只存状态；CE/reset在MUX D网络里显式实现，uSTATE连续next-state没有3个冗余CE。retire仅有效时投影有定义，观察不额外造功能门。
- 原ISA/2-5profile和V1功能/游戏/历史证据不改。内部单热避免op编码/再解码但没有新ISA操作。
- CSE未增加拓扑深度，但50层不是物理延迟/Fmax；rst最大34pin、内部MUX最大21pin，真实驱动/缓冲和反馈DFF时序未证明。
- DFF2MUX为折算；六键同步storage24、复位同步storage4、物理存储/总线方向/时钟驱动/PCB辅助另列，不藏到核心里。

## 实际测试表

|测试项|方法/命令|结果|证据（build/m20_300/v2/）|备注|
|---|---|---|---|---|
|V1基线|M20_OUTPUT_DIR=.../v1_recheck sim/scripts/run_m20.sh|PASS|v1_recheck/verification.json|86tests、87case57331events|
|V2原语/译码/ALU|两版XSIM|PASS|regression_r2各版xsim/mux.log、isa.log|每版8/65536/32768|
|V2内存/reset|两版双核单元|PASS|regression_r2各版xsim/memory.log|7组含active WE reset|
|V2指令三方|49case/22223events每版|PASS|各版instructions/three_way_comparison.json|实际执行51193cycles，锁步51340含终态147|
|V2游戏三方|38case/35108events每版|PASS|各版games/three_way_comparison.json|115651cycles；含各连续64tick及63探测|
|独立实例审计|python -m m20.v2_audit|PASS|docs/m20/v2_resources/audit.json、audit.log|SV/pins/JSON/FF/功能根，无LUT换算|
|完整Python|unittest discover|PASS，98tests/10.331s|python_tests.log|原86+构造7+审计5|
|结构再生|python -m m20.v2_build --output .../reproduced|PASS，12文件逐字节相同|regeneration_check.json|不覆盖已通过结构|
|原件保护|1191项SHA/旧V1完整文件集合/index|PASS|final_baseline_check.json|848旧证据文件名/内容保持|
|防写V1目录|prepare/compare/Shell负向CLI|PASS，3项|v1_guard_negative_tests.json|不是CPU仿真|
|综合/STA/bitstream/物理电路|范围外|NOT_RUN|无|不冒充157性能验证|

## 失败与修复

首轮regression真实xelab FAIL：MUX实例与net同名。已改u_m实例前缀、连接JSON同步，重生成数量/逻辑不变；另目录regression_r2全部PASS。首轮日志保留，不能覆盖或标PASS。独立audit初稿未聚合ALU子group，修正报告映射后各行预算总和核对603，计数核心未变。

## 产物与未执行事项

- 新源码：rtl/m20/v2唯一原语和两版generated（12文件）；host/python/m20/v2_{muxlib,alu,build,audit,verify}.py；sim/m20_v2三方TB/fixture/单元/Tcl；sim/scripts/run_m20_v2.sh；两个新Python测试文件。
- 文档：STRUCTURE/MUX_BUDGET/VERIFICATION/TEST_REPORT四文件，v2_resources三份CSV/JSON，Git基线提案及201文件清单。
- 源码与原始数据在build里保留SHA/WDB/CSV/RAM/输入/预期；约270MiB波形不入Git，长期保全建议另存证据介质。
- M20用户已在本轮确认V1完成，按AGENTS新增docs/reports/m20_phaseV1_20261029.md与索引；V2本身尚待用户确认，不写正式通过。
- 未作PC/AR增量器共用/微状态更改/新ISA/更多优化，不创建FPGA工程/引脚或bitstream，不运行硬件。

## 下一次恢复入口

1. 本轮完成。先读M20_300_V2_TEST_REPORT.md和MUX_BUDGET，核对v2/regression_r2/v2_verification.json与v2_resources/audit.json；不要重做已通过代码。
2. 复跑必须新输出：M20V2_OUTPUT_DIR=build/m20_300/v2/recheck sim/scripts/run_m20_v2.sh；不要误用V1的M20_OUTPUT_DIR。
3. 如用户选择继续优化，一次明确一个方案、保留603基线、报告MUX/拓扑/负载变化并复跑两版三方；不要改V1或Python预期。
4. 如用户选择FPGA阶段，再另定存储/时钟/外设/引脚与STA范围；本轮未授权自动推进。
5. Git201文件提案待确认，最终确认后若文件变化须重生成大小/SHA清单；未授权不add/commit/push/切分支。
6. 进度由根维护；本轮原件SHA保护覆盖1191文件和Git索引，后续也须保留V1/M11和原始失败证据。
