boksop/swcell/docs/tasks/m20-v21-physical-20261102.md

# M20-V21-PHYSICAL-20261102

状态COMPLETED，2026-11-02（Asia/Shanghai）。V2.1本轮数字/结构自动验收通过；V2.2分析规格已交付，实物/正式PCB放行TBD。用户接受500+规模，不再以300为目标推翻架构。根Agent维护；未经用户确认不生成正式阶段验收报告。

## 已完成

- [x] V1/603/ISA/游戏/候选关键文件SHA保护，Git main未有commit，原四份staged不变。
- [x] 独立正式rtl/m20/v21、v21_build/audit/verify；477完整组合/476功能组合+33x2；完整退役/异常接口，保持33状态和2/5profile。
- [x] 逐pin/FF-D/reset/未知源/多驱动/组合环/死网、功能与debug锥、拓扑/扇出及负向测试。
- [x] 当前权威regression_r3：65536合法性/50521非法实际终态及50521恢复、27840数学向量、3 XZ探测、7memory、49指令+38游戏/57331事件三方全部PASS。
- [x] 110 Python tests/10.163s；两份正式SV/JSON隔离再生字节一致；3种防写历史路径负测PASS。
- [x] 原厂参数JSON/CSV、物理分析工具physical.py，Top50完整弧、特定路径族、负载/功耗/频率、33 DFF接线、IO与BOM表。
- [x] 真实游戏CSV对图D投影一致，找到79对最短路径源/目的同边沿活动见证；最短有效见证4级。最长拓扑ROM→state29、FF→FF16；Top50随机3000组无静态见证，不能当不可敏化证明。
- [x] 简化主从模型预期竞态、4bit非重叠16捕获；FPGA同步ROM/RAM联合5指令、16执行+1reset周期/单写/已采样reset阻断/窗口外WE毛刺过滤PASS。
- [x] 12份用户要求文档、目录/主README入口、Git精确提案及最终保护核对。

## 关键设计决定

543只含核心存储折算和1个trap_event观察门，纯功能542；603与V1不可覆盖。原生FF继续作可信数字参考，不把FDRE参数用于真实157。全部CPU逻辑仍为157，FPGA只提供外围和时钟/监视。

真实DFF数据表没有setup/hold/CLK→Q或tCD保证；最小tpd不可替代污染延迟。推荐P1/P3评估非重叠两相（66个clock选择负载），额外缓冲/复位/电源监视器另列BOM。100kHz作为小样起点，低频不解决hold。

FPGA服务草案M20-FPGA-MEM-SERVICE-0.1，外设RTL唯一sys_clk，固定窗口采样，pending写在逻辑CPU边沿提交，reset取消待写不回滚已写。接口测试调度不是最终板级时钟控制器；没有静默增加WAIT。物理相位草案M20-157-PHASE-DRAFT-0.1待测，不改冻结微周期。

## 测试表

根build/m20_300/v21/；每项数字PASS不等于物理PASS。

|项目|命令/方法|状态|证据|
|---|---|---|---|
|编译/elaboration/数学/译码/异常|run_m20_v21.sh|PASS|regression_r3/xsim各log|
|全非法实际终态与恢复|tb_m20v21_illegal|PASS，50521|regression_r3/xsim/illegal.log|
|V1/正式版/Python|同脚本，原49/38用例|PASS，57331事件及完整RAM|regression_r3/verification.json|
|内存/reset/FSM|原7组+逐边沿断言|PASS|regression_r3/xsim/memory.log及CPU logs|
|Python全量|python -B -m unittest discover -s host/python/tests -v|PASS，110|session_20261102/python_tests_final.log|
|独立结构|python -m m20.v21_audit|VERIFIED，543/542|docs/m20/v21_resources/audit.json|
|确定性再生|python -m m20.v21_build --output新目录|PASS，2文件|session_20261102/reproduction.json|
|图/负载/频率/短路径|python -m m20.physical --traces .../games|VERIFIED图/ESTIMATED物理|docs/m20/physical_resources/及trace_manifest.json|
|DFF数字延迟示例/适配器|run_m20_physical_models.sh|PASS，示例及预期竞态被捕获|physical_models_r2各log|
|综合/实现/STA/bitstream/实物/SPICE|未执行/无可用晶体管模型|NOT_RUN|无，不伪造|
|原件/index保护|SHA逐项比较|PASS，144初始+1191历史清单|session_20261102/final_receipt.json|

## 失败与修复

首轮regression_20261102中手动clock宏泄漏使memory无时钟/watchdog，undef后r2通过；加强审计canonical输入/reset值后r3重新通过。最初Python负向测试设置的pin恰等原值，测试自身FAIL，改为真正不同pin后通过。首次物理分析局部变量覆盖输出目录导致TypeError，改名后完成；没有用失败输出代替最终CSV。

原候选545非法转入HALT的失败证据保留；原ZIP/临时543未覆盖。原厂PDF浏览核对成功，但命令行下载403，sources.json明确记录无本地PDF校验值。时钟缓冲完整数据表/最终选型仍TBD。

## 交付与未闭合风险

入口docs/m20/M20_300_V2_1_{STRUCTURE,MUX_AUDIT,VERIFICATION,TEST_REPORT}.md及M20_PHYSICAL_FEASIBILITY.md和其七份专题。当前所有正式功能修改已经验证。

physical_resources包含Top50、每类/每端点、79个co-launch、负载、功耗/频率、三器件参数、DFF33绑定、59基础IO和BOM。标记VERIFIED/ESTIMATED/TBD；TBD项不因文档完成而变成通过。默认LVC85℃模型有3个超测试负载网，Cin无max、真实DFF最小延迟/死区/时钟skew和PCB/FPGA IO时序均待测；所有频率最终资格TBD。

## 下一次恢复入口

1. 先读V2.1_TEST_REPORT、PHYSICAL_FEASIBILITY及TASK；检查session_20261102/final_receipt.json与当前Git。V2.1新权威是regression_r3；r2与旧候选只是历史证据。
2. 无未完成正式功能代码。若仅问进度，不重复实现或覆盖数据。下一范围应由用户决定P1/P3小样和物理相位/器件选择；不自动再追300、上板或创建PCB/XDC/bitstream。
3. 重验使用新M20V21_OUTPUT_DIR；物理模型使用新M20_PHYSICAL_MODEL_OUTPUT；生成器输出新目录。原V1/V2/候选目录禁止写入。
4. 原始证据在build被Git忽略，应按Git提案独立备份；不自动commit/push。M20_V21_GIT_FILES.csv只是待确认计划，任何文件变化后重算SHA，不声称已跟踪。
5. 用户确认V2.1正式通过后，按AGENTS另写docs/reports正式中文报告并更新索引；目前只有技术测试报告，实物未通过。
