boksop/swcell/docs/m20/v31_release_resources/recovery/clean_synthesis.txt

INFO: [Common 17-3922] A valid Vivado Design Suite GOLD license has been detected. Your current license is active and will expire on Permanent.

****** Vivado v2026.1.1 (64-bit)
  **** SW Build 6605303 on Fri Sep 04 05:45:32 MDT 2026
  **** IP Build 6603865 on Fri Sep 04 05:05:05 MDT 2026
  **** SharedData Build 6605217 on Fri Sep 04 02:50:14 MDT 2026
  **** Start of session at: Thu Nov  5 13:03:57 2026
    ** Copyright 1986-2022 Xilinx, Inc. All Rights Reserved.
    ** Copyright 2022-2026 Advanced Micro Devices, Inc. All Rights Reserved.

source /tmp/swcell-v31-restore-alaFmk/fpga/projects/m20/autonomous/scripts/build.tcl
# proc main {} {
#  global argv swc
#  source [file join [file dirname [info script]] ../../../../common/tcl/repo_paths.tcl]
#  set root [swc_repo_root [info script]]
#  source [file join $root fpga boards swcell_k325t board.tcl]
#  if {$swc(part) ne "xc7k325tffg900-2"||$swc(clk_hz)!=50000000} {error "Review V3 constraints for this board part/clock"}
#  set stage bitstream;set output "";set rom ""
#  foreach {key value} $argv {
#   switch -- $key {--stage {set stage $value} --output {set output $value} --rom {set rom $value} default {error "Unknown argument $key"}}
#  }
#  if {$stage ni {synth bitstream}} {error "Invalid stage"}
#  if {$output eq "" || $rom eq ""} {error "Explicit fresh --output and --rom required"}
#  set output [file normalize $output];set rom [file normalize $rom]
#  if {![string match "[file join $root build]/*" $output]||[file exists $output]} {error "Choose fresh output under build/"}
#  if {![file isfile $rom]} {error "Missing ROM"}
#  file mkdir $output
#  set sources {}
#  foreach n {swc_input_sync swc_power_on_reset swc_debounce swc_uart_rx swc_uart_tx swc_uart_hex_json} {lappend sources [file join $root rtl common ${n}.sv]}
#  set v3 [file join $root rtl modules m20 v3]
#  lappend sources [file join $v3 swc_v3_mux157.sv] [file join $v3 generated m20v3_cpu_core.sv]
#  foreach n {swc_m20_v31_memory swc_m20_v31_service swc_m20_v31_gpio} {lappend sources [file join $root rtl modules m20 v31 ${n}.sv]}
#  lappend sources [file join $root fpga projects m20 autonomous rtl swcell_m20_v31_top.sv]
#  set xdc [file join $root fpga projects diagnostics oled_keys constraints io.xdc]
#  set inputs [concat $sources [list $xdc [info script] $rom [file join $root fpga boards swcell_k325t board.tcl]]]
#  set hashes [dict create];set f [open [file join $output source_sha256.txt] w]
#  foreach file $inputs {
#   set file [file normalize $file]
#   set digest [lindex [exec sha256sum $file] 0];dict set hashes $file $digest
#   puts $f "$digest  [string range $file [expr {[string length $root]+1}] end]"
#  };close $f
#  create_project -in_memory -part $swc(part)
#  set_property verilog_define {SWC_V3_XILINX} [current_fileset]
#  foreach file $sources {read_verilog -sv $file}
#  set f [open [file join $output software_profile.txt] w];puts $f "ROM_FILE=$rom";close $f
#  synth_design -top swcell_m20_v31_top -part $swc(part) -flatten_hierarchy none -generic [list ROM_FILE=$rom]
#  read_xdc $xdc
#  create_clock -name sys_clk -period 20.0 [get_ports sys_clk]
#  set_output_delay -clock sys_clk -max 5.0 [all_outputs]
#  set_output_delay -clock sys_clk -min 0.0 [all_outputs]
#  set first [get_pins -hier -quiet -regexp {.*(sync_keys|reset_sync|rx_sync|sync_inputs)/pipe_reg\[0\].*/D}]
#  if {[llength $first]!=9} {error "Expected six GPI plus reset/debug/RX first synchronizers, got [llength $first]"}
#  set_false_path -from [get_ports {RST_N KEY0 KEY1 KEY2 KEY3 KEY5 KEY6 KEY7 UART_RXD}] -to $first
#  # No false paths or unconstrained fabric clocks in CPU logic. Try ordinary 50MHz STA first.
#  set muxes [get_cells -hier -filter {REF_NAME == LUT3 && NAME =~ *cpu*cell_mux}]
#  set expected 477
#  if {[llength $muxes]!=$expected} {error "CPU mux mapping differs: [llength $muxes], expected $expected"}
#  set f [open [file join $output cpu_mux_cells.txt] w];foreach cell $muxes {puts $f $cell};close $f
#  report_utilization -hierarchical -file [file join $output synth_utilization.rpt]
#  report_timing_summary -report_unconstrained -file [file join $output synth_timing.rpt]
#  report_drc -checks [get_drc_checks LUTLP-1] -file [file join $output feedback_drc.rpt]
#  if {$stage eq "synth"} {puts "M20_V31_SYNTH_COMPLETE mode=FUNCTIONAL_STORAGE muxes=[llength $muxes]";return}
#  opt_design
#  place_design
#  route_design
#  report_timing_summary -report_unconstrained -file [file join $output timing.rpt]
#  report_utilization -hierarchical -file [file join $output utilization.rpt]
#  if {[llength [info commands report_ram_utilization]]} {report_ram_utilization -file [file join $output ram.rpt]}
#  report_io -file [file join $output io.rpt]
#  report_cdc -details -file [file join $output cdc.rpt]
#  report_drc -file [file join $output drc.rpt]
#  write_checkpoint [file join $output routed.dcp]
#  set violations [get_drc_violations -quiet]
#  if {[llength $violations]} {error "DRC_BLOCKED_FUNCTIONAL_STORAGE: [llength $violations] violations; no bitstream; see drc.rpt"}
#  foreach type {max min} {
#   set p [get_timing_paths -delay_type $type -max_paths 1]
#   if {[llength $p]!=1||[get_property SLACK $p]<0} {error "FPGA_TIMING_FAILED_$type; no bitstream"}
#  }
#  # Retain explicit check_timing evidence; clocked native storage is all in sys_clk.
#  check_timing -verbose -file [file join $output check_timing.rpt]
#  dict for {file digest} $hashes {if {[lindex [exec sha256sum $file] 0] ne $digest} {error "SOURCE_CHANGED_DURING_BUILD $file"}}
#  set_property BITSTREAM.STARTUP.STARTUPCLK JTAGCLK [current_design]
#  set_property BITSTREAM.GENERAL.COMPRESS TRUE [current_design]
#  write_bitstream [file join $output swcell_m20_v31_top.bit]
#  puts "M20_V31_BITSTREAM_PASS $output/swcell_m20_v31_top.bit"
# }
# if {[catch {main} message]} {puts stderr "M20_V31_BUILD_ERROR: $message";exit 1}
## proc swc_repo_root {script_path} {
##     set dir [file dirname [file normalize $script_path]]
##     while {1} {
##         if {[file isfile [file join $dir AGENTS.md]] && [file isdirectory [file join $dir rtl]] && [file isdirectory [file join $dir fpga]]} {return $dir}
##         set parent [file dirname $dir]
##         if {$parent eq $dir} {error "Cannot locate SwCell repository from $script_path"}
##         set dir $parent
##     }
## }
## set swc(part) xc7k325tffg900-2
## set swc(clk_hz) 50000000
## set swc(flash_model) N25Q256A13EF840F
## set swc(flash_enable) 1
## set swc(boot_mode_bits) 001
## set swc(flash_cfgmem_part) mt25ql256-spi-x1_x2_x4
## set swc(flash_cfgmem_alias) n25q256-3.3v-spi-x1_x2_x4
## set swc(flash_size_mib) 32
## set swc(flash_buswidth) 4
## set swc(flash_transfer) SDR
## set swc(flash_fall_edge) 1
## set swc(flash_32bit_addr) 1
## set swc(flash_compress) 1
## set swc(configrate_mhz) auto
## set swc(flash_tco_ns) 7.0
## set swc(fpga_spi_setup_ns) 3.0
## set swc(cclk_tolerance) 0.5
## set swc(flash_sdr_max_mhz) 108.0
## set swc(fpga_cclk_max_mhz) 100.0
## set swc(flash_board_delay_budget_ns) 2.0
Command: synth_design -top swcell_m20_v31_top -part xc7k325tffg900-2 -flatten_hierarchy none -generic ROM_FILE=/tmp/swcell-v31-restore-alaFmk/software/m20_300/v31/m20_v31.memh
INFO: [Vivado_Tcl 97-130] Option flatten_hierarchy used for synth_design is: none
Starting synth_design
Attempting to get a license for feature 'Synthesis' and/or device 'xc7k325t'
INFO: [Common 17-349] Got license for feature 'Synthesis' and/or device 'xc7k325t'
INFO: [Synth 8-7079] Multithreading enabled for synth_design using a maximum of 7 processes.
INFO: [Synth 8-7078] Launching helper process for spawning children vivado processes
INFO: [Synth 8-7075] Helper process launched with PID 442572
---------------------------------------------------------------------------------
Starting Synthesize : Time (s): cpu = 00:00:03 ; elapsed = 00:00:03 . Memory (MB): peak = 2244.773 ; gain = 502.555 ; free physical = 49822 ; free virtual = 64054
---------------------------------------------------------------------------------
INFO: [Synth 8-6157] synthesizing module 'swcell_m20_v31_top' [/tmp/swcell-v31-restore-alaFmk/fpga/projects/m20/autonomous/rtl/swcell_m20_v31_top.sv:3]
	Parameter ROM_FILE bound to: /tmp/swcell-v31-restore-alaFmk/software/m20_300/v31/m20_v31.memh - type: string 
INFO: [Synth 8-6157] synthesizing module 'swc_power_on_reset' [/tmp/swcell-v31-restore-alaFmk/rtl/common/swc_power_on_reset.sv:4]
	Parameter HOLD_CYCLES bound to: 5000000 - type: integer 
INFO: [Synth 8-6155] done synthesizing module 'swc_power_on_reset' (0#1) [/tmp/swcell-v31-restore-alaFmk/rtl/common/swc_power_on_reset.sv:4]
INFO: [Synth 8-6157] synthesizing module 'swc_m20_v31_gpio' [/tmp/swcell-v31-restore-alaFmk/rtl/modules/m20/v31/swc_m20_v31_gpio.sv:3]
INFO: [Synth 8-6157] synthesizing module 'swc_input_sync' [/tmp/swcell-v31-restore-alaFmk/rtl/common/swc_input_sync.sv:2]
	Parameter WIDTH bound to: 6 - type: integer 
	Parameter STAGES bound to: 2 - type: integer 
INFO: [Synth 8-6155] done synthesizing module 'swc_input_sync' (0#1) [/tmp/swcell-v31-restore-alaFmk/rtl/common/swc_input_sync.sv:2]
INFO: [Synth 8-6155] done synthesizing module 'swc_m20_v31_gpio' (0#1) [/tmp/swcell-v31-restore-alaFmk/rtl/modules/m20/v31/swc_m20_v31_gpio.sv:3]
INFO: [Synth 8-6157] synthesizing module 'swc_input_sync__parameterized0' [/tmp/swcell-v31-restore-alaFmk/rtl/common/swc_input_sync.sv:2]
	Parameter WIDTH bound to: 1 - type: integer 
INFO: [Synth 8-6155] done synthesizing module 'swc_input_sync__parameterized0' (0#1) [/tmp/swcell-v31-restore-alaFmk/rtl/common/swc_input_sync.sv:2]
INFO: [Synth 8-6157] synthesizing module 'swc_debounce' [/tmp/swcell-v31-restore-alaFmk/rtl/common/swc_debounce.sv:3]
	Parameter WIDTH bound to: 1 - type: integer 
	Parameter STABLE_CYCLES bound to: 1000000 - type: integer 
INFO: [Synth 8-6157] synthesizing module 'swc_input_sync__parameterized1' [/tmp/swcell-v31-restore-alaFmk/rtl/common/swc_input_sync.sv:2]
	Parameter WIDTH bound to: 1 - type: integer 
	Parameter STAGES bound to: 2 - type: integer 
INFO: [Synth 8-6155] done synthesizing module 'swc_input_sync__parameterized1' (0#1) [/tmp/swcell-v31-restore-alaFmk/rtl/common/swc_input_sync.sv:2]
INFO: [Synth 8-6155] done synthesizing module 'swc_debounce' (0#1) [/tmp/swcell-v31-restore-alaFmk/rtl/common/swc_debounce.sv:3]
INFO: [Synth 8-6157] synthesizing module 'swc_uart_rx' [/tmp/swcell-v31-restore-alaFmk/rtl/common/swc_uart_rx.sv:3]
	Parameter CLK_HZ bound to: 50000000 - type: integer 
	Parameter BAUD bound to: 115200 - type: integer 
INFO: [Synth 8-6155] done synthesizing module 'swc_uart_rx' (0#1) [/tmp/swcell-v31-restore-alaFmk/rtl/common/swc_uart_rx.sv:3]
INFO: [Synth 8-6157] synthesizing module 'swc_m20_v31_service' [/tmp/swcell-v31-restore-alaFmk/rtl/modules/m20/v31/swc_m20_v31_service.sv:3]
	Parameter ROM_FILE bound to: /tmp/swcell-v31-restore-alaFmk/software/m20_300/v31/m20_v31.memh - type: string 
INFO: [Synth 8-6157] synthesizing module 'swc_m20_v31_memory' [/tmp/swcell-v31-restore-alaFmk/rtl/modules/m20/v31/swc_m20_v31_memory.sv:3]
	Parameter ROM_FILE bound to: /tmp/swcell-v31-restore-alaFmk/software/m20_300/v31/m20_v31.memh - type: string 
INFO: [Synth 8-3876] $readmem data file '/tmp/swcell-v31-restore-alaFmk/software/m20_300/v31/m20_v31.memh' is read successfully [/tmp/swcell-v31-restore-alaFmk/rtl/modules/m20/v31/swc_m20_v31_memory.sv:16]
INFO: [Synth 8-6155] done synthesizing module 'swc_m20_v31_memory' (0#1) [/tmp/swcell-v31-restore-alaFmk/rtl/modules/m20/v31/swc_m20_v31_memory.sv:3]
INFO: [Synth 8-6157] synthesizing module 'm20v3_cpu_core' [/tmp/swcell-v31-restore-alaFmk/rtl/modules/m20/v3/generated/m20v3_cpu_core.sv:3]
	Parameter STORAGE_MODE bound to: FUNCTIONAL_STORAGE - type: string 
INFO: [Synth 8-6157] synthesizing module 'swc_v3_mux157' [/tmp/swcell-v31-restore-alaFmk/rtl/modules/m20/v3/swc_v3_mux157.sv:3]
INFO: [Synth 8-6157] synthesizing module 'LUT3' [/home/boksop/AMDDesignTools/2026.1.1/Vivado/scripts/rt/data/unisim_comp.v:95299]
	Parameter INIT bound to: 8'b11001010 
INFO: [Synth 8-6155] done synthesizing module 'LUT3' (0#1) [/home/boksop/AMDDesignTools/2026.1.1/Vivado/scripts/rt/data/unisim_comp.v:95299]
INFO: [Synth 8-6155] done synthesizing module 'swc_v3_mux157' (0#1) [/tmp/swcell-v31-restore-alaFmk/rtl/modules/m20/v3/swc_v3_mux157.sv:3]
INFO: [Synth 8-6155] done synthesizing module 'm20v3_cpu_core' (0#1) [/tmp/swcell-v31-restore-alaFmk/rtl/modules/m20/v3/generated/m20v3_cpu_core.sv:3]
WARNING: [Synth 8-7071] port 'debug_legal' of module 'm20v3_cpu_core' is unconnected for instance 'cpu' [/tmp/swcell-v31-restore-alaFmk/rtl/modules/m20/v31/swc_m20_v31_service.sv:33]
WARNING: [Synth 8-7071] port 'retire_pc' of module 'm20v3_cpu_core' is unconnected for instance 'cpu' [/tmp/swcell-v31-restore-alaFmk/rtl/modules/m20/v31/swc_m20_v31_service.sv:33]
WARNING: [Synth 8-7071] port 'retire_instruction' of module 'm20v3_cpu_core' is unconnected for instance 'cpu' [/tmp/swcell-v31-restore-alaFmk/rtl/modules/m20/v31/swc_m20_v31_service.sv:33]
WARNING: [Synth 8-7071] port 'retire_next_pc' of module 'm20v3_cpu_core' is unconnected for instance 'cpu' [/tmp/swcell-v31-restore-alaFmk/rtl/modules/m20/v31/swc_m20_v31_service.sv:33]
WARNING: [Synth 8-7071] port 'retire_ar' of module 'm20v3_cpu_core' is unconnected for instance 'cpu' [/tmp/swcell-v31-restore-alaFmk/rtl/modules/m20/v31/swc_m20_v31_service.sv:33]
WARNING: [Synth 8-7071] port 'retire_a' of module 'm20v3_cpu_core' is unconnected for instance 'cpu' [/tmp/swcell-v31-restore-alaFmk/rtl/modules/m20/v31/swc_m20_v31_service.sv:33]
WARNING: [Synth 8-7071] port 'retire_z' of module 'm20v3_cpu_core' is unconnected for instance 'cpu' [/tmp/swcell-v31-restore-alaFmk/rtl/modules/m20/v31/swc_m20_v31_service.sv:33]
WARNING: [Synth 8-7071] port 'retire_c' of module 'm20v3_cpu_core' is unconnected for instance 'cpu' [/tmp/swcell-v31-restore-alaFmk/rtl/modules/m20/v31/swc_m20_v31_service.sv:33]
WARNING: [Synth 8-7071] port 'retire_gpo' of module 'm20v3_cpu_core' is unconnected for instance 'cpu' [/tmp/swcell-v31-restore-alaFmk/rtl/modules/m20/v31/swc_m20_v31_service.sv:33]
WARNING: [Synth 8-7071] port 'debug_next_state' of module 'm20v3_cpu_core' is unconnected for instance 'cpu' [/tmp/swcell-v31-restore-alaFmk/rtl/modules/m20/v31/swc_m20_v31_service.sv:33]
WARNING: [Synth 8-7071] port 'retire_is_memory' of module 'm20v3_cpu_core' is unconnected for instance 'cpu' [/tmp/swcell-v31-restore-alaFmk/rtl/modules/m20/v31/swc_m20_v31_service.sv:33]
WARNING: [Synth 8-7071] port 'retire_ram_valid' of module 'm20v3_cpu_core' is unconnected for instance 'cpu' [/tmp/swcell-v31-restore-alaFmk/rtl/modules/m20/v31/swc_m20_v31_service.sv:33]
WARNING: [Synth 8-7071] port 'retire_ram_write' of module 'm20v3_cpu_core' is unconnected for instance 'cpu' [/tmp/swcell-v31-restore-alaFmk/rtl/modules/m20/v31/swc_m20_v31_service.sv:33]
WARNING: [Synth 8-7071] port 'retire_ram_addr' of module 'm20v3_cpu_core' is unconnected for instance 'cpu' [/tmp/swcell-v31-restore-alaFmk/rtl/modules/m20/v31/swc_m20_v31_service.sv:33]
WARNING: [Synth 8-7071] port 'retire_ram_wdata' of module 'm20v3_cpu_core' is unconnected for instance 'cpu' [/tmp/swcell-v31-restore-alaFmk/rtl/modules/m20/v31/swc_m20_v31_service.sv:33]
WARNING: [Synth 8-7071] port 'retire_ram_rdata' of module 'm20v3_cpu_core' is unconnected for instance 'cpu' [/tmp/swcell-v31-restore-alaFmk/rtl/modules/m20/v31/swc_m20_v31_service.sv:33]
WARNING: [Synth 8-7023] instance 'cpu' of module 'm20v3_cpu_core' has 44 connections declared, but only 28 given [/tmp/swcell-v31-restore-alaFmk/rtl/modules/m20/v31/swc_m20_v31_service.sv:33]
INFO: [Synth 8-6155] done synthesizing module 'swc_m20_v31_service' (0#1) [/tmp/swcell-v31-restore-alaFmk/rtl/modules/m20/v31/swc_m20_v31_service.sv:3]
INFO: [Synth 8-6157] synthesizing module 'swc_uart_hex_json' [/tmp/swcell-v31-restore-alaFmk/rtl/common/swc_uart_hex_json.sv:4]
	Parameter CLK_HZ bound to: 50000000 - type: integer 
	Parameter BAUD bound to: 115200 - type: integer 
	Parameter HEX_DIGITS bound to: 92 - type: integer 
	Parameter FORMAT bound to: {"type":"M20_V31_STATE","build":"M20V31A01","pc":"###","ar":"##","a":"#","gpo":"#","ustate":"#","keys":"##","flags":"##","micro":"################","retired":"################","reads":"################","writes":"################","errors":"################"}
 - type: string 
INFO: [Synth 8-6157] synthesizing module 'swc_uart_tx' [/tmp/swcell-v31-restore-alaFmk/rtl/common/swc_uart_tx.sv:3]
	Parameter CLK_HZ bound to: 50000000 - type: integer 
	Parameter BAUD bound to: 115200 - type: integer 
INFO: [Synth 8-6155] done synthesizing module 'swc_uart_tx' (0#1) [/tmp/swcell-v31-restore-alaFmk/rtl/common/swc_uart_tx.sv:3]
INFO: [Synth 8-6155] done synthesizing module 'swc_uart_hex_json' (0#1) [/tmp/swcell-v31-restore-alaFmk/rtl/common/swc_uart_hex_json.sv:4]
INFO: [Synth 8-6155] done synthesizing module 'swcell_m20_v31_top' (0#1) [/tmp/swcell-v31-restore-alaFmk/fpga/projects/m20/autonomous/rtl/swcell_m20_v31_top.sv:3]
WARNING: [Synth 8-7129] Port master_hold in module m20v3_cpu_core is either unconnected or has no load
WARNING: [Synth 8-7129] Port slave_open in module m20v3_cpu_core is either unconnected or has no load
WARNING: [Synth 8-7129] Port KEY4 in module swcell_m20_v31_top is either unconnected or has no load
---------------------------------------------------------------------------------
Finished Synthesize : Time (s): cpu = 00:00:05 ; elapsed = 00:00:05 . Memory (MB): peak = 2342.711 ; gain = 600.492 ; free physical = 49700 ; free virtual = 63925
---------------------------------------------------------------------------------
---------------------------------------------------------------------------------
Finished Constraint Validation : Time (s): cpu = 00:00:05 ; elapsed = 00:00:05 . Memory (MB): peak = 2357.555 ; gain = 615.336 ; free physical = 49691 ; free virtual = 63913
---------------------------------------------------------------------------------
---------------------------------------------------------------------------------
Start Loading Part and Timing Information
---------------------------------------------------------------------------------
Loading part: xc7k325tffg900-2
INFO: [Device 21-403] Loading part xc7k325tffg900-2
---------------------------------------------------------------------------------
Finished Loading Part and Timing Information : Time (s): cpu = 00:00:05 ; elapsed = 00:00:05 . Memory (MB): peak = 2357.555 ; gain = 615.336 ; free physical = 49683 ; free virtual = 63905
---------------------------------------------------------------------------------
---------------------------------------------------------------------------------
Finished RTL Optimization Phase 2 : Time (s): cpu = 00:00:06 ; elapsed = 00:00:06 . Memory (MB): peak = 2396.422 ; gain = 654.203 ; free physical = 49645 ; free virtual = 63866
---------------------------------------------------------------------------------
No constraint files found.
---------------------------------------------------------------------------------
Start RTL Component Statistics 
---------------------------------------------------------------------------------
Detailed RTL Component Info : 
+---Adders : 
	   2 Input   32 Bit       Adders := 3     
	   2 Input   16 Bit       Adders := 3     
	   2 Input    9 Bit       Adders := 2     
	   2 Input    7 Bit       Adders := 1     
	   2 Input    4 Bit       Adders := 4     
	   2 Input    2 Bit       Adders := 1     
+---Registers : 
	              368 Bit    Registers := 1     
	               32 Bit    Registers := 1     
	               16 Bit    Registers := 5     
	               12 Bit    Registers := 3     
	               10 Bit    Registers := 1     
	                9 Bit    Registers := 1     
	                8 Bit    Registers := 3     
	                6 Bit    Registers := 2     
	                4 Bit    Registers := 6     
	                3 Bit    Registers := 3     
	                2 Bit    Registers := 2     
	                1 Bit    Registers := 29    
+---RAMs : 
	             1024 Bit	(256 X 4 bit)          RAMs := 1     
+---ROMs : 
	                    ROMs := 1     
+---Muxes : 
	   3 Input   32 Bit        Muxes := 1     
	   2 Input   16 Bit        Muxes := 3     
	   2 Input   10 Bit        Muxes := 1     
	   2 Input    9 Bit        Muxes := 1     
	   2 Input    8 Bit        Muxes := 4     
	   2 Input    7 Bit        Muxes := 1     
	   2 Input    4 Bit        Muxes := 5     
	   2 Input    2 Bit        Muxes := 1     
	   2 Input    1 Bit        Muxes := 47    
---------------------------------------------------------------------------------
Finished RTL Component Statistics 
---------------------------------------------------------------------------------
---------------------------------------------------------------------------------
Start Part Resource Summary
---------------------------------------------------------------------------------
Part Resources:
DSPs: 840 (col length:140)
BRAMs: 890 (col length: RAMB18 140 RAMB36 70)
---------------------------------------------------------------------------------
Finished Part Resource Summary
---------------------------------------------------------------------------------
No constraint files found.
---------------------------------------------------------------------------------
Start Cross Boundary and Area Optimization
---------------------------------------------------------------------------------
WARNING: [Synth 8-7129] Port master_hold in module m20v3_cpu_core is either unconnected or has no load
WARNING: [Synth 8-7129] Port slave_open in module m20v3_cpu_core is either unconnected or has no load
WARNING: [Synth 8-7129] Port KEY4 in module swcell_m20_v31_top is either unconnected or has no load
---------------------------------------------------------------------------------
Finished Cross Boundary and Area Optimization : Time (s): cpu = 00:00:13 ; elapsed = 00:00:13 . Memory (MB): peak = 2603.555 ; gain = 861.336 ; free physical = 49323 ; free virtual = 63565
---------------------------------------------------------------------------------
---------------------------------------------------------------------------------
Start ROM, RAM, DSP, Shift Register and Retiming Reporting
---------------------------------------------------------------------------------

Block RAM: Preliminary Mapping Report (see note below)
+---------------+------------+------------------------+---+---+------------------------+---+---+------------------+--------+--------+
|Module Name    | RTL Object | PORT A (Depth x Width) | W | R | PORT B (Depth x Width) | W | R | Ports driving FF | RAMB18 | RAMB36 | 
+---------------+------------+------------------------+---+---+------------------------+---+---+------------------+--------+--------+
|service/memory | memory_reg | 256 x 4(READ_FIRST)    | W |   | 256 x 4(WRITE_FIRST)   |   | R | Port A and B     | 1      | 0      | 
+---------------+------------+------------------------+---+---+------------------------+---+---+------------------+--------+--------+

Note: The table above is a preliminary report that shows the Block RAMs at the current stage of the synthesis flow. Some Block RAMs may be reimplemented as non Block RAM primitives later in the synthesis flow. Multiple instantiated Block RAMs are reported only once. 
---------------------------------------------------------------------------------
Finished ROM, RAM, DSP, Shift Register and Retiming Reporting
---------------------------------------------------------------------------------
No constraint files found.
---------------------------------------------------------------------------------
Start Timing Optimization
---------------------------------------------------------------------------------
---------------------------------------------------------------------------------
Finished Timing Optimization : Time (s): cpu = 00:00:13 ; elapsed = 00:00:13 . Memory (MB): peak = 2603.555 ; gain = 861.336 ; free physical = 49318 ; free virtual = 63560
---------------------------------------------------------------------------------
---------------------------------------------------------------------------------
Start ROM, RAM, DSP, Shift Register and Retiming Reporting
---------------------------------------------------------------------------------

Block RAM: Final Mapping Report
+---------------+------------+------------------------+---+---+------------------------+---+---+------------------+--------+--------+
|Module Name    | RTL Object | PORT A (Depth x Width) | W | R | PORT B (Depth x Width) | W | R | Ports driving FF | RAMB18 | RAMB36 | 
+---------------+------------+------------------------+---+---+------------------------+---+---+------------------+--------+--------+
|service/memory | memory_reg | 256 x 4(READ_FIRST)    | W |   | 256 x 4(WRITE_FIRST)   |   | R | Port A and B     | 1      | 0      | 
+---------------+------------+------------------------+---+---+------------------------+---+---+------------------+--------+--------+

---------------------------------------------------------------------------------
Finished ROM, RAM, DSP, Shift Register and Retiming Reporting
---------------------------------------------------------------------------------
---------------------------------------------------------------------------------
Start Technology Mapping
---------------------------------------------------------------------------------
INFO: [Synth 8-7052] The timing for the instance service/memory/memory_reg (implemented as a Block RAM) might be sub-optimal as no optional output register could be merged into the ram block. Providing additional output register may help in improving timing.
---------------------------------------------------------------------------------
Finished Technology Mapping : Time (s): cpu = 00:00:14 ; elapsed = 00:00:14 . Memory (MB): peak = 2603.555 ; gain = 861.336 ; free physical = 49329 ; free virtual = 63571
---------------------------------------------------------------------------------
---------------------------------------------------------------------------------
Start IO Insertion
---------------------------------------------------------------------------------
---------------------------------------------------------------------------------
Start Final Netlist Cleanup
---------------------------------------------------------------------------------
---------------------------------------------------------------------------------
Finished Final Netlist Cleanup
---------------------------------------------------------------------------------
---------------------------------------------------------------------------------
Finished IO Insertion : Time (s): cpu = 00:00:16 ; elapsed = 00:00:16 . Memory (MB): peak = 2747.367 ; gain = 1005.148 ; free physical = 49230 ; free virtual = 63470
---------------------------------------------------------------------------------
---------------------------------------------------------------------------------
Start Renaming Generated Instances
---------------------------------------------------------------------------------
---------------------------------------------------------------------------------
Finished Renaming Generated Instances : Time (s): cpu = 00:00:16 ; elapsed = 00:00:16 . Memory (MB): peak = 2747.367 ; gain = 1005.148 ; free physical = 49230 ; free virtual = 63470
---------------------------------------------------------------------------------
---------------------------------------------------------------------------------
Start Handling Custom Attributes
---------------------------------------------------------------------------------
---------------------------------------------------------------------------------
Finished Handling Custom Attributes : Time (s): cpu = 00:00:16 ; elapsed = 00:00:16 . Memory (MB): peak = 2747.367 ; gain = 1005.148 ; free physical = 49229 ; free virtual = 63468
---------------------------------------------------------------------------------
---------------------------------------------------------------------------------
Start Writing Synthesis Report
---------------------------------------------------------------------------------

Report BlackBoxes: 
+-+--------------+----------+
| |BlackBox name |Instances |
+-+--------------+----------+
+-+--------------+----------+

Report Cell Usage: 
+------+---------+------+
|      |Cell     |Count |
+------+---------+------+
|1     |BUFG     |     1|
|2     |CARRY4   |   129|
|3     |LUT1     |    84|
|4     |LUT2     |    52|
|5     |LUT3     |   526|
|6     |LUT4     |    72|
|7     |LUT5     |    49|
|8     |LUT6     |   245|
|9     |MUXF7    |    48|
|10    |MUXF8    |    12|
|11    |RAMB18E1 |     1|
|12    |RAMB36E1 |     2|
|13    |FDRE     |   975|
|14    |FDSE     |     7|
|15    |IBUF     |    10|
|16    |OBUF     |    14|
+------+---------+------+

Report Instance Areas: 
+------+--------------------------+----------------------------------+------+
|      |Instance                  |Module                            |Cells |
+------+--------------------------+----------------------------------+------+
|1     |top                       |                                  |  2227|
|2     |  por                     |swc_power_on_reset                |    41|
|3     |  gpio                    |swc_m20_v31_gpio                  |    18|
|4     |    sync_keys             |swc_input_sync                    |    12|
|5     |  reset_sync              |swc_input_sync__parameterized0__1 |     2|
|6     |  debug_key               |swc_debounce                      |    39|
|7     |    sync_inputs           |swc_input_sync__parameterized1    |     2|
|8     |  rx_sync                 |swc_input_sync__parameterized0    |     2|
|9     |  receiver                |swc_uart_rx                       |   100|
|10    |  service                 |swc_m20_v31_service               |  1054|
|11    |    memory                |swc_m20_v31_memory                |    26|
|12    |    cpu                   |m20v3_cpu_core                    |   510|
|13    |      \g_decode.u_n0000   |swc_v3_mux157__1                  |     1|
|14    |      \g_decode.u_n0001   |swc_v3_mux157__2                  |     1|
|15    |      \g_decode.u_n0003   |swc_v3_mux157__3                  |     1|
|16    |      \g_decode.u_n0004   |swc_v3_mux157__4                  |     1|
|17    |      \g_decode.u_n0005   |swc_v3_mux157__5                  |     1|
|18    |      \g_decode.u_n0007   |swc_v3_mux157__6                  |     1|
|19    |      \g_decode.u_n0009   |swc_v3_mux157__7                  |     1|
|20    |      \g_decode.u_n0010   |swc_v3_mux157__8                  |     1|
|21    |      \g_decode.u_n0011   |swc_v3_mux157__9                  |     1|
|22    |      \g_decode.u_n0012   |swc_v3_mux157__10                 |     1|
|23    |      \g_decode.u_n0013   |swc_v3_mux157__11                 |     1|
|24    |      \g_decode.u_n0014   |swc_v3_mux157__12                 |     1|
|25    |      \g_decode.u_n0015   |swc_v3_mux157__13                 |     1|
|26    |      \g_decode.u_n0016   |swc_v3_mux157__14                 |     1|
|27    |      \g_decode.u_n0018   |swc_v3_mux157__15                 |     1|
|28    |      \g_decode.u_n0019   |swc_v3_mux157__16                 |     1|
|29    |      \g_decode.u_n0020   |swc_v3_mux157__17                 |     1|
|30    |      \g_decode.u_n0021   |swc_v3_mux157__18                 |     1|
|31    |      \g_decode.u_n0022   |swc_v3_mux157__19                 |     1|
|32    |      \g_decode.u_n0024   |swc_v3_mux157__20                 |     1|
|33    |      \g_decode.u_n0025   |swc_v3_mux157__21                 |     1|
|34    |      \g_decode.u_n0026   |swc_v3_mux157__22                 |     1|
|35    |      \g_decode.u_n0027   |swc_v3_mux157__23                 |     1|
|36    |      \g_decode.u_n0028   |swc_v3_mux157__24                 |     1|
|37    |      \g_decode.u_n0030   |swc_v3_mux157__25                 |     1|
|38    |      \g_decode.u_n0031   |swc_v3_mux157__26                 |     1|
|39    |      \g_decode.u_n0032   |swc_v3_mux157__27                 |     1|
|40    |      \g_decode.u_n0033   |swc_v3_mux157__28                 |     1|
|41    |      \g_decode.u_n0034   |swc_v3_mux157__29                 |     1|
|42    |      \g_decode.u_n0035   |swc_v3_mux157__30                 |     1|
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
|477   |      \g_bus.u_n0588      |swc_v3_mux157__465                |     1|
|478   |      \g_bus.u_n0589      |swc_v3_mux157__466                |     1|
|479   |      \g_bus.u_n0590      |swc_v3_mux157__467                |     1|
|480   |      \g_bus.u_n0591      |swc_v3_mux157__468                |     1|
|481   |      \g_bus.u_n0592      |swc_v3_mux157__469                |     1|
|482   |      \g_bus.u_n0593      |swc_v3_mux157__470                |     1|
|483   |      \g_bus.u_n0595      |swc_v3_mux157__471                |     1|
|484   |      \g_bus.u_n0596      |swc_v3_mux157__472                |     1|
|485   |      \g_bus.u_n0597      |swc_v3_mux157__473                |     1|
|486   |      \g_bus.u_n0599      |swc_v3_mux157__474                |     1|
|487   |      \g_bus.u_n0600      |swc_v3_mux157__475                |     1|
|488   |      \g_bus.u_n0601      |swc_v3_mux157__476                |     1|
|489   |      \g_bus.u_n0602      |swc_v3_mux157                     |     1|
|490   |  reporter                |swc_uart_hex_json                 |   742|
|491   |    uart                  |swc_uart_tx                       |    49|
+------+--------------------------+----------------------------------+------+
---------------------------------------------------------------------------------
Finished Writing Synthesis Report : Time (s): cpu = 00:00:16 ; elapsed = 00:00:16 . Memory (MB): peak = 2747.367 ; gain = 1005.148 ; free physical = 49228 ; free virtual = 63468
---------------------------------------------------------------------------------
Synthesis finished with 0 errors, 0 critical warnings and 23 warnings.
Synthesis Optimization Runtime : Time (s): cpu = 00:00:16 ; elapsed = 00:00:16 . Memory (MB): peak = 2747.367 ; gain = 1005.148 ; free physical = 49228 ; free virtual = 63468
Synthesis Optimization Complete : Time (s): cpu = 00:00:16 ; elapsed = 00:00:16 . Memory (MB): peak = 2750.336 ; gain = 1005.148 ; free physical = 49228 ; free virtual = 63468
INFO: [Project 1-571] Translating synthesized netlist
Netlist sorting complete. Time (s): cpu = 00:00:00.01 ; elapsed = 00:00:00.01 . Memory (MB): peak = 2764.211 ; gain = 0.000 ; free physical = 49374 ; free virtual = 63614
INFO: [Netlist 29-17] Analyzing 192 Unisim elements for replacement
INFO: [Netlist 29-28] Unisim Transformation completed in 0 CPU seconds
INFO: [Project 1-570] Preparing netlist for logic optimization
INFO: [Opt 31-138] Pushed 0 inverter(s) to 0 load pin(s).
Netlist sorting complete. Time (s): cpu = 00:00:00 ; elapsed = 00:00:00 . Memory (MB): peak = 2908.793 ; gain = 0.000 ; free physical = 49371 ; free virtual = 63611
INFO: [Project 1-111] Unisim Transformation Summary:
No Unisim elements were transformed.

Synth Design complete | Checksum: b61e3204
INFO: [Common 17-83] Releasing license: Synthesis
45 Infos, 23 Warnings, 0 Critical Warnings and 0 Errors encountered.
synth_design completed successfully
synth_design: Time (s): cpu = 00:00:21 ; elapsed = 00:00:19 . Memory (MB): peak = 2911.762 ; gain = 1169.543 ; free physical = 49371 ; free virtual = 63611
INFO: [Common 17-2834] synth_design peak Physical Memory [PSS] (MB): overall = 2023.165; main = 2023.165; forked = 286.592
INFO: [Common 17-2834] synth_design peak Virtual Memory [VSS] (MB): overall = 3632.875; main = 2911.766; forked = 1078.371
Parsing XDC File [/tmp/swcell-v31-restore-alaFmk/fpga/projects/diagnostics/oled_keys/constraints/io.xdc]
Finished Parsing XDC File [/tmp/swcell-v31-restore-alaFmk/fpga/projects/diagnostics/oled_keys/constraints/io.xdc]
INFO: [Timing 38-35] Done setting XDC timing constraints.
INFO: [Timing 38-91] UpdateTimingParams: Speed grade: -2, Delay Type: min_max.
INFO: [Timing 38-191] Multithreading enabled for timing update using a maximum of 8 CPUs
Command: report_drc -checks LUTLP-1 -file /tmp/swcell-v31-restore-alaFmk/build/fpga/m20/autonomous/release_synth/feedback_drc.rpt
INFO: [DRC 23-27] Running DRC with 8 threads
INFO: [Vivado_Tcl 2-168] The results of DRC are in file /tmp/swcell-v31-restore-alaFmk/build/fpga/m20/autonomous/release_synth/feedback_drc.rpt.
report_drc completed successfully
M20_V31_SYNTH_COMPLETE mode=FUNCTIONAL_STORAGE muxes=477
# exit 0
INFO: [Common 17-206] Exiting Vivado at Thu Nov  5 13:04:25 2026...
