boksop/swcell/docs/evidence/m20_v31/hardware/20261105_first_download_r1/states.csv

type | build | pc | ar | a | gpo | ustate | keys | flags | micro | retired | reads | writes | errors | c | z | trapped | halted | cpu_reset | run | active
M20_V31_STATE | M20V31A01 | 0 | 0 | 0 | 8 | 0 | 0 | 98 | 0 | 0 | 0 | 0 | 0 | False | True | False | False | False | True | True
M20_V31_STATE | M20V31A01 | 1469 | 0 | 6 | 6 | 2 | 0 | 96 | 980003 | 321843 | 208617 | 42566 | 0 | False | False | False | False | False | True | True
M20_V31_STATE | M20V31A01 | 2031 | 0 | 13 | 12 | 3 | 0 | 96 | 1980003 | 641013 | 412287 | 95229 | 0 | False | False | False | False | False | True | True
M20_V31_STATE | M20V31A01 | 2031 | 0 | 3 | 12 | 5 | 0 | 96 | 2980003 | 949852 | 605402 | 158298 | 0 | False | False | False | False | False | True | True
M20_V31_STATE | M20V31A01 | 2031 | 0 | 10 | 12 | 5 | 0 | 96 | 3980003 | 1258692 | 798515 | 221367 | 0 | False | False | False | False | False | True | True
M20_V31_STATE | M20V31A01 | 2032 | 0 | 0 | 12 | 2 | 0 | 98 | 4980003 | 1567532 | 991629 | 284436 | 0 | False | True | False | False | False | True | True
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
