boksop/swcell/docs/evidence/m20_v31/hardware/20261105_restart_plus_r2/states.csv

type | build | pc | ar | a | gpo | ustate | keys | flags | micro | retired | reads | writes | errors | c | z | trapped | halted | cpu_reset | run | active
M20_V31_STATE | M20V31A01 | 2064 | 0 | 2 | 12 | 1 | 0 | 96 | 33980003 | 10523981 | 6591768 | 2113424 | 0 | False | False | False | False | False | True | True
M20_V31_STATE | M20V31A01 | 2061 | 0 | 10 | 12 | 2 | 0 | 96 | 34980003 | 10832831 | 6784863 | 2176492 | 0 | False | False | False | False | False | True | True
M20_V31_STATE | M20V31A01 | 2062 | 0 | 1 | 12 | 2 | 0 | 96 | 35980003 | 11141671 | 6977976 | 2239561 | 0 | False | False | False | False | False | True | True
M20_V31_STATE | M20V31A01 | 2062 | 0 | 8 | 12 | 2 | 0 | 96 | 36980003 | 11450511 | 7171089 | 2302630 | 0 | False | False | False | False | False | True | True
M20_V31_STATE | M20V31A01 | 2062 | 0 | 15 | 12 | 2 | 0 | 96 | 37980003 | 11759351 | 7364202 | 2365699 | 0 | False | False | False | False | False | True | True
M20_V31_STATE | M20V31A01 | 2060 | 0 | 6 | 12 | 3 | 0 | 96 | 38980003 | 12068201 | 7557294 | 2428768 | 0 | False | False | False | False | False | True | True
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
