boksop/swcell/docs/evidence/m20_v3/hardware/20261104_174721_functional_first/states.csv

game | frame_game | frame_valid | frame_ticks | micro | retired | reads | writes | ticks | errors | pc | ar | a | z | c | gpo | ustate | rom_word | ram_addr | ram_wdata | ram_rdata | ram_ce | ram_oe | ram_we | keys | run | halted | trapped | cycle_ticks | phase_trace | oled_frames
0 | 0 | 1 | 5 | 1110 | 352 | 219 | 62 | 5 | 0 | 141 | 5 | 13 | 0 | 0 | 8 | 1 | 61440 | 0 | 13 | 12 | 0 | 0 | 0 | 0 | 1 | 0 | 0 | 50 | 184 | 0
0 | 0 | 1 | 35 | 7198 | 2337 | 1494 | 343 | 35 | 0 | 141 | 5 | 2 | 0 | 0 | 8 | 1 | 61440 | 0 | 2 | 0 | 0 | 0 | 0 | 0 | 1 | 0 | 0 | 50 | 184 | 59
0 | 0 | 1 | 65 | 13249 | 4311 | 2757 | 623 | 65 | 0 | 141 | 5 | 12 | 0 | 1 | 8 | 1 | 61440 | 0 | 12 | 13 | 0 | 0 | 0 | 0 | 1 | 0 | 0 | 50 | 184 | 118
0 | 0 | 1 | 95 | 19314 | 6289 | 4020 | 905 | 95 | 0 | 141 | 5 | 10 | 0 | 1 | 8 | 1 | 61440 | 0 | 10 | 11 | 0 | 0 | 0 | 0 | 1 | 0 | 0 | 50 | 184 | 177
0 | 0 | 1 | 125 | 25379 | 8267 | 5289 | 1185 | 125 | 0 | 141 | 5 | 8 | 0 | 1 | 8 | 1 | 61440 | 0 | 8 | 9 | 0 | 0 | 0 | 0 | 1 | 0 | 0 | 50 | 184 | 236
0 | 0 | 1 | 155 | 31444 | 10245 | 6558 | 1465 | 155 | 0 | 141 | 5 | 6 | 0 | 1 | 8 | 1 | 61440 | 0 | 6 | 7 | 0 | 0 | 0 | 0 | 1 | 0 | 0 | 50 | 184 | 294
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
