boksop/swcell/docs/evidence/m20_v3/hardware/20261104_180407_isa_diagnostic/states.csv

game | frame_game | frame_valid | frame_ticks | micro | retired | reads | writes | ticks | errors | pc | ar | a | z | c | gpo | ustate | rom_word | ram_addr | ram_wdata | ram_rdata | ram_ce | ram_oe | ram_we | keys | run | halted | trapped | cycle_ticks | phase_trace | oled_frames
0 | 0 | 1 | 29915 | 6054669 | 1974409 | 1266045 | 279935 | 29915 | 0 | 141 | 5 | 10 | 0 | 1 | 8 | 1 | 61440 | 0 | 10 | 11 | 0 | 0 | 0 | 0 | 1 | 0 | 0 | 50 | 184 | 58628
0 | 0 | 1 | 29945 | 6060734 | 1976387 | 1267314 | 280215 | 29945 | 0 | 141 | 5 | 8 | 0 | 1 | 8 | 1 | 61440 | 0 | 8 | 9 | 0 | 0 | 0 | 0 | 1 | 0 | 0 | 50 | 184 | 58687
0 | 0 | 1 | 29975 | 6066799 | 1978365 | 1268583 | 280495 | 29975 | 0 | 141 | 5 | 6 | 0 | 1 | 8 | 1 | 61440 | 0 | 6 | 7 | 0 | 0 | 0 | 0 | 1 | 0 | 0 | 50 | 184 | 58746
0 | 0 | 1 | 30005 | 6072864 | 1980343 | 1269852 | 280775 | 30005 | 0 | 141 | 5 | 4 | 0 | 1 | 8 | 1 | 61440 | 0 | 4 | 5 | 0 | 0 | 0 | 0 | 1 | 0 | 0 | 50 | 184 | 58804
0 | 0 | 1 | 30035 | 6078929 | 1982321 | 1271115 | 281057 | 30035 | 0 | 141 | 5 | 2 | 0 | 1 | 8 | 1 | 61440 | 0 | 2 | 3 | 0 | 0 | 0 | 0 | 1 | 0 | 0 | 50 | 184 | 58863
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
