boksop/swcell/docs/evidence/m20_v3/hardware/20261104_180622_trap_diagnostic/states.csv

game | frame_game | frame_valid | frame_ticks | micro | retired | reads | writes | ticks | errors | pc | ar | a | z | c | gpo | ustate | rom_word | ram_addr | ram_wdata | ram_rdata | ram_ce | ram_oe | ram_we | keys | run | halted | trapped | cycle_ticks | phase_trace | oled_frames
0 | 0 | 1 | 1 | 3111 | 1081 | 114 | 278 | 1 | 0 | 143 | 255 | 12 | 0 | 1 | 12 | 6 | 65535 | 255 | 12 | 1 | 0 | 0 | 0 | 0 | 1 | 1 | 0 | 50 | 184 | 7469
0 | 0 | 1 | 1 | 3111 | 1081 | 114 | 278 | 1 | 0 | 143 | 255 | 12 | 0 | 1 | 12 | 6 | 65535 | 255 | 12 | 1 | 0 | 0 | 0 | 0 | 1 | 1 | 0 | 50 | 184 | 7527
0 | 0 | 1 | 1 | 3111 | 1081 | 114 | 278 | 1 | 0 | 143 | 255 | 12 | 0 | 1 | 12 | 6 | 65535 | 255 | 12 | 1 | 0 | 0 | 0 | 0 | 1 | 1 | 0 | 50 | 184 | 7586
0 | 0 | 1 | 1 | 3111 | 1081 | 114 | 278 | 1 | 0 | 143 | 255 | 12 | 0 | 1 | 12 | 6 | 65535 | 255 | 12 | 1 | 0 | 0 | 0 | 0 | 1 | 1 | 0 | 50 | 184 | 7645
0 | 0 | 1 | 1 | 3111 | 1081 | 114 | 278 | 1 | 0 | 143 | 255 | 12 | 0 | 1 | 12 | 6 | 65535 | 255 | 12 | 1 | 0 | 0 | 0 | 0 | 1 | 1 | 0 | 50 | 184 | 7704
0 | 0 | 1 | 1 | 3111 | 1081 | 114 | 278 | 1 | 0 | 143 | 255 | 12 | 0 | 1 | 12 | 6 | 65535 | 255 | 12 | 1 | 0 | 0 | 0 | 0 | 1 | 1 | 0 | 50 | 184 | 7763
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
