boksop/swcell/docs/evidence/m20_v3/hardware/20261104_194621_buffered_keys/states.csv

game | frame_game | frame_valid | frame_ticks | micro | retired | reads | writes | ticks | errors | pc | ar | a | z | c | gpo | ustate | rom_word | ram_addr | ram_wdata | ram_rdata | ram_ce | ram_oe | ram_we | keys | run | halted | trapped | cycle_ticks | phase_trace | oled_frames
0 | 0 | 1 | 18050 | 3960117 | 1281302 | 825738 | 190582 | 18050 | 0 | 141 | 5 | 1 | 0 | 1 | 8 | 1 | 61440 | 0 | 1 | 2 | 0 | 0 | 0 | 0 | 1 | 0 | 0 | 50 | 184 | 108082
0 | 0 | 1 | 18060 | 3962179 | 1281973 | 826179 | 190675 | 18060 | 0 | 141 | 5 | 10 | 0 | 0 | 8 | 1 | 61440 | 0 | 10 | 9 | 0 | 0 | 0 | 0 | 1 | 0 | 0 | 50 | 184 | 108141
0 | 0 | 1 | 18070 | 3964199 | 1282632 | 826596 | 190770 | 18070 | 0 | 141 | 5 | 9 | 0 | 1 | 8 | 1 | 61440 | 0 | 9 | 10 | 0 | 0 | 0 | 0 | 1 | 0 | 0 | 50 | 184 | 108200
0 | 0 | 1 | 18080 | 3966205 | 1283287 | 827013 | 190863 | 18080 | 0 | 141 | 5 | 2 | 0 | 0 | 8 | 1 | 61440 | 0 | 2 | 1 | 0 | 0 | 0 | 0 | 1 | 0 | 0 | 50 | 184 | 108259
0 | 0 | 1 | 18090 | 3968265 | 1283957 | 827451 | 190957 | 18090 | 0 | 141 | 5 | 12 | 0 | 0 | 8 | 1 | 61440 | 0 | 12 | 11 | 0 | 0 | 0 | 0 | 1 | 0 | 0 | 50 | 184 | 108317
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
