boksop/swcell/docs/evidence/m20_v3/hardware/20261104_210020_swapped_keys_f05/states.csv

build | game | frame_game | frame_valid | frame_ticks | micro | retired | reads | writes | ticks | errors | pc | ar | a | z | c | gpo | ustate | rom_word | ram_addr | ram_wdata | ram_rdata | ram_ce | ram_oe | ram_we | keys | queued_keys | input_overflows | run | halted | trapped | cycle_ticks | phase_trace | oled_frames
M20V3F05 | 0 | 0 | 1 | 133 | 26987 | 8792 | 5622 | 1260 | 133 | 0 | 141 | 5 | 2 | 0 | 0 | 8 | 1 | 61440 | 0 | 2 | 0 | 0 | 0 | 0 | 0 | 0 | 0 | 1 | 0 | 0 | 50 | 184 | 765
M20V3F05 | 0 | 0 | 1 | 143 | 29033 | 9458 | 6060 | 1352 | 143 | 0 | 141 | 5 | 11 | 0 | 0 | 8 | 1 | 61440 | 0 | 11 | 10 | 0 | 0 | 0 | 0 | 0 | 0 | 1 | 0 | 0 | 50 | 184 | 824
M20V3F05 | 0 | 0 | 1 | 153 | 31046 | 10115 | 6474 | 1447 | 153 | 0 | 141 | 5 | 8 | 0 | 1 | 8 | 1 | 61440 | 0 | 8 | 9 | 0 | 0 | 0 | 0 | 0 | 0 | 1 | 0 | 0 | 50 | 184 | 883
M20V3F05 | 0 | 0 | 1 | 163 | 33052 | 10770 | 6891 | 1540 | 163 | 0 | 141 | 5 | 3 | 0 | 0 | 8 | 1 | 61440 | 0 | 3 | 2 | 0 | 0 | 0 | 0 | 0 | 0 | 1 | 0 | 0 | 50 | 184 | 941
M20V3F05 | 0 | 0 | 1 | 173 | 35112 | 11440 | 7329 | 1634 | 173 | 0 | 141 | 5 | 13 | 0 | 0 | 8 | 1 | 61440 | 0 | 13 | 12 | 0 | 0 | 0 | 0 | 0 | 0 | 1 | 0 | 0 | 50 | 184 | 1000
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
