boksop/swcell/docs/evidence/m20_v3/hardware/20261104_212750_boot_entry_f06/states.csv

build | game | frame_game | frame_valid | frame_ticks | micro | retired | reads | writes | ticks | errors | pc | ar | a | z | c | gpo | ustate | rom_word | ram_addr | ram_wdata | ram_rdata | ram_ce | ram_oe | ram_we | keys | queued_keys | input_overflows | run | halted | trapped | cycle_ticks | phase_trace | oled_frames
M20V3F06 | 0 | 0 | 1 | 213 | 43176 | 14071 | 9012 | 2007 | 213 | 0 | 141 | 5 | 4 | 0 | 1 | 8 | 1 | 61440 | 0 | 4 | 5 | 0 | 0 | 0 | 0 | 0 | 0 | 1 | 0 | 0 | 50 | 184 | 1235
M20V3F06 | 0 | 0 | 0 | 213 | 43177 | 14071 | 9012 | 2007 | 213 | 0 | 0 | 0 | 0 | 1 | 0 | 8 | 1 | 8 | 8 | 0 | 5 | 0 | 0 | 0 | 0 | 0 | 0 | 0 | 0 | 0 | 50 | 184 | 1294
M20V3F06 | 0 | 0 | 0 | 213 | 43177 | 14071 | 9012 | 2007 | 213 | 0 | 0 | 0 | 0 | 1 | 0 | 8 | 1 | 8 | 8 | 0 | 5 | 0 | 0 | 0 | 0 | 0 | 0 | 0 | 0 | 0 | 50 | 184 | 1353
M20V3F06 | 0 | 0 | 0 | 213 | 43177 | 14071 | 9012 | 2007 | 213 | 0 | 0 | 0 | 0 | 1 | 0 | 8 | 1 | 8 | 8 | 0 | 5 | 0 | 0 | 0 | 0 | 0 | 0 | 0 | 0 | 0 | 50 | 184 | 1412
M20V3F06 | 0 | 0 | 0 | 213 | 43177 | 14071 | 9012 | 2007 | 213 | 0 | 0 | 0 | 0 | 1 | 0 | 8 | 1 | 8 | 8 | 0 | 5 | 0 | 0 | 0 | 0 | 0 | 0 | 0 | 0 | 0 | 50 | 184 | 1471
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
