boksop/swcell/docs/evidence/m20_v3/hardware/20261104_boot_entry_diagnosis_r1/states.csv

build | game | frame_game | frame_valid | frame_ticks | micro | retired | reads | writes | ticks | errors | pc | ar | a | z | c | gpo | ustate | rom_word | ram_addr | ram_wdata | ram_rdata | ram_ce | ram_oe | ram_we | keys | queued_keys | input_overflows | run | halted | trapped | cycle_ticks | phase_trace | oled_frames
M20V3F05 | 0 | 0 | 0 | 12443 | 2744365 | 890116 | 571191 | 130963 | 12443 | 0 | 0 | 0 | 0 | 1 | 0 | 8 | 1 | 8 | 8 | 0 | 10 | 0 | 0 | 0 | 0 | 0 | 0 | 0 | 0 | 0 | 50 | 184 | 77974
M20V3F05 | 0 | 0 | 0 | 12443 | 2744365 | 890116 | 571191 | 130963 | 12443 | 0 | 0 | 0 | 0 | 1 | 0 | 8 | 1 | 8 | 8 | 0 | 10 | 0 | 0 | 0 | 0 | 0 | 0 | 0 | 0 | 0 | 50 | 184 | 78033
M20V3F05 | 0 | 0 | 0 | 12443 | 2744365 | 890116 | 571191 | 130963 | 12443 | 0 | 0 | 0 | 0 | 1 | 0 | 8 | 1 | 8 | 8 | 0 | 10 | 0 | 0 | 0 | 0 | 0 | 0 | 0 | 0 | 0 | 50 | 184 | 78092
M20V3F05 | 0 | 0 | 0 | 12443 | 2744365 | 890116 | 571191 | 130963 | 12443 | 0 | 0 | 0 | 0 | 1 | 0 | 8 | 1 | 8 | 8 | 0 | 10 | 0 | 0 | 0 | 0 | 0 | 0 | 0 | 0 | 0 | 50 | 184 | 78151
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
