boksop/swcell/docs/diagnostics/assets/oled_keys_sim_preview.png

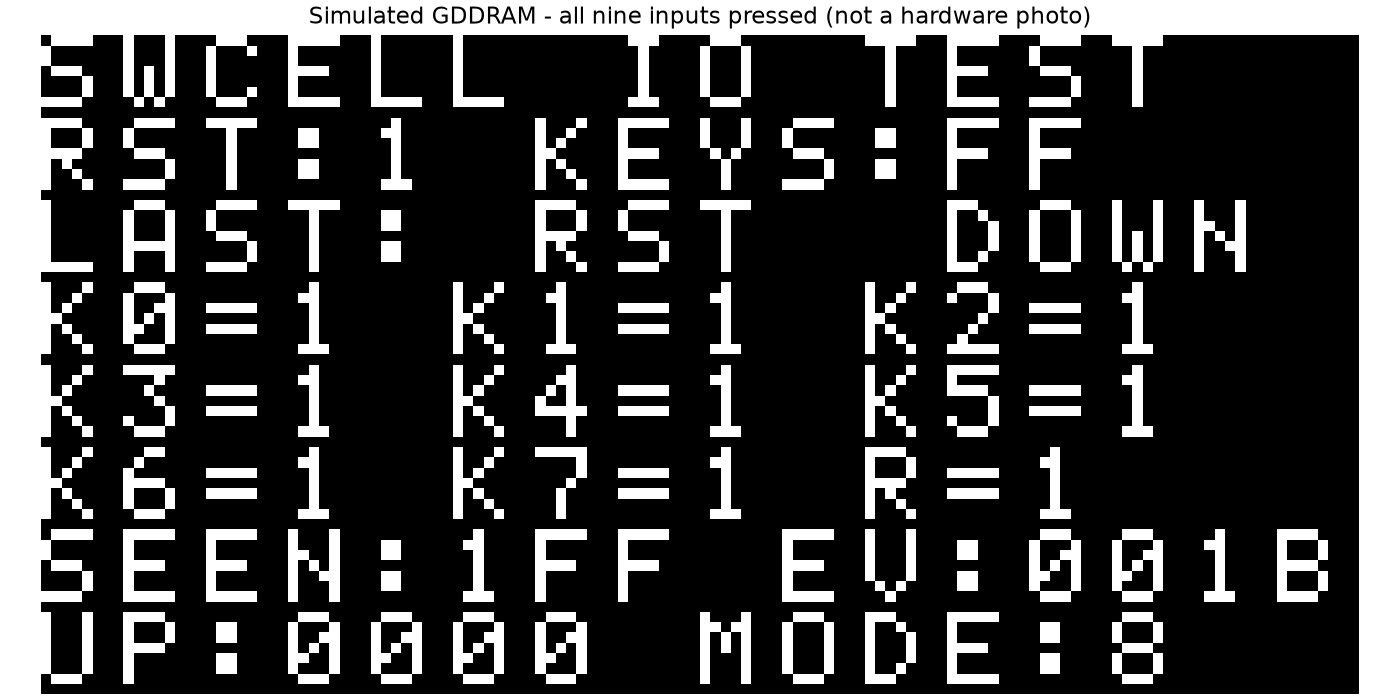
docs/diagnostics/assets/oled_keys_sim_preview.png
