boksop/swcell/docs/m20/ffcd_resources/memory_service_timing_complete.png

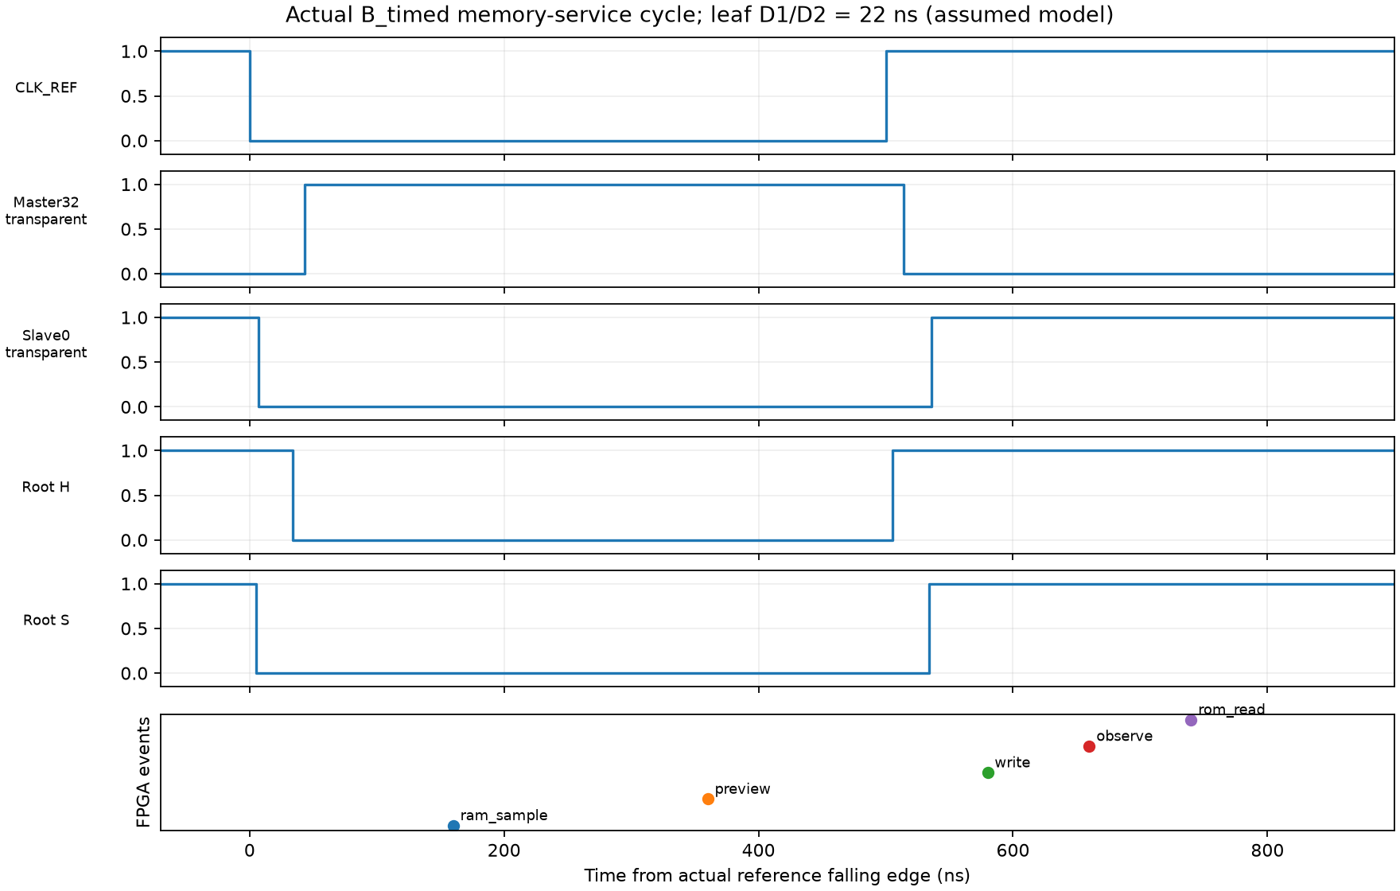
docs/m20/ffcd_resources/memory_service_timing_complete.png
