boksop/swcell/docs/evidence/m20_v31/final/restart_plus_build_r2.txt

INFO: [Common 17-3922] A valid Vivado Design Suite GOLD license has been detected. Your current license is active and will expire on Permanent.

****** Vivado v2026.1.1 (64-bit)
  **** SW Build 6605303 on Fri Sep 04 05:45:32 MDT 2026
  **** IP Build 6603865 on Fri Sep 04 05:05:05 MDT 2026
  **** SharedData Build 6605217 on Fri Sep 04 02:50:14 MDT 2026
  **** Start of session at: Thu Nov  5 12:25:28 2026
    ** Copyright 1986-2022 Xilinx, Inc. All Rights Reserved.
    ** Copyright 2022-2026 Advanced Micro Devices, Inc. All Rights Reserved.

source fpga/projects/m20/autonomous/scripts/build.tcl
# proc main {} {
#  global argv swc
#  source [file join [file dirname [info script]] ../../../../common/tcl/repo_paths.tcl]
#  set root [swc_repo_root [info script]]
#  source [file join $root fpga boards swcell_k325t board.tcl]
#  if {$swc(part) ne "xc7k325tffg900-2"||$swc(clk_hz)!=50000000} {error "Review V3 constraints for this board part/clock"}
#  set stage bitstream;set output "";set rom ""
#  foreach {key value} $argv {
#   switch -- $key {--stage {set stage $value} --output {set output $value} --rom {set rom $value} default {error "Unknown argument $key"}}
#  }
#  if {$stage ni {synth bitstream}} {error "Invalid stage"}
#  if {$output eq "" || $rom eq ""} {error "Explicit fresh --output and --rom required"}
#  set output [file normalize $output];set rom [file normalize $rom]
#  if {![string match "[file join $root build]/*" $output]||[file exists $output]} {error "Choose fresh output under build/"}
#  if {![file isfile $rom]} {error "Missing ROM"}
#  file mkdir $output
#  set sources {}
#  foreach n {swc_input_sync swc_power_on_reset swc_debounce swc_uart_rx swc_uart_tx swc_uart_hex_json} {lappend sources [file join $root rtl common ${n}.sv]}
#  set v3 [file join $root rtl modules m20 v3]
#  lappend sources [file join $v3 swc_v3_mux157.sv] [file join $v3 generated m20v3_cpu_core.sv]
#  foreach n {swc_m20_v31_memory swc_m20_v31_service swc_m20_v31_gpio} {lappend sources [file join $root rtl modules m20 v31 ${n}.sv]}
#  lappend sources [file join $root fpga projects m20 autonomous rtl swcell_m20_v31_top.sv]
#  set xdc [file join $root fpga projects diagnostics oled_keys constraints io.xdc]
#  set inputs [concat $sources [list $xdc [info script] $rom [file join $root fpga boards swcell_k325t board.tcl]]]
#  set hashes [dict create];set f [open [file join $output source_sha256.txt] w]
#  foreach file $inputs {
#   set file [file normalize $file]
#   set digest [lindex [exec sha256sum $file] 0];dict set hashes $file $digest
#   puts $f "$digest  [string range $file [expr {[string length $root]+1}] end]"
#  };close $f
#  create_project -in_memory -part $swc(part)
#  set_property verilog_define {SWC_V3_XILINX} [current_fileset]
#  foreach file $sources {read_verilog -sv $file}
#  set f [open [file join $output software_profile.txt] w];puts $f "ROM_FILE=$rom";close $f
#  synth_design -top swcell_m20_v31_top -part $swc(part) -flatten_hierarchy none -generic [list ROM_FILE=$rom]
#  read_xdc $xdc
#  create_clock -name sys_clk -period 20.0 [get_ports sys_clk]
#  set_output_delay -clock sys_clk -max 5.0 [all_outputs]
#  set_output_delay -clock sys_clk -min 0.0 [all_outputs]
#  set first [get_pins -hier -quiet -regexp {.*(sync_keys|reset_sync|rx_sync|sync_inputs)/pipe_reg\[0\].*/D}]
#  if {[llength $first]!=9} {error "Expected six GPI plus reset/debug/RX first synchronizers, got [llength $first]"}
#  set_false_path -from [get_ports {RST_N KEY0 KEY1 KEY2 KEY3 KEY5 KEY6 KEY7 UART_RXD}] -to $first
#  # No false paths or unconstrained fabric clocks in CPU logic. Try ordinary 50MHz STA first.
#  set muxes [get_cells -hier -filter {REF_NAME == LUT3 && NAME =~ *cpu*cell_mux}]
#  set expected 477
#  if {[llength $muxes]!=$expected} {error "CPU mux mapping differs: [llength $muxes], expected $expected"}
#  set f [open [file join $output cpu_mux_cells.txt] w];foreach cell $muxes {puts $f $cell};close $f
#  report_utilization -hierarchical -file [file join $output synth_utilization.rpt]
#  report_timing_summary -report_unconstrained -file [file join $output synth_timing.rpt]
#  report_drc -checks [get_drc_checks LUTLP-1] -file [file join $output feedback_drc.rpt]
#  if {$stage eq "synth"} {puts "M20_V31_SYNTH_COMPLETE mode=FUNCTIONAL_STORAGE muxes=[llength $muxes]";return}
#  opt_design
#  place_design
#  route_design
#  report_timing_summary -report_unconstrained -file [file join $output timing.rpt]
#  report_utilization -hierarchical -file [file join $output utilization.rpt]
#  if {[llength [info commands report_ram_utilization]]} {report_ram_utilization -file [file join $output ram.rpt]}
#  report_io -file [file join $output io.rpt]
#  report_cdc -details -file [file join $output cdc.rpt]
#  report_drc -file [file join $output drc.rpt]
#  write_checkpoint [file join $output routed.dcp]
#  set violations [get_drc_violations -quiet]
#  if {[llength $violations]} {error "DRC_BLOCKED_FUNCTIONAL_STORAGE: [llength $violations] violations; no bitstream; see drc.rpt"}
#  foreach type {max min} {
#   set p [get_timing_paths -delay_type $type -max_paths 1]
#   if {[llength $p]!=1||[get_property SLACK $p]<0} {error "FPGA_TIMING_FAILED_$type; no bitstream"}
#  }
#  # Retain explicit check_timing evidence; clocked native storage is all in sys_clk.
#  check_timing -verbose -file [file join $output check_timing.rpt]
#  dict for {file digest} $hashes {if {[lindex [exec sha256sum $file] 0] ne $digest} {error "SOURCE_CHANGED_DURING_BUILD $file"}}
#  set_property BITSTREAM.STARTUP.STARTUPCLK JTAGCLK [current_design]
#  set_property BITSTREAM.GENERAL.COMPRESS TRUE [current_design]
#  write_bitstream [file join $output swcell_m20_v31_top.bit]
#  puts "M20_V31_BITSTREAM_PASS $output/swcell_m20_v31_top.bit"
# }
# if {[catch {main} message]} {puts stderr "M20_V31_BUILD_ERROR: $message";exit 1}
## proc swc_repo_root {script_path} {
##     set dir [file dirname [file normalize $script_path]]
##     while {1} {
##         if {[file isfile [file join $dir AGENTS.md]] && [file isdirectory [file join $dir rtl]] && [file isdirectory [file join $dir fpga]]} {return $dir}
##         set parent [file dirname $dir]
##         if {$parent eq $dir} {error "Cannot locate SwCell repository from $script_path"}
##         set dir $parent
##     }
## }
## set swc(part) xc7k325tffg900-2
## set swc(clk_hz) 50000000
## set swc(flash_model) N25Q256A13EF840F
## set swc(flash_enable) 1
## set swc(boot_mode_bits) 001
## set swc(flash_cfgmem_part) mt25ql256-spi-x1_x2_x4
## set swc(flash_cfgmem_alias) n25q256-3.3v-spi-x1_x2_x4
## set swc(flash_size_mib) 32
## set swc(flash_buswidth) 4
## set swc(flash_transfer) SDR
## set swc(flash_fall_edge) 1
## set swc(flash_32bit_addr) 1
## set swc(flash_compress) 1
## set swc(configrate_mhz) auto
## set swc(flash_tco_ns) 7.0
## set swc(fpga_spi_setup_ns) 3.0
## set swc(cclk_tolerance) 0.5
## set swc(flash_sdr_max_mhz) 108.0
## set swc(fpga_cclk_max_mhz) 100.0
## set swc(flash_board_delay_budget_ns) 2.0
Command: synth_design -top swcell_m20_v31_top -part xc7k325tffg900-2 -flatten_hierarchy none -generic ROM_FILE=/home/boksop/swcell/software/m20_300/v31/m20_v31.memh
INFO: [Vivado_Tcl 97-130] Option flatten_hierarchy used for synth_design is: none
Starting synth_design
Attempting to get a license for feature 'Synthesis' and/or device 'xc7k325t'
INFO: [Common 17-349] Got license for feature 'Synthesis' and/or device 'xc7k325t'
INFO: [Synth 8-7079] Multithreading enabled for synth_design using a maximum of 7 processes.
INFO: [Synth 8-7078] Launching helper process for spawning children vivado processes
INFO: [Synth 8-7075] Helper process launched with PID 371921
---------------------------------------------------------------------------------
Starting Synthesize : Time (s): cpu = 00:00:04 ; elapsed = 00:00:04 . Memory (MB): peak = 2244.773 ; gain = 503.555 ; free physical = 50308 ; free virtual = 64367
---------------------------------------------------------------------------------
INFO: [Synth 8-6157] synthesizing module 'swcell_m20_v31_top' [/home/boksop/swcell/fpga/projects/m20/autonomous/rtl/swcell_m20_v31_top.sv:3]
	Parameter ROM_FILE bound to: /home/boksop/swcell/software/m20_300/v31/m20_v31.memh - type: string 
INFO: [Synth 8-6157] synthesizing module 'swc_power_on_reset' [/home/boksop/swcell/rtl/common/swc_power_on_reset.sv:4]
	Parameter HOLD_CYCLES bound to: 5000000 - type: integer 
INFO: [Synth 8-6155] done synthesizing module 'swc_power_on_reset' (0#1) [/home/boksop/swcell/rtl/common/swc_power_on_reset.sv:4]
INFO: [Synth 8-6157] synthesizing module 'swc_m20_v31_gpio' [/home/boksop/swcell/rtl/modules/m20/v31/swc_m20_v31_gpio.sv:3]
INFO: [Synth 8-6157] synthesizing module 'swc_input_sync' [/home/boksop/swcell/rtl/common/swc_input_sync.sv:2]
	Parameter WIDTH bound to: 6 - type: integer 
	Parameter STAGES bound to: 2 - type: integer 
INFO: [Synth 8-6155] done synthesizing module 'swc_input_sync' (0#1) [/home/boksop/swcell/rtl/common/swc_input_sync.sv:2]
INFO: [Synth 8-6155] done synthesizing module 'swc_m20_v31_gpio' (0#1) [/home/boksop/swcell/rtl/modules/m20/v31/swc_m20_v31_gpio.sv:3]
INFO: [Synth 8-6157] synthesizing module 'swc_input_sync__parameterized0' [/home/boksop/swcell/rtl/common/swc_input_sync.sv:2]
	Parameter WIDTH bound to: 1 - type: integer 
INFO: [Synth 8-6155] done synthesizing module 'swc_input_sync__parameterized0' (0#1) [/home/boksop/swcell/rtl/common/swc_input_sync.sv:2]
INFO: [Synth 8-6157] synthesizing module 'swc_debounce' [/home/boksop/swcell/rtl/common/swc_debounce.sv:3]
	Parameter WIDTH bound to: 1 - type: integer 
	Parameter STABLE_CYCLES bound to: 1000000 - type: integer 
INFO: [Synth 8-6157] synthesizing module 'swc_input_sync__parameterized1' [/home/boksop/swcell/rtl/common/swc_input_sync.sv:2]
	Parameter WIDTH bound to: 1 - type: integer 
	Parameter STAGES bound to: 2 - type: integer 
INFO: [Synth 8-6155] done synthesizing module 'swc_input_sync__parameterized1' (0#1) [/home/boksop/swcell/rtl/common/swc_input_sync.sv:2]
INFO: [Synth 8-6155] done synthesizing module 'swc_debounce' (0#1) [/home/boksop/swcell/rtl/common/swc_debounce.sv:3]
INFO: [Synth 8-6157] synthesizing module 'swc_uart_rx' [/home/boksop/swcell/rtl/common/swc_uart_rx.sv:3]
	Parameter CLK_HZ bound to: 50000000 - type: integer 
	Parameter BAUD bound to: 115200 - type: integer 
INFO: [Synth 8-6155] done synthesizing module 'swc_uart_rx' (0#1) [/home/boksop/swcell/rtl/common/swc_uart_rx.sv:3]
INFO: [Synth 8-6157] synthesizing module 'swc_m20_v31_service' [/home/boksop/swcell/rtl/modules/m20/v31/swc_m20_v31_service.sv:3]
	Parameter ROM_FILE bound to: /home/boksop/swcell/software/m20_300/v31/m20_v31.memh - type: string 
INFO: [Synth 8-6157] synthesizing module 'swc_m20_v31_memory' [/home/boksop/swcell/rtl/modules/m20/v31/swc_m20_v31_memory.sv:3]
	Parameter ROM_FILE bound to: /home/boksop/swcell/software/m20_300/v31/m20_v31.memh - type: string 
INFO: [Synth 8-3876] $readmem data file '/home/boksop/swcell/software/m20_300/v31/m20_v31.memh' is read successfully [/home/boksop/swcell/rtl/modules/m20/v31/swc_m20_v31_memory.sv:16]
INFO: [Synth 8-6155] done synthesizing module 'swc_m20_v31_memory' (0#1) [/home/boksop/swcell/rtl/modules/m20/v31/swc_m20_v31_memory.sv:3]
INFO: [Synth 8-6157] synthesizing module 'm20v3_cpu_core' [/home/boksop/swcell/rtl/modules/m20/v3/generated/m20v3_cpu_core.sv:3]
	Parameter STORAGE_MODE bound to: FUNCTIONAL_STORAGE - type: string 
INFO: [Synth 8-6157] synthesizing module 'swc_v3_mux157' [/home/boksop/swcell/rtl/modules/m20/v3/swc_v3_mux157.sv:3]
INFO: [Synth 8-6157] synthesizing module 'LUT3' [/home/boksop/AMDDesignTools/2026.1.1/Vivado/scripts/rt/data/unisim_comp.v:95299]
	Parameter INIT bound to: 8'b11001010 
INFO: [Synth 8-6155] done synthesizing module 'LUT3' (0#1) [/home/boksop/AMDDesignTools/2026.1.1/Vivado/scripts/rt/data/unisim_comp.v:95299]
INFO: [Synth 8-6155] done synthesizing module 'swc_v3_mux157' (0#1) [/home/boksop/swcell/rtl/modules/m20/v3/swc_v3_mux157.sv:3]
INFO: [Synth 8-6155] done synthesizing module 'm20v3_cpu_core' (0#1) [/home/boksop/swcell/rtl/modules/m20/v3/generated/m20v3_cpu_core.sv:3]
WARNING: [Synth 8-7071] port 'debug_legal' of module 'm20v3_cpu_core' is unconnected for instance 'cpu' [/home/boksop/swcell/rtl/modules/m20/v31/swc_m20_v31_service.sv:33]
WARNING: [Synth 8-7071] port 'retire_pc' of module 'm20v3_cpu_core' is unconnected for instance 'cpu' [/home/boksop/swcell/rtl/modules/m20/v31/swc_m20_v31_service.sv:33]
WARNING: [Synth 8-7071] port 'retire_instruction' of module 'm20v3_cpu_core' is unconnected for instance 'cpu' [/home/boksop/swcell/rtl/modules/m20/v31/swc_m20_v31_service.sv:33]
WARNING: [Synth 8-7071] port 'retire_next_pc' of module 'm20v3_cpu_core' is unconnected for instance 'cpu' [/home/boksop/swcell/rtl/modules/m20/v31/swc_m20_v31_service.sv:33]
WARNING: [Synth 8-7071] port 'retire_ar' of module 'm20v3_cpu_core' is unconnected for instance 'cpu' [/home/boksop/swcell/rtl/modules/m20/v31/swc_m20_v31_service.sv:33]
WARNING: [Synth 8-7071] port 'retire_a' of module 'm20v3_cpu_core' is unconnected for instance 'cpu' [/home/boksop/swcell/rtl/modules/m20/v31/swc_m20_v31_service.sv:33]
WARNING: [Synth 8-7071] port 'retire_z' of module 'm20v3_cpu_core' is unconnected for instance 'cpu' [/home/boksop/swcell/rtl/modules/m20/v31/swc_m20_v31_service.sv:33]
WARNING: [Synth 8-7071] port 'retire_c' of module 'm20v3_cpu_core' is unconnected for instance 'cpu' [/home/boksop/swcell/rtl/modules/m20/v31/swc_m20_v31_service.sv:33]
WARNING: [Synth 8-7071] port 'retire_gpo' of module 'm20v3_cpu_core' is unconnected for instance 'cpu' [/home/boksop/swcell/rtl/modules/m20/v31/swc_m20_v31_service.sv:33]
WARNING: [Synth 8-7071] port 'debug_next_state' of module 'm20v3_cpu_core' is unconnected for instance 'cpu' [/home/boksop/swcell/rtl/modules/m20/v31/swc_m20_v31_service.sv:33]
WARNING: [Synth 8-7071] port 'retire_is_memory' of module 'm20v3_cpu_core' is unconnected for instance 'cpu' [/home/boksop/swcell/rtl/modules/m20/v31/swc_m20_v31_service.sv:33]
WARNING: [Synth 8-7071] port 'retire_ram_valid' of module 'm20v3_cpu_core' is unconnected for instance 'cpu' [/home/boksop/swcell/rtl/modules/m20/v31/swc_m20_v31_service.sv:33]
WARNING: [Synth 8-7071] port 'retire_ram_write' of module 'm20v3_cpu_core' is unconnected for instance 'cpu' [/home/boksop/swcell/rtl/modules/m20/v31/swc_m20_v31_service.sv:33]
WARNING: [Synth 8-7071] port 'retire_ram_addr' of module 'm20v3_cpu_core' is unconnected for instance 'cpu' [/home/boksop/swcell/rtl/modules/m20/v31/swc_m20_v31_service.sv:33]
WARNING: [Synth 8-7071] port 'retire_ram_wdata' of module 'm20v3_cpu_core' is unconnected for instance 'cpu' [/home/boksop/swcell/rtl/modules/m20/v31/swc_m20_v31_service.sv:33]
WARNING: [Synth 8-7071] port 'retire_ram_rdata' of module 'm20v3_cpu_core' is unconnected for instance 'cpu' [/home/boksop/swcell/rtl/modules/m20/v31/swc_m20_v31_service.sv:33]
WARNING: [Synth 8-7023] instance 'cpu' of module 'm20v3_cpu_core' has 44 connections declared, but only 28 given [/home/boksop/swcell/rtl/modules/m20/v31/swc_m20_v31_service.sv:33]
INFO: [Synth 8-6155] done synthesizing module 'swc_m20_v31_service' (0#1) [/home/boksop/swcell/rtl/modules/m20/v31/swc_m20_v31_service.sv:3]
INFO: [Synth 8-6157] synthesizing module 'swc_uart_hex_json' [/home/boksop/swcell/rtl/common/swc_uart_hex_json.sv:4]
	Parameter CLK_HZ bound to: 50000000 - type: integer 
	Parameter BAUD bound to: 115200 - type: integer 
	Parameter HEX_DIGITS bound to: 92 - type: integer 
	Parameter FORMAT bound to: {"type":"M20_V31_STATE","build":"M20V31A01","pc":"###","ar":"##","a":"#","gpo":"#","ustate":"#","keys":"##","flags":"##","micro":"################","retired":"################","reads":"################","writes":"################","errors":"################"}
 - type: string 
INFO: [Synth 8-6157] synthesizing module 'swc_uart_tx' [/home/boksop/swcell/rtl/common/swc_uart_tx.sv:3]
	Parameter CLK_HZ bound to: 50000000 - type: integer 
	Parameter BAUD bound to: 115200 - type: integer 
INFO: [Synth 8-6155] done synthesizing module 'swc_uart_tx' (0#1) [/home/boksop/swcell/rtl/common/swc_uart_tx.sv:3]
INFO: [Synth 8-6155] done synthesizing module 'swc_uart_hex_json' (0#1) [/home/boksop/swcell/rtl/common/swc_uart_hex_json.sv:4]
INFO: [Synth 8-6155] done synthesizing module 'swcell_m20_v31_top' (0#1) [/home/boksop/swcell/fpga/projects/m20/autonomous/rtl/swcell_m20_v31_top.sv:3]
WARNING: [Synth 8-7129] Port master_hold in module m20v3_cpu_core is either unconnected or has no load
WARNING: [Synth 8-7129] Port slave_open in module m20v3_cpu_core is either unconnected or has no load
WARNING: [Synth 8-7129] Port KEY4 in module swcell_m20_v31_top is either unconnected or has no load
---------------------------------------------------------------------------------
Finished Synthesize : Time (s): cpu = 00:00:05 ; elapsed = 00:00:05 . Memory (MB): peak = 2342.711 ; gain = 601.492 ; free physical = 50156 ; free virtual = 64217
---------------------------------------------------------------------------------
---------------------------------------------------------------------------------
Finished Constraint Validation : Time (s): cpu = 00:00:05 ; elapsed = 00:00:05 . Memory (MB): peak = 2357.555 ; gain = 616.336 ; free physical = 50158 ; free virtual = 64216
---------------------------------------------------------------------------------
---------------------------------------------------------------------------------
Start Loading Part and Timing Information
---------------------------------------------------------------------------------
Loading part: xc7k325tffg900-2
INFO: [Device 21-403] Loading part xc7k325tffg900-2
---------------------------------------------------------------------------------
Finished Loading Part and Timing Information : Time (s): cpu = 00:00:05 ; elapsed = 00:00:05 . Memory (MB): peak = 2357.555 ; gain = 616.336 ; free physical = 50157 ; free virtual = 64215
---------------------------------------------------------------------------------
---------------------------------------------------------------------------------
Finished RTL Optimization Phase 2 : Time (s): cpu = 00:00:06 ; elapsed = 00:00:06 . Memory (MB): peak = 2390.484 ; gain = 649.266 ; free physical = 50093 ; free virtual = 64164
---------------------------------------------------------------------------------
No constraint files found.
---------------------------------------------------------------------------------
Start RTL Component Statistics 
---------------------------------------------------------------------------------
Detailed RTL Component Info : 
+---Adders : 
	   2 Input   32 Bit       Adders := 3     
	   2 Input   16 Bit       Adders := 3     
	   2 Input    9 Bit       Adders := 2     
	   2 Input    7 Bit       Adders := 1     
	   2 Input    4 Bit       Adders := 4     
	   2 Input    2 Bit       Adders := 1     
+---Registers : 
	              368 Bit    Registers := 1     
	               32 Bit    Registers := 1     
	               16 Bit    Registers := 5     
	               12 Bit    Registers := 3     
	               10 Bit    Registers := 1     
	                9 Bit    Registers := 1     
	                8 Bit    Registers := 3     
	                6 Bit    Registers := 2     
	                4 Bit    Registers := 6     
	                3 Bit    Registers := 3     
	                2 Bit    Registers := 2     
	                1 Bit    Registers := 29    
+---RAMs : 
	             1024 Bit	(256 X 4 bit)          RAMs := 1     
+---ROMs : 
	                    ROMs := 1     
+---Muxes : 
	   3 Input   32 Bit        Muxes := 1     
	   2 Input   16 Bit        Muxes := 3     
	   2 Input   10 Bit        Muxes := 1     
	   2 Input    9 Bit        Muxes := 1     
	   2 Input    8 Bit        Muxes := 4     
	   2 Input    7 Bit        Muxes := 1     
	   2 Input    4 Bit        Muxes := 5     
	   2 Input    2 Bit        Muxes := 1     
	   2 Input    1 Bit        Muxes := 47    
---------------------------------------------------------------------------------
Finished RTL Component Statistics 
---------------------------------------------------------------------------------
---------------------------------------------------------------------------------
Start Part Resource Summary
---------------------------------------------------------------------------------
Part Resources:
DSPs: 840 (col length:140)
BRAMs: 890 (col length: RAMB18 140 RAMB36 70)
---------------------------------------------------------------------------------
Finished Part Resource Summary
---------------------------------------------------------------------------------
No constraint files found.
---------------------------------------------------------------------------------
Start Cross Boundary and Area Optimization
---------------------------------------------------------------------------------
WARNING: [Synth 8-7129] Port master_hold in module m20v3_cpu_core is either unconnected or has no load
WARNING: [Synth 8-7129] Port slave_open in module m20v3_cpu_core is either unconnected or has no load
WARNING: [Synth 8-7129] Port KEY4 in module swcell_m20_v31_top is either unconnected or has no load
---------------------------------------------------------------------------------
Finished Cross Boundary and Area Optimization : Time (s): cpu = 00:00:13 ; elapsed = 00:00:13 . Memory (MB): peak = 2603.617 ; gain = 862.398 ; free physical = 49786 ; free virtual = 63853
---------------------------------------------------------------------------------
---------------------------------------------------------------------------------
Start ROM, RAM, DSP, Shift Register and Retiming Reporting
---------------------------------------------------------------------------------

Block RAM: Preliminary Mapping Report (see note below)
+---------------+------------+------------------------+---+---+------------------------+---+---+------------------+--------+--------+
|Module Name    | RTL Object | PORT A (Depth x Width) | W | R | PORT B (Depth x Width) | W | R | Ports driving FF | RAMB18 | RAMB36 | 
+---------------+------------+------------------------+---+---+------------------------+---+---+------------------+--------+--------+
|service/memory | memory_reg | 256 x 4(READ_FIRST)    | W |   | 256 x 4(WRITE_FIRST)   |   | R | Port A and B     | 1      | 0      | 
+---------------+------------+------------------------+---+---+------------------------+---+---+------------------+--------+--------+

Note: The table above is a preliminary report that shows the Block RAMs at the current stage of the synthesis flow. Some Block RAMs may be reimplemented as non Block RAM primitives later in the synthesis flow. Multiple instantiated Block RAMs are reported only once. 
---------------------------------------------------------------------------------
Finished ROM, RAM, DSP, Shift Register and Retiming Reporting
---------------------------------------------------------------------------------
No constraint files found.
---------------------------------------------------------------------------------
Start Timing Optimization
---------------------------------------------------------------------------------
---------------------------------------------------------------------------------
Finished Timing Optimization : Time (s): cpu = 00:00:13 ; elapsed = 00:00:13 . Memory (MB): peak = 2603.617 ; gain = 862.398 ; free physical = 49789 ; free virtual = 63856
---------------------------------------------------------------------------------
---------------------------------------------------------------------------------
Start ROM, RAM, DSP, Shift Register and Retiming Reporting
---------------------------------------------------------------------------------

Block RAM: Final Mapping Report
+---------------+------------+------------------------+---+---+------------------------+---+---+------------------+--------+--------+
|Module Name    | RTL Object | PORT A (Depth x Width) | W | R | PORT B (Depth x Width) | W | R | Ports driving FF | RAMB18 | RAMB36 | 
+---------------+------------+------------------------+---+---+------------------------+---+---+------------------+--------+--------+
|service/memory | memory_reg | 256 x 4(READ_FIRST)    | W |   | 256 x 4(WRITE_FIRST)   |   | R | Port A and B     | 1      | 0      | 
+---------------+------------+------------------------+---+---+------------------------+---+---+------------------+--------+--------+

---------------------------------------------------------------------------------
Finished ROM, RAM, DSP, Shift Register and Retiming Reporting
---------------------------------------------------------------------------------
---------------------------------------------------------------------------------
Start Technology Mapping
---------------------------------------------------------------------------------
INFO: [Synth 8-7052] The timing for the instance service/memory/memory_reg (implemented as a Block RAM) might be sub-optimal as no optional output register could be merged into the ram block. Providing additional output register may help in improving timing.
---------------------------------------------------------------------------------
Finished Technology Mapping : Time (s): cpu = 00:00:14 ; elapsed = 00:00:14 . Memory (MB): peak = 2603.617 ; gain = 862.398 ; free physical = 49789 ; free virtual = 63856
---------------------------------------------------------------------------------
---------------------------------------------------------------------------------
Start IO Insertion
---------------------------------------------------------------------------------
---------------------------------------------------------------------------------
Start Final Netlist Cleanup
---------------------------------------------------------------------------------
---------------------------------------------------------------------------------
Finished Final Netlist Cleanup
---------------------------------------------------------------------------------
---------------------------------------------------------------------------------
Finished IO Insertion : Time (s): cpu = 00:00:16 ; elapsed = 00:00:16 . Memory (MB): peak = 2747.430 ; gain = 1006.211 ; free physical = 49672 ; free virtual = 63740
---------------------------------------------------------------------------------
---------------------------------------------------------------------------------
Start Renaming Generated Instances
---------------------------------------------------------------------------------
---------------------------------------------------------------------------------
Finished Renaming Generated Instances : Time (s): cpu = 00:00:16 ; elapsed = 00:00:16 . Memory (MB): peak = 2747.430 ; gain = 1006.211 ; free physical = 49675 ; free virtual = 63743
---------------------------------------------------------------------------------
---------------------------------------------------------------------------------
Start Handling Custom Attributes
---------------------------------------------------------------------------------
---------------------------------------------------------------------------------
Finished Handling Custom Attributes : Time (s): cpu = 00:00:16 ; elapsed = 00:00:16 . Memory (MB): peak = 2750.398 ; gain = 1009.180 ; free physical = 49675 ; free virtual = 63743
---------------------------------------------------------------------------------
---------------------------------------------------------------------------------
Start Writing Synthesis Report
---------------------------------------------------------------------------------

Report BlackBoxes: 
+-+--------------+----------+
| |BlackBox name |Instances |
+-+--------------+----------+
+-+--------------+----------+

Report Cell Usage: 
+------+---------+------+
|      |Cell     |Count |
+------+---------+------+
|1     |BUFG     |     1|
|2     |CARRY4   |   129|
|3     |LUT1     |    84|
|4     |LUT2     |    52|
|5     |LUT3     |   526|
|6     |LUT4     |    72|
|7     |LUT5     |    49|
|8     |LUT6     |   245|
|9     |MUXF7    |    48|
|10    |MUXF8    |    12|
|11    |RAMB18E1 |     1|
|12    |RAMB36E1 |     2|
|13    |FDRE     |   975|
|14    |FDSE     |     7|
|15    |IBUF     |    10|
|16    |OBUF     |    14|
+------+---------+------+

Report Instance Areas: 
+------+--------------------------+----------------------------------+------+
|      |Instance                  |Module                            |Cells |
+------+--------------------------+----------------------------------+------+
|1     |top                       |                                  |  2227|
|2     |  por                     |swc_power_on_reset                |    41|
|3     |  gpio                    |swc_m20_v31_gpio                  |    18|
|4     |    sync_keys             |swc_input_sync                    |    12|
|5     |  reset_sync              |swc_input_sync__parameterized0__1 |     2|
|6     |  debug_key               |swc_debounce                      |    39|
|7     |    sync_inputs           |swc_input_sync__parameterized1    |     2|
|8     |  rx_sync                 |swc_input_sync__parameterized0    |     2|
|9     |  receiver                |swc_uart_rx                       |   100|
|10    |  service                 |swc_m20_v31_service               |  1054|
|11    |    memory                |swc_m20_v31_memory                |    26|
|12    |    cpu                   |m20v3_cpu_core                    |   510|
|13    |      \g_decode.u_n0000   |swc_v3_mux157__1                  |     1|
|14    |      \g_decode.u_n0001   |swc_v3_mux157__2                  |     1|
|15    |      \g_decode.u_n0003   |swc_v3_mux157__3                  |     1|
|16    |      \g_decode.u_n0004   |swc_v3_mux157__4                  |     1|
|17    |      \g_decode.u_n0005   |swc_v3_mux157__5                  |     1|
|18    |      \g_decode.u_n0007   |swc_v3_mux157__6                  |     1|
|19    |      \g_decode.u_n0009   |swc_v3_mux157__7                  |     1|
|20    |      \g_decode.u_n0010   |swc_v3_mux157__8                  |     1|
|21    |      \g_decode.u_n0011   |swc_v3_mux157__9                  |     1|
|22    |      \g_decode.u_n0012   |swc_v3_mux157__10                 |     1|
|23    |      \g_decode.u_n0013   |swc_v3_mux157__11                 |     1|
|24    |      \g_decode.u_n0014   |swc_v3_mux157__12                 |     1|
|25    |      \g_decode.u_n0015   |swc_v3_mux157__13                 |     1|
|26    |      \g_decode.u_n0016   |swc_v3_mux157__14                 |     1|
|27    |      \g_decode.u_n0018   |swc_v3_mux157__15                 |     1|
|28    |      \g_decode.u_n0019   |swc_v3_mux157__16                 |     1|
|29    |      \g_decode.u_n0020   |swc_v3_mux157__17                 |     1|
|30    |      \g_decode.u_n0021   |swc_v3_mux157__18                 |     1|
|31    |      \g_decode.u_n0022   |swc_v3_mux157__19                 |     1|
|32    |      \g_decode.u_n0024   |swc_v3_mux157__20                 |     1|
|33    |      \g_decode.u_n0025   |swc_v3_mux157__21                 |     1|
|34    |      \g_decode.u_n0026   |swc_v3_mux157__22                 |     1|
|35    |      \g_decode.u_n0027   |swc_v3_mux157__23                 |     1|
|36    |      \g_decode.u_n0028   |swc_v3_mux157__24                 |     1|
|37    |      \g_decode.u_n0030   |swc_v3_mux157__25                 |     1|
|38    |      \g_decode.u_n0031   |swc_v3_mux157__26                 |     1|
|39    |      \g_decode.u_n0032   |swc_v3_mux157__27                 |     1|
|40    |      \g_decode.u_n0033   |swc_v3_mux157__28                 |     1|
|41    |      \g_decode.u_n0034   |swc_v3_mux157__29                 |     1|
|42    |      \g_decode.u_n0035   |swc_v3_mux157__30                 |     1|
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
|477   |      \g_bus.u_n0588      |swc_v3_mux157__465                |     1|
|478   |      \g_bus.u_n0589      |swc_v3_mux157__466                |     1|
|479   |      \g_bus.u_n0590      |swc_v3_mux157__467                |     1|
|480   |      \g_bus.u_n0591      |swc_v3_mux157__468                |     1|
|481   |      \g_bus.u_n0592      |swc_v3_mux157__469                |     1|
|482   |      \g_bus.u_n0593      |swc_v3_mux157__470                |     1|
|483   |      \g_bus.u_n0595      |swc_v3_mux157__471                |     1|
|484   |      \g_bus.u_n0596      |swc_v3_mux157__472                |     1|
|485   |      \g_bus.u_n0597      |swc_v3_mux157__473                |     1|
|486   |      \g_bus.u_n0599      |swc_v3_mux157__474                |     1|
|487   |      \g_bus.u_n0600      |swc_v3_mux157__475                |     1|
|488   |      \g_bus.u_n0601      |swc_v3_mux157__476                |     1|
|489   |      \g_bus.u_n0602      |swc_v3_mux157                     |     1|
|490   |  reporter                |swc_uart_hex_json                 |   742|
|491   |    uart                  |swc_uart_tx                       |    49|
+------+--------------------------+----------------------------------+------+
---------------------------------------------------------------------------------
Finished Writing Synthesis Report : Time (s): cpu = 00:00:16 ; elapsed = 00:00:16 . Memory (MB): peak = 2750.398 ; gain = 1009.180 ; free physical = 49675 ; free virtual = 63743
---------------------------------------------------------------------------------
Synthesis finished with 0 errors, 0 critical warnings and 23 warnings.
Synthesis Optimization Runtime : Time (s): cpu = 00:00:16 ; elapsed = 00:00:16 . Memory (MB): peak = 2750.398 ; gain = 1009.180 ; free physical = 49668 ; free virtual = 63735
Synthesis Optimization Complete : Time (s): cpu = 00:00:16 ; elapsed = 00:00:16 . Memory (MB): peak = 2750.406 ; gain = 1009.180 ; free physical = 49668 ; free virtual = 63735
INFO: [Project 1-571] Translating synthesized netlist
Netlist sorting complete. Time (s): cpu = 00:00:00.01 ; elapsed = 00:00:00.01 . Memory (MB): peak = 2764.273 ; gain = 0.000 ; free physical = 49824 ; free virtual = 63891
INFO: [Netlist 29-17] Analyzing 192 Unisim elements for replacement
INFO: [Netlist 29-28] Unisim Transformation completed in 0 CPU seconds
INFO: [Project 1-570] Preparing netlist for logic optimization
INFO: [Opt 31-138] Pushed 0 inverter(s) to 0 load pin(s).
Netlist sorting complete. Time (s): cpu = 00:00:00 ; elapsed = 00:00:00 . Memory (MB): peak = 2908.887 ; gain = 0.000 ; free physical = 49742 ; free virtual = 63804
INFO: [Project 1-111] Unisim Transformation Summary:
No Unisim elements were transformed.

Synth Design complete | Checksum: b61e3204
INFO: [Common 17-83] Releasing license: Synthesis
45 Infos, 23 Warnings, 0 Critical Warnings and 0 Errors encountered.
synth_design completed successfully
synth_design: Time (s): cpu = 00:00:21 ; elapsed = 00:00:19 . Memory (MB): peak = 2911.855 ; gain = 1170.637 ; free physical = 49740 ; free virtual = 63803
INFO: [Common 17-2834] synth_design peak Physical Memory [PSS] (MB): overall = 2020.280; main = 2020.280; forked = 286.997
INFO: [Common 17-2834] synth_design peak Virtual Memory [VSS] (MB): overall = 3632.938; main = 2911.859; forked = 1078.371
Parsing XDC File [/home/boksop/swcell/fpga/projects/diagnostics/oled_keys/constraints/io.xdc]
Finished Parsing XDC File [/home/boksop/swcell/fpga/projects/diagnostics/oled_keys/constraints/io.xdc]
INFO: [Timing 38-35] Done setting XDC timing constraints.
INFO: [Timing 38-91] UpdateTimingParams: Speed grade: -2, Delay Type: min_max.
INFO: [Timing 38-191] Multithreading enabled for timing update using a maximum of 8 CPUs
Command: report_drc -checks LUTLP-1 -file /home/boksop/swcell/build/fpga/m20/autonomous/restart_plus_r2/feedback_drc.rpt
INFO: [DRC 23-27] Running DRC with 8 threads
INFO: [Vivado_Tcl 2-168] The results of DRC are in file /home/boksop/swcell/build/fpga/m20/autonomous/restart_plus_r2/feedback_drc.rpt.
report_drc completed successfully
Command: opt_design
Attempting to get a license for feature 'Implementation' and/or device 'xc7k325t'
INFO: [Common 17-349] Got license for feature 'Implementation' and/or device 'xc7k325t'
Running DRC as a precondition to command opt_design

Starting DRC Task
INFO: [DRC 23-27] Running DRC with 8 threads
INFO: [Project 1-461] DRC finished with 0 Errors
INFO: [Project 1-462] Please refer to the DRC report (report_drc) for more information.

Time (s): cpu = 00:00:00.86 ; elapsed = 00:00:00.43 . Memory (MB): peak = 2975.887 ; gain = 0.000 ; free physical = 49742 ; free virtual = 63822

Starting Cache Timing Information Task
Ending Cache Timing Information Task | Checksum: 1e5590314

Time (s): cpu = 00:00:00 ; elapsed = 00:00:00 . Memory (MB): peak = 2975.887 ; gain = 0.000 ; free physical = 49742 ; free virtual = 63822

Starting Logic Optimization Task

Phase 1 Initialization

Phase 1.1 Core Generation And Design Setup
Phase 1.1 Core Generation And Design Setup | Checksum: 1e5590314

Time (s): cpu = 00:00:00 ; elapsed = 00:00:00.01 . Memory (MB): peak = 3162.824 ; gain = 0.000 ; free physical = 49590 ; free virtual = 63657

Phase 1.2 Setup Constraints And Sort Netlist
Phase 1.2 Setup Constraints And Sort Netlist | Checksum: 1e5590314

Time (s): cpu = 00:00:00 ; elapsed = 00:00:00.01 . Memory (MB): peak = 3162.824 ; gain = 0.000 ; free physical = 49590 ; free virtual = 63657
Phase 1 Initialization | Checksum: 1e5590314

Time (s): cpu = 00:00:00 ; elapsed = 00:00:00.01 . Memory (MB): peak = 3162.824 ; gain = 0.000 ; free physical = 49590 ; free virtual = 63657

Phase 2 Timer Update And Timing Data Collection

Phase 2.1 Detect if minReqCache needed
Phase 2.1 Detect if minReqCache needed | Checksum: 1e5590314

Time (s): cpu = 00:00:00.01 ; elapsed = 00:00:00.01 . Memory (MB): peak = 3162.824 ; gain = 0.000 ; free physical = 49590 ; free virtual = 63657

Phase 2.2 Timer Update
Phase 2.2 Timer Update | Checksum: 1e5590314

Time (s): cpu = 00:00:00.07 ; elapsed = 00:00:00.03 . Memory (MB): peak = 3162.824 ; gain = 0.000 ; free physical = 49590 ; free virtual = 63657

Phase 2.3 Timing Data Collection
Phase 2.3 Timing Data Collection | Checksum: 1e5590314

Time (s): cpu = 00:00:00.07 ; elapsed = 00:00:00.03 . Memory (MB): peak = 3162.824 ; gain = 0.000 ; free physical = 49590 ; free virtual = 63657
Phase 2 Timer Update And Timing Data Collection | Checksum: 1e5590314

Time (s): cpu = 00:00:00.07 ; elapsed = 00:00:00.03 . Memory (MB): peak = 3162.824 ; gain = 0.000 ; free physical = 49590 ; free virtual = 63657

Phase 3 Retarget
INFO: [Opt 31-1851] Number of loadless carry chains removed were: 0
INFO: [Opt 31-1834] Total Chains To Be Transformed Were: 0 AND Number of Transformed insts Created are: 0
INFO: [Opt 31-138] Pushed 2 inverter(s) to 24 load pin(s).
INFO: [Opt 31-49] Retargeted 0 cell(s).
Phase 3 Retarget | Checksum: 1f28073ae

Time (s): cpu = 00:00:00.1 ; elapsed = 00:00:00.06 . Memory (MB): peak = 3162.824 ; gain = 0.000 ; free physical = 49590 ; free virtual = 63657
Retarget | Checksum: 1f28073ae
INFO: [Opt 31-389] Phase Retarget created 0 cells and removed 2 cells
INFO: [Opt 31-1021] In phase Retarget, 1 netlist objects are constrained preventing optimization. Please run opt_design with -debug_log to get more detail. 

Phase 4 Constant propagation
INFO: [Opt 31-138] Pushed 0 inverter(s) to 0 load pin(s).
Phase 4 Constant propagation | Checksum: 1f28073ae

Time (s): cpu = 00:00:00.11 ; elapsed = 00:00:00.07 . Memory (MB): peak = 3162.824 ; gain = 0.000 ; free physical = 49590 ; free virtual = 63657
Constant propagation | Checksum: 1f28073ae
INFO: [Opt 31-389] Phase Constant propagation created 0 cells and removed 0 cells

Phase 5 Sweep
INFO: [Constraints 18-11670] Building netlist checker database with flags, 0x8
Done building netlist checker database: Time (s): cpu = 00:00:00 ; elapsed = 00:00:00 . Memory (MB): peak = 3162.824 ; gain = 0.000 ; free physical = 49590 ; free virtual = 63657
INFO: [Constraints 18-11670] Building netlist checker database with flags, 0x8
Done building netlist checker database: Time (s): cpu = 00:00:00 ; elapsed = 00:00:00 . Memory (MB): peak = 3162.824 ; gain = 0.000 ; free physical = 49590 ; free virtual = 63657
Phase 5 Sweep | Checksum: 15f705ad8

Time (s): cpu = 00:00:00.13 ; elapsed = 00:00:00.09 . Memory (MB): peak = 3162.824 ; gain = 0.000 ; free physical = 49590 ; free virtual = 63657
Sweep | Checksum: 15f705ad8
INFO: [Opt 31-389] Phase Sweep created 0 cells and removed 0 cells
INFO: [Opt 31-1021] In phase Sweep, 477 netlist objects are constrained preventing optimization. Please run opt_design with -debug_log to get more detail. 

Phase 6 BUFG optimization
Phase 6 BUFG optimization | Checksum: 15f705ad8

Time (s): cpu = 00:00:00.15 ; elapsed = 00:00:00.1 . Memory (MB): peak = 3194.840 ; gain = 32.016 ; free physical = 49590 ; free virtual = 63657
BUFG optimization | Checksum: 15f705ad8
INFO: [Opt 31-662] Phase BUFG optimization created 0 cells of which 0 are BUFGs and removed 0 cells.

Phase 7 Shift Register Optimization
INFO: [Opt 31-1064] SRL Remap converted 0 SRLs to 0 registers and converted 0 registers of register chains to 0 SRLs
Phase 7 Shift Register Optimization | Checksum: 15f705ad8

Time (s): cpu = 00:00:00.15 ; elapsed = 00:00:00.1 . Memory (MB): peak = 3194.840 ; gain = 32.016 ; free physical = 49590 ; free virtual = 63657
Shift Register Optimization | Checksum: 15f705ad8
INFO: [Opt 31-389] Phase Shift Register Optimization created 0 cells and removed 0 cells

Phase 8 Post Processing Netlist
Phase 8 Post Processing Netlist | Checksum: 15f705ad8

Time (s): cpu = 00:00:00.16 ; elapsed = 00:00:00.11 . Memory (MB): peak = 3194.840 ; gain = 32.016 ; free physical = 49590 ; free virtual = 63657
Post Processing Netlist | Checksum: 15f705ad8
INFO: [Opt 31-389] Phase Post Processing Netlist created 0 cells and removed 0 cells

Phase 9 Finalization

Phase 9.1 Finalizing Design Cores and Updating Shapes
Phase 9.1 Finalizing Design Cores and Updating Shapes | Checksum: 16cf85615

Time (s): cpu = 00:00:00.19 ; elapsed = 00:00:00.14 . Memory (MB): peak = 3194.840 ; gain = 32.016 ; free physical = 49589 ; free virtual = 63656

Phase 9.2 Verifying Netlist Connectivity

Starting Connectivity Check Task

Time (s): cpu = 00:00:00 ; elapsed = 00:00:00 . Memory (MB): peak = 3194.840 ; gain = 0.000 ; free physical = 49589 ; free virtual = 63656
Phase 9.2 Verifying Netlist Connectivity | Checksum: 16cf85615

Time (s): cpu = 00:00:00.19 ; elapsed = 00:00:00.14 . Memory (MB): peak = 3194.840 ; gain = 32.016 ; free physical = 49589 ; free virtual = 63656
Phase 9 Finalization | Checksum: 16cf85615

Time (s): cpu = 00:00:00.19 ; elapsed = 00:00:00.14 . Memory (MB): peak = 3194.840 ; gain = 32.016 ; free physical = 49589 ; free virtual = 63656
Opt_design Change Summary
=========================

-------------------------------------------------------------------------------------------------------------------------
|  Phase                        |  #Cells created  |  #Cells Removed  |  #Constrained objects preventing optimizations  |
-------------------------------------------------------------------------------------------------------------------------
|  Retarget                     |               0  |               2  |                                              1  |
|  Constant propagation         |               0  |               0  |                                              0  |
|  Sweep                        |               0  |               0  |                                            477  |
|  BUFG optimization            |               0  |               0  |                                              0  |
|  Shift Register Optimization  |               0  |               0  |                                              0  |
|  Post Processing Netlist      |               0  |               0  |                                              0  |
-------------------------------------------------------------------------------------------------------------------------

Ending Logic Optimization Task | Checksum: 16cf85615

Time (s): cpu = 00:00:00.19 ; elapsed = 00:00:00.14 . Memory (MB): peak = 3194.840 ; gain = 32.016 ; free physical = 49589 ; free virtual = 63656

Starting Power Optimization Task
INFO: [Pwropt 34-132] Skipping clock gating for clocks with a period < 2.00 ns.
INFO: [Pwropt 34-9] Applying IDT optimizations ...
INFO: [Pwropt 34-10] Applying ODC optimizations ...
INFO: [Timing 38-35] Done setting XDC timing constraints.
Running Vector-less Activity Propagation...

Finished Running Vector-less Activity Propagation

Starting PowerOpt Patch Enables Task
INFO: [Pwropt 34-162] WRITE_MODE attribute of 0 BRAM(s) out of a total of 3 has been updated to save power. Run report_power_opt to get a complete listing of the BRAMs updated.
INFO: [Pwropt 34-201] Structural ODC has moved 0 WE to EN ports
Number of BRAM Ports augmented: 3 newly gated: 0 Total Ports: 6
Number of Flops added for Enable Generation: 2

Ending PowerOpt Patch Enables Task | Checksum: 170357324

Time (s): cpu = 00:00:00.06 ; elapsed = 00:00:00.02 . Memory (MB): peak = 3402.930 ; gain = 0.000 ; free physical = 49540 ; free virtual = 63610
Ending Power Optimization Task | Checksum: 170357324

Time (s): cpu = 00:00:01 ; elapsed = 00:00:00.65 . Memory (MB): peak = 3402.930 ; gain = 208.090 ; free physical = 49540 ; free virtual = 63610

Starting Final Cleanup Task

Starting Logic Optimization Task
INFO: [Timing 38-35] Done setting XDC timing constraints.
Ending Logic Optimization Task | Checksum: 19e191f27

Time (s): cpu = 00:00:00.21 ; elapsed = 00:00:00.09 . Memory (MB): peak = 3402.930 ; gain = 0.000 ; free physical = 49537 ; free virtual = 63604
Ending Final Cleanup Task | Checksum: 19e191f27

Time (s): cpu = 00:00:02 ; elapsed = 00:00:02 . Memory (MB): peak = 3402.930 ; gain = 0.000 ; free physical = 49537 ; free virtual = 63604
Netlist sorting complete. Time (s): cpu = 00:00:00 ; elapsed = 00:00:00 . Memory (MB): peak = 3402.930 ; gain = 0.000 ; free physical = 49537 ; free virtual = 63604
INFO: [Common 17-83] Releasing license: Implementation
80 Infos, 23 Warnings, 0 Critical Warnings and 0 Errors encountered.
opt_design completed successfully
opt_design: Time (s): cpu = 00:00:07 ; elapsed = 00:00:06 . Memory (MB): peak = 3402.930 ; gain = 427.043 ; free physical = 49537 ; free virtual = 63604
Command: place_design
Attempting to get a license for feature 'Implementation' and/or device 'xc7k325t'
INFO: [Common 17-349] Got license for feature 'Implementation' and/or device 'xc7k325t'
INFO: [Common 17-83] Releasing license: Implementation
INFO: [Timing 38-35] Done setting XDC timing constraints.
Running DRC as a precondition to command place_design
INFO: [DRC 23-27] Running DRC with 8 threads
INFO: [Vivado_Tcl 4-198] DRC finished with 0 Errors
INFO: [Vivado_Tcl 4-199] Please refer to the DRC report (report_drc) for more information.
INFO: [Place 30-611] Multithreading enabled for place_design using a maximum of 8 CPUs

Starting Placer Task

Phase 1 Placer Initialization

Phase 1.1 Placer Initialization Netlist Sorting
Netlist sorting complete. Time (s): cpu = 00:00:00.01 ; elapsed = 00:00:00 . Memory (MB): peak = 3402.930 ; gain = 0.000 ; free physical = 49539 ; free virtual = 63606
Phase 1.1 Placer Initialization Netlist Sorting | Checksum: 11bbd6a4d

Time (s): cpu = 00:00:00.01 ; elapsed = 00:00:00 . Memory (MB): peak = 3402.930 ; gain = 0.000 ; free physical = 49539 ; free virtual = 63606
Netlist sorting complete. Time (s): cpu = 00:00:00 ; elapsed = 00:00:00 . Memory (MB): peak = 3402.930 ; gain = 0.000 ; free physical = 49539 ; free virtual = 63606

Phase 1.2 IO Placement/ Clock Placement/ Build Placer Device
Phase 1.2 IO Placement/ Clock Placement/ Build Placer Device | Checksum: 9c0d6403

Time (s): cpu = 00:00:00.84 ; elapsed = 00:00:00.37 . Memory (MB): peak = 3402.930 ; gain = 0.000 ; free physical = 49541 ; free virtual = 63608

Phase 1.3 Build Placer Netlist Model
Phase 1.3 Build Placer Netlist Model | Checksum: 178ed2d97

Time (s): cpu = 00:00:02 ; elapsed = 00:00:00.62 . Memory (MB): peak = 3402.930 ; gain = 0.000 ; free physical = 49541 ; free virtual = 63608

Phase 1.4 Constrain Clocks/Macros
Phase 1.4 Constrain Clocks/Macros | Checksum: 178ed2d97

Time (s): cpu = 00:00:02 ; elapsed = 00:00:00.62 . Memory (MB): peak = 3402.930 ; gain = 0.000 ; free physical = 49541 ; free virtual = 63608
Phase 1 Placer Initialization | Checksum: 178ed2d97

Time (s): cpu = 00:00:02 ; elapsed = 00:00:00.63 . Memory (MB): peak = 3402.930 ; gain = 0.000 ; free physical = 49541 ; free virtual = 63608

Phase 2 Global Placement

Phase 2.1 Floorplanning
Phase 2.1 Floorplanning | Checksum: d5ba1079

Time (s): cpu = 00:00:02 ; elapsed = 00:00:00.73 . Memory (MB): peak = 3402.930 ; gain = 0.000 ; free physical = 49532 ; free virtual = 63600

Phase 2.2 Update Timing before SLR Path Opt
Phase 2.2 Update Timing before SLR Path Opt | Checksum: 150257552

Time (s): cpu = 00:00:02 ; elapsed = 00:00:00.8 . Memory (MB): peak = 3402.930 ; gain = 0.000 ; free physical = 49570 ; free virtual = 63637

Phase 2.3 Post-Processing in Floorplanning
Phase 2.3 Post-Processing in Floorplanning | Checksum: 150257552

Time (s): cpu = 00:00:02 ; elapsed = 00:00:00.81 . Memory (MB): peak = 3402.930 ; gain = 0.000 ; free physical = 49570 ; free virtual = 63637

Phase 2.4 Global Place Phase1
Phase 2.4 Global Place Phase1 | Checksum: 250638cc1

Time (s): cpu = 00:00:07 ; elapsed = 00:00:02 . Memory (MB): peak = 3402.930 ; gain = 0.000 ; free physical = 49479 ; free virtual = 63541

Phase 2.5 Global Place Phase2

Phase 2.5.1 UpdateTiming Before Physical Synthesis
Phase 2.5.1 UpdateTiming Before Physical Synthesis | Checksum: 250638cc1

Time (s): cpu = 00:00:07 ; elapsed = 00:00:02 . Memory (MB): peak = 3402.930 ; gain = 0.000 ; free physical = 49478 ; free virtual = 63540

Phase 2.5.2 Physical Synthesis In Placer
INFO: [Physopt 32-1035] Found 0 LUTNM shape to break, 460 LUT instances to create LUTNM shape
INFO: [Physopt 32-1044] Break lutnm for timing: one critical 0, two critical 0, total 0, new lutff created 0
INFO: [Physopt 32-1138] End 1 Pass. Optimized 227 nets or LUTs. Breaked 0 LUT, combined 227 existing LUTs and moved 0 existing LUT
INFO: [Physopt 32-65] No nets found for high-fanout optimization.
INFO: [Physopt 32-232] Optimized 0 net. Created 0 new instance.
INFO: [Physopt 32-775] End 1 Pass. Optimized 0 net or cell. Created 0 new cell, deleted 0 existing cell and moved 0 existing cell
INFO: [Physopt 32-670] No setup violation found.  DSP Register Optimization was not performed.
INFO: [Physopt 32-670] No setup violation found.  Shift Register to Pipeline Optimization was not performed.
INFO: [Physopt 32-670] No setup violation found.  Shift Register Optimization was not performed.
INFO: [Physopt 32-670] No setup violation found.  BRAM Register Optimization was not performed.
INFO: [Physopt 32-670] No setup violation found.  URAM Register Optimization was not performed.
INFO: [Physopt 32-949] No candidate nets found for dynamic/static region interface net replication
INFO: [Physopt 32-775] End 1 Pass. Optimized 0 net or cell. Created 0 new cell, deleted 0 existing cell and moved 0 existing cell
Netlist sorting complete. Time (s): cpu = 00:00:00 ; elapsed = 00:00:00 . Memory (MB): peak = 3402.930 ; gain = 0.000 ; free physical = 49474 ; free virtual = 63536

Summary of Physical Synthesis Optimizations
============================================

-----------------------------------------------------------------------------------------------------------------------------------------------------------
|  Optimization                                     |  Added Cells  |  Removed Cells  |  Optimized Cells/Nets  |  Dont Touch  |  Iterations  |  Elapsed   |
-----------------------------------------------------------------------------------------------------------------------------------------------------------
|  LUT Combining                                    |            0  |            227  |                   227  |           0  |           1  |  00:00:00  |
|  Retime                                           |            0  |              0  |                     0  |           0  |           1  |  00:00:00  |
|  Very High Fanout                                 |            0  |              0  |                     0  |           0  |           1  |  00:00:00  |
|  DSP Register                                     |            0  |              0  |                     0  |           0  |           0  |  00:00:00  |
|  Shift Register to Pipeline                       |            0  |              0  |                     0  |           0  |           0  |  00:00:00  |
|  Shift Register                                   |            0  |              0  |                     0  |           0  |           0  |  00:00:00  |
|  BRAM Register                                    |            0  |              0  |                     0  |           0  |           0  |  00:00:00  |
|  URAM Register                                    |            0  |              0  |                     0  |           0  |           0  |  00:00:00  |
|  Dynamic/Static Region Interface Net Replication  |            0  |              0  |                     0  |           0  |           1  |  00:00:00  |
|  Total                                            |            0  |            227  |                   227  |           0  |           4  |  00:00:00  |
-----------------------------------------------------------------------------------------------------------------------------------------------------------

Phase 2.5.2 Physical Synthesis In Placer | Checksum: 1dcb88623

Time (s): cpu = 00:00:08 ; elapsed = 00:00:03 . Memory (MB): peak = 3402.930 ; gain = 0.000 ; free physical = 49473 ; free virtual = 63535
Phase 2.5 Global Place Phase2 | Checksum: 1ee100d80

Time (s): cpu = 00:00:09 ; elapsed = 00:00:03 . Memory (MB): peak = 3402.930 ; gain = 0.000 ; free physical = 49471 ; free virtual = 63534
Phase 2 Global Placement | Checksum: 1ee100d80

Time (s): cpu = 00:00:09 ; elapsed = 00:00:03 . Memory (MB): peak = 3402.930 ; gain = 0.000 ; free physical = 49471 ; free virtual = 63534

Phase 3 Detail Placement

Phase 3.1 Commit Multi Column Macros
Phase 3.1 Commit Multi Column Macros | Checksum: 1c3bb64ef

Time (s): cpu = 00:00:09 ; elapsed = 00:00:03 . Memory (MB): peak = 3402.930 ; gain = 0.000 ; free physical = 49471 ; free virtual = 63531

Phase 3.2 Commit Most Macros & LUTRAMs
Phase 3.2 Commit Most Macros & LUTRAMs | Checksum: 11c849670

Time (s): cpu = 00:00:10 ; elapsed = 00:00:03 . Memory (MB): peak = 3402.930 ; gain = 0.000 ; free physical = 49470 ; free virtual = 63530

Phase 3.3 Area Swap Optimization
Phase 3.3 Area Swap Optimization | Checksum: cc807521

Time (s): cpu = 00:00:10 ; elapsed = 00:00:03 . Memory (MB): peak = 3402.930 ; gain = 0.000 ; free physical = 49470 ; free virtual = 63529

Phase 3.4 Pipeline Register Optimization
Phase 3.4 Pipeline Register Optimization | Checksum: 119137379

Time (s): cpu = 00:00:10 ; elapsed = 00:00:03 . Memory (MB): peak = 3402.930 ; gain = 0.000 ; free physical = 49470 ; free virtual = 63529

Phase 3.5 Small Shape Detail Placement
Phase 3.5 Small Shape Detail Placement | Checksum: 1cc6e15f2

Time (s): cpu = 00:00:11 ; elapsed = 00:00:04 . Memory (MB): peak = 3402.930 ; gain = 0.000 ; free physical = 49467 ; free virtual = 63527

Phase 3.6 Re-assign LUT pins
Phase 3.6 Re-assign LUT pins | Checksum: 10a569b72

Time (s): cpu = 00:00:11 ; elapsed = 00:00:04 . Memory (MB): peak = 3402.930 ; gain = 0.000 ; free physical = 49467 ; free virtual = 63527

Phase 3.7 Pipeline Register Optimization
Phase 3.7 Pipeline Register Optimization | Checksum: 15cd39d1a

Time (s): cpu = 00:00:11 ; elapsed = 00:00:04 . Memory (MB): peak = 3402.930 ; gain = 0.000 ; free physical = 49467 ; free virtual = 63527
Phase 3 Detail Placement | Checksum: 15cd39d1a

Time (s): cpu = 00:00:11 ; elapsed = 00:00:04 . Memory (MB): peak = 3402.930 ; gain = 0.000 ; free physical = 49467 ; free virtual = 63527

Phase 4 Post Placement Optimization and Clean-Up

Phase 4.1 Post Commit Optimization
INFO: [Timing 38-35] Done setting XDC timing constraints.

Phase 4.1.1 Post Placement Optimization
Post Placement Optimization Initialization | Checksum: 1da7c9f70

Phase 4.1.1.1 BUFG Insertion

Starting Physical Synthesis Task

Phase 1 Physical Synthesis Initialization
INFO: [Physopt 32-721] Multithreading enabled for phys_opt_design using a maximum of 8 CPUs
INFO: [Physopt 32-619] Estimated Timing Summary | WNS=2.749 | TNS=0.000 |
Phase 1 Physical Synthesis Initialization | Checksum: 228a54a0a

Time (s): cpu = 00:00:00.06 ; elapsed = 00:00:00.03 . Memory (MB): peak = 3402.930 ; gain = 0.000 ; free physical = 49463 ; free virtual = 63524
INFO: [Place 46-56] BUFG insertion identified 0 candidate nets. Inserted BUFG: 0, Replicated BUFG Driver: 0, Skipped due to Placement/Routing Conflicts: 0, Skipped due to Timing Degradation: 0, Skipped due to netlist editing failed: 0.
Ending Physical Synthesis Task | Checksum: 187760e49

Time (s): cpu = 00:00:00.07 ; elapsed = 00:00:00.04 . Memory (MB): peak = 3402.930 ; gain = 0.000 ; free physical = 49463 ; free virtual = 63524
Phase 4.1.1.1 BUFG Insertion | Checksum: 1da7c9f70

Time (s): cpu = 00:00:11 ; elapsed = 00:00:04 . Memory (MB): peak = 3402.930 ; gain = 0.000 ; free physical = 49463 ; free virtual = 63524

Phase 4.1.1.2 Post Placement Timing Optimization
INFO: [Place 30-746] Post Placement Timing Summary WNS=2.749. For the most accurate timing information please run report_timing.
Phase 4.1.1.2 Post Placement Timing Optimization | Checksum: 1ffa1fca2

Time (s): cpu = 00:00:11 ; elapsed = 00:00:04 . Memory (MB): peak = 3402.930 ; gain = 0.000 ; free physical = 49455 ; free virtual = 63524

Time (s): cpu = 00:00:11 ; elapsed = 00:00:04 . Memory (MB): peak = 3402.930 ; gain = 0.000 ; free physical = 49455 ; free virtual = 63524
Phase 4.1 Post Commit Optimization | Checksum: 1ffa1fca2

Time (s): cpu = 00:00:11 ; elapsed = 00:00:04 . Memory (MB): peak = 3402.930 ; gain = 0.000 ; free physical = 49455 ; free virtual = 63524

Phase 4.2 Post Placement Cleanup
Phase 4.2 Post Placement Cleanup | Checksum: 1ffa1fca2

Time (s): cpu = 00:00:11 ; elapsed = 00:00:04 . Memory (MB): peak = 3402.930 ; gain = 0.000 ; free physical = 49455 ; free virtual = 63524

Phase 4.3 Placer Reporting

Phase 4.3.1 Print Estimated Congestion
INFO: [Place 30-612] Post-Placement Estimated Congestion 
 ____________________________________________________
|           | Global Congestion | Short Congestion  |
| Direction | Region Size       | Region Size       |
|___________|___________________|___________________|
|      North|                1x1|                1x1|
|___________|___________________|___________________|
|      South|                1x1|                1x1|
|___________|___________________|___________________|
|       East|                1x1|                1x1|
|___________|___________________|___________________|
|       West|                1x1|                1x1|
|___________|___________________|___________________|

Phase 4.3.1 Print Estimated Congestion | Checksum: 1ffa1fca2

Time (s): cpu = 00:00:12 ; elapsed = 00:00:04 . Memory (MB): peak = 3402.930 ; gain = 0.000 ; free physical = 49455 ; free virtual = 63524
Phase 4.3 Placer Reporting | Checksum: 1ffa1fca2

Time (s): cpu = 00:00:12 ; elapsed = 00:00:04 . Memory (MB): peak = 3402.930 ; gain = 0.000 ; free physical = 49455 ; free virtual = 63524

Phase 4.4 Final Placement Cleanup
Netlist sorting complete. Time (s): cpu = 00:00:00.01 ; elapsed = 00:00:00 . Memory (MB): peak = 3402.930 ; gain = 0.000 ; free physical = 49455 ; free virtual = 63524

Time (s): cpu = 00:00:12 ; elapsed = 00:00:04 . Memory (MB): peak = 3402.930 ; gain = 0.000 ; free physical = 49455 ; free virtual = 63524
Phase 4 Post Placement Optimization and Clean-Up | Checksum: 1bd786632

Time (s): cpu = 00:00:12 ; elapsed = 00:00:04 . Memory (MB): peak = 3402.930 ; gain = 0.000 ; free physical = 49455 ; free virtual = 63524
Ending Placer Task | Checksum: c2f0c2ff

Time (s): cpu = 00:00:12 ; elapsed = 00:00:04 . Memory (MB): peak = 3402.930 ; gain = 0.000 ; free physical = 49455 ; free virtual = 63524
106 Infos, 23 Warnings, 0 Critical Warnings and 0 Errors encountered.
place_design completed successfully
Command: route_design
Attempting to get a license for feature 'Implementation' and/or device 'xc7k325t'
INFO: [Common 17-349] Got license for feature 'Implementation' and/or device 'xc7k325t'

Starting Routing Task
INFO: [Route 35-254] Multithreading enabled for route_design using a maximum of 8 CPUs

Phase 1 Build RT Design
Checksum: PlaceDB: bb78ff0 ConstDB: 0 ShapeSum: 8ebdb8bf RouteDB: 287b7a50
Post Restoration Checksum: NetGraph: 6704ff5 | NumContArr: 4e423e2d | Constraints: c2a8fa9d | Timing: c2a8fa9d
Phase 1 Build RT Design | Checksum: 1da04835c

Time (s): cpu = 00:00:25 ; elapsed = 00:00:18 . Memory (MB): peak = 3402.930 ; gain = 0.000 ; free physical = 49558 ; free virtual = 63622

Phase 2 Router Initialization

Phase 2.1 Fix Topology Constraints
Phase 2.1 Fix Topology Constraints | Checksum: 1da04835c

Time (s): cpu = 00:00:25 ; elapsed = 00:00:18 . Memory (MB): peak = 3402.930 ; gain = 0.000 ; free physical = 49558 ; free virtual = 63622

Phase 2.2 Pre Route Cleanup
Phase 2.2 Pre Route Cleanup | Checksum: 1da04835c

Time (s): cpu = 00:00:25 ; elapsed = 00:00:18 . Memory (MB): peak = 3402.930 ; gain = 0.000 ; free physical = 49558 ; free virtual = 63622
 Number of Nodes with overlaps = 0

Phase 2.3 Update Timing
Phase 2.3 Update Timing | Checksum: 1e34d431c

Time (s): cpu = 00:00:27 ; elapsed = 00:00:18 . Memory (MB): peak = 3402.930 ; gain = 0.000 ; free physical = 49485 ; free virtual = 63558
INFO: [Route 35-416] Intermediate Timing Summary | WNS=2.575  | TNS=0.000  | WHS=-0.231 | THS=-62.985|

Phase 2.4 Soft Constraint Pins - Fast Budgeting
Phase 2.4 Soft Constraint Pins - Fast Budgeting | Checksum: 1ac0afcf0

Time (s): cpu = 00:00:27 ; elapsed = 00:00:18 . Memory (MB): peak = 3402.930 ; gain = 0.000 ; free physical = 49485 ; free virtual = 63558

Router Utilization Summary
  Global Vertical Routing Utilization    = 0 %
  Global Horizontal Routing Utilization  = 0 %
  Routable Net Status*
  *Does not include unroutable nets such as driverless and loadless.
  Run report_route_status for detailed report.
  Number of Failed Nets               = 1926
    (Failed Nets is the sum of unrouted and partially routed nets)
  Number of Unrouted Nets             = 1926
  Number of Partially Routed Nets     = 0
  Number of Node Overlaps             = 0

Phase 2 Router Initialization | Checksum: 1e9f3b60f

Time (s): cpu = 00:00:29 ; elapsed = 00:00:18 . Memory (MB): peak = 3402.930 ; gain = 0.000 ; free physical = 49482 ; free virtual = 63555

Phase 3 Global Routing
Phase 3 Global Routing | Checksum: 1e9f3b60f

Time (s): cpu = 00:00:29 ; elapsed = 00:00:18 . Memory (MB): peak = 3402.930 ; gain = 0.000 ; free physical = 49482 ; free virtual = 63555

Phase 4 Initial Routing

Phase 4.1 Initial Net Routing Pass
Phase 4.1 Initial Net Routing Pass | Checksum: 2c2d8777d

Time (s): cpu = 00:00:29 ; elapsed = 00:00:19 . Memory (MB): peak = 3402.930 ; gain = 0.000 ; free physical = 49482 ; free virtual = 63555
Phase 4 Initial Routing | Checksum: 2c2d8777d

Time (s): cpu = 00:00:29 ; elapsed = 00:00:19 . Memory (MB): peak = 3402.930 ; gain = 0.000 ; free physical = 49482 ; free virtual = 63555

Phase 5 Rip-up And Reroute

Phase 5.1 Global Iteration 0
 Number of Nodes with overlaps = 133
 Number of Nodes with overlaps = 27
 Number of Nodes with overlaps = 5
 Number of Nodes with overlaps = 1
 Number of Nodes with overlaps = 0
INFO: [Route 35-416] Intermediate Timing Summary | WNS=1.972  | TNS=0.000  | WHS=N/A    | THS=N/A    |

Phase 5.1 Global Iteration 0 | Checksum: 3946aa23f

Time (s): cpu = 00:00:31 ; elapsed = 00:00:19 . Memory (MB): peak = 3402.930 ; gain = 0.000 ; free physical = 49467 ; free virtual = 63559
Phase 5 Rip-up And Reroute | Checksum: 3946aa23f

Time (s): cpu = 00:00:31 ; elapsed = 00:00:19 . Memory (MB): peak = 3402.930 ; gain = 0.000 ; free physical = 49467 ; free virtual = 63559

Phase 6 Delay and Skew Optimization

Phase 6.1 Delay CleanUp
Phase 6.1 Delay CleanUp | Checksum: 3946aa23f

Time (s): cpu = 00:00:31 ; elapsed = 00:00:19 . Memory (MB): peak = 3402.930 ; gain = 0.000 ; free physical = 49467 ; free virtual = 63559

Phase 6.2 Clock Skew Optimization
Phase 6.2 Clock Skew Optimization | Checksum: 3946aa23f

Time (s): cpu = 00:00:31 ; elapsed = 00:00:19 . Memory (MB): peak = 3402.930 ; gain = 0.000 ; free physical = 49467 ; free virtual = 63559
Phase 6 Delay and Skew Optimization | Checksum: 3946aa23f

Time (s): cpu = 00:00:31 ; elapsed = 00:00:19 . Memory (MB): peak = 3402.930 ; gain = 0.000 ; free physical = 49467 ; free virtual = 63559

Phase 7 Post Hold Fix

Phase 7.1 Hold Fix Iter
INFO: [Route 35-416] Intermediate Timing Summary | WNS=1.972  | TNS=0.000  | WHS=0.091  | THS=0.000  |

Phase 7.1 Hold Fix Iter | Checksum: 2c9eb79d7

Time (s): cpu = 00:00:31 ; elapsed = 00:00:19 . Memory (MB): peak = 3402.930 ; gain = 0.000 ; free physical = 49470 ; free virtual = 63562
Phase 7 Post Hold Fix | Checksum: 2c9eb79d7

Time (s): cpu = 00:00:31 ; elapsed = 00:00:19 . Memory (MB): peak = 3402.930 ; gain = 0.000 ; free physical = 49470 ; free virtual = 63562

Phase 8 Route finalize

Router Utilization Summary
  Global Vertical Routing Utilization    = 0.0784422 %
  Global Horizontal Routing Utilization  = 0.0865215 %
  Routable Net Status*
  *Does not include unroutable nets such as driverless and loadless.
  Run report_route_status for detailed report.
  Number of Failed Nets               = 0
    (Failed Nets is the sum of unrouted and partially routed nets)
  Number of Unrouted Nets             = 0
  Number of Partially Routed Nets     = 0
  Number of Node Overlaps             = 0

Phase 8 Route finalize | Checksum: 2c9eb79d7

Time (s): cpu = 00:00:31 ; elapsed = 00:00:19 . Memory (MB): peak = 3402.930 ; gain = 0.000 ; free physical = 49470 ; free virtual = 63562

Phase 9 Verifying routed nets

 Verification completed successfully
Phase 9 Verifying routed nets | Checksum: 2c9eb79d7

Time (s): cpu = 00:00:31 ; elapsed = 00:00:19 . Memory (MB): peak = 3402.930 ; gain = 0.000 ; free physical = 49470 ; free virtual = 63562

Phase 10 Depositing Routes
Phase 10 Depositing Routes | Checksum: 2670f89ec

Time (s): cpu = 00:00:31 ; elapsed = 00:00:19 . Memory (MB): peak = 3402.930 ; gain = 0.000 ; free physical = 49469 ; free virtual = 63561

Phase 11 Post Process Routing
Phase 11 Post Process Routing | Checksum: 2670f89ec

Time (s): cpu = 00:00:31 ; elapsed = 00:00:19 . Memory (MB): peak = 3402.930 ; gain = 0.000 ; free physical = 49469 ; free virtual = 63561

Phase 12 Post Router Timing
INFO: [Route 35-57] Estimated Timing Summary | WNS=1.972  | TNS=0.000  | WHS=0.091  | THS=0.000  |

INFO: [Route 35-327] The final timing numbers are based on the router estimated timing analysis. For a complete and accurate timing signoff, please run report_timing_summary.
Phase 12 Post Router Timing | Checksum: 2670f89ec

Time (s): cpu = 00:00:31 ; elapsed = 00:00:20 . Memory (MB): peak = 3402.930 ; gain = 0.000 ; free physical = 49469 ; free virtual = 63561
Total Elapsed time in route_design: 19.5 secs

Phase 13 Post-Route Event Processing
Phase 13 Post-Route Event Processing | Checksum: 15885d5ff

Time (s): cpu = 00:00:31 ; elapsed = 00:00:20 . Memory (MB): peak = 3402.930 ; gain = 0.000 ; free physical = 49469 ; free virtual = 63561
INFO: [Route 35-16] Router Completed Successfully
Ending Routing Task | Checksum: 15885d5ff

Time (s): cpu = 00:00:31 ; elapsed = 00:00:20 . Memory (MB): peak = 3402.930 ; gain = 0.000 ; free physical = 49469 ; free virtual = 63561

Routing Is Done.
INFO: [Common 17-83] Releasing license: Implementation
115 Infos, 23 Warnings, 0 Critical Warnings and 0 Errors encountered.
route_design completed successfully
route_design: Time (s): cpu = 00:00:31 ; elapsed = 00:00:20 . Memory (MB): peak = 3402.930 ; gain = 0.000 ; free physical = 49469 ; free virtual = 63561
INFO: [Timing 38-91] UpdateTimingParams: Speed grade: -2, Delay Type: min_max.
INFO: [Timing 38-191] Multithreading enabled for timing update using a maximum of 8 CPUs
report_ram_utilization: Time (s): cpu = 00:00:00 ; elapsed = 00:00:00 . Memory (MB): peak = 3402.930 ; gain = 0.000 ; free physical = 49462 ; free virtual = 63554
report_io: Time (s): cpu = 00:00:00.12 ; elapsed = 00:00:00.15 . Memory (MB): peak = 3402.930 ; gain = 0.000 ; free physical = 49464 ; free virtual = 63553
INFO: [Timing 38-91] UpdateTimingParams: Speed grade: -2, Delay Type: min_max.
INFO: [Timing 38-191] Multithreading enabled for timing update using a maximum of 8 CPUs
INFO: [Timing 38-314] The report_cdc command only analyzes and reports clock domain crossing paths where clocks have been defined on both source and destination sides. Ports with no input delay constraint are skipped. Please run check_timing to verify there are no missing clock definitions in your design, nor any unconstrained input port.
Command: report_drc -file /home/boksop/swcell/build/fpga/m20/autonomous/restart_plus_r2/drc.rpt
INFO: [IP_Flow 19-234] Refreshing IP repositories
INFO: [IP_Flow 19-1704] No user IP repositories specified
INFO: [IP_Flow 19-2313] Loaded Vivado IP repository '/home/boksop/AMDDesignTools/2026.1.1/data/ip'.
INFO: [DRC 23-27] Running DRC with 8 threads
INFO: [Vivado_Tcl 2-168] The results of DRC are in file /home/boksop/swcell/build/fpga/m20/autonomous/restart_plus_r2/drc.rpt.
report_drc completed successfully
INFO: [Timing 38-480] Writing timing data to binary archive.
Wrote PlaceDB: Time (s): cpu = 00:00:00 ; elapsed = 00:00:00 . Memory (MB): peak = 3402.930 ; gain = 0.000 ; free physical = 49471 ; free virtual = 63560
Wrote PulsedLatchDB: Time (s): cpu = 00:00:00 ; elapsed = 00:00:00 . Memory (MB): peak = 3402.930 ; gain = 0.000 ; free physical = 49471 ; free virtual = 63560
Writing XDEF routing.
Write ShapeDB Complete: Time (s): cpu = 00:00:00.03 ; elapsed = 00:00:00.01 . Memory (MB): peak = 3402.930 ; gain = 0.000 ; free physical = 49471 ; free virtual = 63560
Writing XDEF routing logical nets.
Writing XDEF routing special nets.
Wrote RouteStorage: Time (s): cpu = 00:00:00.12 ; elapsed = 00:00:00.03 . Memory (MB): peak = 3402.930 ; gain = 0.000 ; free physical = 49470 ; free virtual = 63559
Wrote PlaceStorage: Time (s): cpu = 00:00:00.09 ; elapsed = 00:00:00.03 . Memory (MB): peak = 3402.930 ; gain = 0.000 ; free physical = 49470 ; free virtual = 63561
Wrote Netlist Cache: Time (s): cpu = 00:00:00 ; elapsed = 00:00:00 . Memory (MB): peak = 3402.930 ; gain = 0.000 ; free physical = 49470 ; free virtual = 63561
Wrote Device Cache: Time (s): cpu = 00:00:00 ; elapsed = 00:00:00.01 . Memory (MB): peak = 3402.930 ; gain = 0.000 ; free physical = 49469 ; free virtual = 63561
Write Physdb Complete: Time (s): cpu = 00:00:00.22 ; elapsed = 00:00:00.07 . Memory (MB): peak = 3402.930 ; gain = 0.000 ; free physical = 49469 ; free virtual = 63561
INFO: [Common 17-1381] The checkpoint '/home/boksop/swcell/build/fpga/m20/autonomous/restart_plus_r2/routed.dcp' has been generated.
Command: write_bitstream /home/boksop/swcell/build/fpga/m20/autonomous/restart_plus_r2/swcell_m20_v31_top.bit
Attempting to get a license for feature 'Implementation' and/or device 'xc7k325t'
INFO: [Common 17-349] Got license for feature 'Implementation' and/or device 'xc7k325t'
Running DRC as a precondition to command write_bitstream
INFO: [IP_Flow 19-1839] IP Catalog is up to date.
INFO: [DRC 23-27] Running DRC with 8 threads
INFO: [Vivado 12-3199] DRC finished with 0 Errors
INFO: [Vivado 12-3200] Please refer to the DRC report (report_drc) for more information.
Integrating Hard IP ELF/MEM with the PDI.
INFO: [Designutils 20-2272] Running write_bitstream with 8 threads.
Initializing bitstream generation complete. Time (s): cpu = 00:00:00.44 ; elapsed = 00:00:00.45 . Memory (MB): peak = 3402.930 ; gain = 0.000 ; free physical = 49512 ; free virtual = 63586
Loading data files...
Loading site data...
Loading route data...
Processing options...
Creating bitmap...
Creating bitstream...
Bitstream compression saved 81046976 bits.
Writing bitstream /home/boksop/swcell/build/fpga/m20/autonomous/restart_plus_r2/swcell_m20_v31_top.bit...
Generate Bitstream complete. Time (s): cpu = 00:00:10 ; elapsed = 00:00:05 . Memory (MB): peak = 3619.414 ; gain = 216.484 ; free physical = 49207 ; free virtual = 63278
INFO: [Vivado 12-1842] Bitgen Completed Successfully.
INFO: [Common 17-83] Releasing license: Implementation
135 Infos, 23 Warnings, 0 Critical Warnings and 0 Errors encountered.
write_bitstream completed successfully
write_bitstream: Time (s): cpu = 00:00:13 ; elapsed = 00:00:38 . Memory (MB): peak = 3619.523 ; gain = 216.594 ; free physical = 49208 ; free virtual = 63271
M20_V31_BITSTREAM_PASS /home/boksop/swcell/build/fpga/m20/autonomous/restart_plus_r2/swcell_m20_v31_top.bit
# exit 0
INFO: [Common 17-206] Exiting Vivado at Thu Nov  5 12:27:05 2026...
