boksop/swcell/docs/m20/M20_HARDWARE_VALIDATION_PLAN.md

# M20：分级实物验证计划

2026-11-02。计划ESTIMATED，以下物理验收全部NOT_RUN。本轮没有PCB或实物测试。

|级别|样件/任务|进入下一阶段的完成条件|
|---|---|---|
|P0|正式MUX图、参数/长短路径/负载/接口规格|V2.1数字与独立审计通过；所有假设/缺口可追溯，本轮已完成分析交付|
|P1|单bit/4bit真实双MUX DFF|同批三候选或最终选型；setup/hold、CLK→Q、两相死区、脉宽、偏斜、反馈保持/上电复位，保存可重复窗口|
|P2|ALU、PC递增、关键译码/扇出小网络|测数据/选择弧及最短/最长路径，含等效负载/串阻/走线/相邻线活动；校准参数库|
|P3|多位状态及完整33位clock负载分区|主从与跨位skew、reset、不同GPO/PC/AR/标志同时更新；验证短路径竞态不被低频掩盖|
|P4|真实157完整CPU+FPGA外围|逐指令/异常/RAM/游戏对照，错误快照、频率扫描，供电/温度变化及长期运行；不由FPGA代执行CPU|

## P1优先矩阵

真实连接必须同时看D、QM、Q和两路时钟选择端，不能只看输出是否翻转。比较共clock与非重叠两相，扫描正/负skew、高低占空比和D边沿相对位置；负载至少覆盖单bit、分支典型和实板最大。零错误窗口报告N及条件，不写理论BER=0。仪器需有足够时间分辨率和带宽，记录探头/夹具负载并去嵌或列为误差。

## P3短路径优先项

来自真实RTL同边沿活动的PC0→PC1、AR0→AR1、A→C、进位链；逐一制造目的Master迟关/源Slave早开，再测试两相全分区关闭/打开顺序。保存首次错误旧值/新值/时钟条件。A→GPO虽拓扑2层，OUT时A不发射，必须区分功能条件。

## P4放行门槛

先100kHz，验证全指令/全部非法终态、精确读写一次、同步复位及原游戏；再500k/1M/2M逐级，5M/10M仅在参数与时序闭合后研究。每点保存0 errors/N、厂商料号/批次、VCC实测、温度来源、频率/两相死区实测、固件/ROM/网表SHA、接口调度及PCB版本。

量产/整板放行前另需电源噪声/边沿/过冲/地弹、最小延迟与clock skew、部件批次/温度覆盖；数字模型通过不替代这些条件。阶段正式通过后再按AGENTS在docs/reports生成中文验收报告。
