boksop/swcell/docs/m20/ff16_resources/timing_results.csv

case | tap | d1_ns | d2_ns | global_overlap_events | own_overlap_events | data_errors | pipeline_errors | penetration_events | missing_windows | guard_fail | master_index | slave_index | min_master_window_ns | short_master_windows | d2_master_index | d2_slave_index | status | role
nominal | 4 | 8.0 | 8.0 | 0 | 0 | 0 | 0 | 0 | 0 | 0 | 0 | 0 | 492.0 | 0 | 0 | 0 | CONDITIONAL | normal_assumed
independent_cross | 4 | -2.0 | -2.0 | 8 | 0 | 0 | 4 | 0 | 0 | 1 | 32 | 0 | 495.0 | 0 | 0 | 32 | FAILED | normal_assumed
master_late | 4 | -2.0 | 8.0 | 4 | 4 | 4 | 0 | 4 | 0 | 1 | 0 | 0 | 502.0 | 0 | 0 | 0 | FAILED | normal_assumed
slave_late | 4 | 8.0 | -2.0 | 4 | 4 | 4 | 0 | 4 | 0 | 1 | 0 | 0 | 492.0 | 0 | 0 | 0 | FAILED | normal_assumed
mixed_stage | 4 | -2.0 | -3.5 | 8 | 0 | 0 | 4 | 0 | 0 | 1 | 32 | 0 | 496.5 | 0 | 0 | 32 | FAILED | normal_assumed
edge_asymmetric | 4 | -2.0 | -6.0 | 8 | 0 | 0 | 4 | 0 | 0 | 1 | 32 | 0 | 499.0 | 0 | 0 | 32 | FAILED | normal_assumed
decode_hold_mismatch | 4 | -8.2 | -8.2 | 8 | 8 | 0 | 4 | 0 | 0 | 1 | 0 | 0 | 508.2 | 0 | 0 | 0 | FAILED | normal_assumed
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
