boksop/swcell/docs/m20/M20_300_V2_TEST_REPORT.md

# M20-300 V2：结构功能与精确资源审计结果

日期：2026-10-29（Asia/Shanghai）。**两版结构功能验证与资源审计通过；300/328颗数量目标未达到。** 尚未由用户确认正式阶段验收，本文件记录实际结果供决定后续优化或FPGA原型范围。

## 1. 八个问题的直接回答

|问题|当前有证据的回答|
|---|---|
|V2与V1是否等价？|在全部指定回归、单元穷举及逐周期锁步范围内等价，且与Python一致；未做全状态形式等价证明。|
|当前CPU需多少颗157？|本次共享网表**537个真实组合MUX实例＋33bit×2存储折算=603颗核心等价**，含30保持/33复位MUX；不是完整物理BOM。朴素版为738。|
|哪个模块最多？|共享版严格译码169个MUX最多；ALU107，PC含storage98、AR含storage95。控制/译码合计含state storage222。|
|原328是否合理？|作为本实现的成本承诺不成立：共享版超275。它只是早期点估，严格译码/控制、ALU与复位被明显低估。|
|能否压到300？|当前必须再减303，约占603的50.25%；没有证据保证可达，也未证明理论不可达。需要新的结构因式分解/架构评审，不能把未实现节省计入。|
|优化是否增状态或延长路径？|O1全局CSE减少135颗；状态仍33，2/5周期不变，MUX拓扑最大深度50→50。物理关键延迟/负载仍未STA或电气验证。|
|有不能直接转换成157的逻辑吗？|生成的组合网络只有MUX/常量/线，可逐实例转换；存储仍为nativeFF，真实2-MUX反馈DFF及辅助电路尚未物理实现。|
|FPGA仍可用原生FF吗？|可以，保留33个原生FF和组合网络；工具可能映射成LUT，但本审计不按LUT数计算157。|

## 2. 两版数量与优化效果

|指标|baseline|shared|变化|
|---|---:|---:|---:|
|实际组合MUX实例|672|537|-135（-20.09%组合）|
|其中CE/保持|30|30|0|
|其中复位选择|33|33|0|
|功能状态bit|33|33|0|
|DFF等价，2颗/bit|66|66|0|
|核心157等价合计|738|603|-135（-18.29%总数）|
|MUX拓扑最大层数|50|50|0|
|功能网络最大pin负载（含主输入）|34，rst|34，rst|0|
|MUX输出最大内部pin负载|21|21|0；局部分布可不同|

共享优化O1只合并完全相同`(S,I0,I1)`节点，包含重复NOT；没有增加状态、时分复用、FPGA运算器或新ISA。模块下降为decoder95、control13、ALU27，其余不变，合计135。61个唯一MUX有CSE复用记录，其中19个跨语义组，全部只按首个物理实例计一次；不能再加到537上。

baseline已采用同一前端的合理单热译码和四位加减复用，只是不启用全局CSE。未将这些初始选择伪装为额外优化收益，也没有刻意放大baseline。PC/AR共用增量器、写回选择重排、控制因式分解等只作后续研究，不填入虚构数字。

逐组/逐实例CSV、原328同口径偏差与共享规则见[精确预算](M20_300_V2_MUX_BUDGET.md)及[v2_resources/module_budget.csv](v2_resources/module_budget.csv)。比较时将各组reset移到集中复位行，避免重复计数：PC为86 vs82，AR87 vs62，ALU107 vs40，控制/译码加state storage219 vs76，集中复位33 vs12；所有行最终603 vs328。

## 3. 实际执行的验证

本机Ubuntu24.04、Python3.12、Vivado Simulator2026.1.1；ISA与周期profile保持冻结值。没有修改V1功能源码、原始数据或游戏算法。

|测试项|规模|结果|证据根为build/m20_300/v2/|
|---|---|---|---|
|V1原入口重跑|86 Python、49指令＋38游戏、57331事件|PASS|`v1_recheck/verification.json`、`v1_recheck.console.log`|
|V2原语|每版8真值向量|PASS|`regression_r2/{版}/xsim/mux.log`|
|V1/V2/独立规则译码|每版65536编码，15015合法/50521非法|PASS|各版`xsim/isa.log`|
|V1/V2/数学ALU|每版32768向量，含A/Z/C独立使能|PASS|各版`xsim/isa.log`|
|内存/reset|每版7组，含WE已高时复位阻断、已写不回滚、HALT/TRAP恢复|PASS|各版`xsim/memory.log`|
|指令三方差分|每版49case/22223事件|PASS|各版`instructions/three_way_comparison.json`|
|游戏三方差分|每版38case/35108事件，含各64tick连续|PASS|各版`games/three_way_comparison.json`|
|所有最终RAM|每版87case各256nibble，V1=V2=Python|PASS|每case两份实际RAM及预期|
|Python全量|98项，10.331s（原86＋构造7＋独立审计5）|PASS|`python_tests.log`|
|独立资源审计|六份模块SV/JSON、唯一原语/每pin/FF-D/功能根/共享|PASS|`docs/m20/v2_resources/audit.json`|
|结构重生成|12份SV/JSON逐字节相同|PASS|`regeneration_check.json`|
|防写V1负测|prepare/compare/Shell三种误路径均拒绝|PASS|`v1_guard_negative_tests.json`|
|综合/STA/bitstream/硬件|本轮不执行|NOT_RUN|无|

两版合计174个CPU场景、114662个事件；每版57314正常退役＋17次TRAP。没有因双核锁步而把一条指令重复计成两条。实际执行周期每版指令51193、游戏115651；指令锁步还含49case×3个终态观察周期，共51340，游戏锁步115651。没有延长原2/5微周期来换面积。

65536是译码穷举，32768是组合ALU穷举；不能宣称50521个非法字都在CPU里逐个完整时序执行。CPU异常差分实际覆盖16种代表非法字和未加载FFFF。FAULT仍为软件/仿真范围诊断，没有新增硬件状态。

## 4. Pong/Snake ROM与关键场景

|ROM|有效字/字节|未填充小端binary SHA256|
|---|---:|---|
|Pong|168 / 336|`e1029928d763ab5b0d21fe347687f52b326f545e9072f4c04365597439eead8c`|
|Snake|368 / 736|`466cb149c8e5d6914d0b78dc8a3ec5074c77020edf880cedbd520b41b3376b98`|

以下两版V2与真正V1、Python均相同，数字来自真实CSV，不是主机算法替代：

|场景|实际指令|执行周期|覆盖意义|
|---|---:|---:|---|
|Pong boot|19|83|脏RAM初始化|
|Pong普通tick|65|202|按键/两球拍共享例程/球运动|
|Pong墙反弹＋双球拍＋分数进位|94|308|多分支和跨nibble进位|
|Pong boot＋连续64tick|4252|13223|运行期间无宿主状态回写|
|Snake boot|1862|4531|CPU真正清256nibble RAM|
|Snake普通tick|256|926|身体环、间接RAM与位图|
|Snake旧尾格合法进入|274|977|先清尾再设新头|
|Snake增长至64封顶|225|822|长度上限与得分更新|
|Snake重启|1869|4551|含软件重新初始化|
|Snake增长/63次食物探测|4152|13419|连通密集身体、搜索与分数FF→00|
|Snake boot＋连续64tick|18778|65225|持续指令执行与独立完整RAM|

单tick不含末尾NOP/JMP的4周期，连续记录含实际boot/循环开销。另含墙/球拍、得分回绕、索引回绕、自撞、方向/按键优先级、死亡/封顶保持及内存延迟/同步适配场景；没有改游戏规则或ROM。

## 5. 实例审计与资源边界

生成SV中每个MUX实例必须与连接JSON同S/I0/I1/Y。独立审计器不导入生成器，拒绝其它组合行为、隐含FF使能/复位、额外状态、组合环、未知信号、死网和纯debug门。共享归属按物理实例一次，跨组消费者只是同一输出连线。源哈希、pin表、FF-D和33位边界同时核对，不能靠修改一个JSON总数使审计通过。

603的storage66仍是约定折算：真实双MUX主从DFF尚未实现或测试；不能据此购买“603颗就能整板工作”。同步器storage至少另有24＋4，CE/reset/输入整形另审；RAM/ROM、时钟/复位/缓冲、总线方向/三态、供电PCB与调试分开。MUX输出21pin及rst34负载只是逻辑负载数，可能需要实际驱动/缓冲。

拓扑最长50层从ROM输入到功能端点，没有门延迟模型、STA、布线或可敏化路径证明；不能乘一个典型延迟便宣布Fmax。原语零延迟、nativeFF、ROM1.5ns/RAM2ns模型及10ns仿真时钟只验证数字契约，不代表157可以100MHz工作。

## 6. 异常、保全及复现

首轮`regression/`真实xelab FAIL：generate块内MUX实例与外层net同名。修复为`u_m...`实例、同步连接JSON并重生成后，`regression_r2/`全部PASS。修复不改逻辑/数量；失败日志原样保留，没有把首轮标成通过。

原V1源码/旧工程/原始证据1191项由`baseline.json`保护；旧V1目录848份证据没有被覆盖。新三方结果保留两份真实CSV/两份完整RAM、预期/输入、源码/输入哈希和两版各5个WDB（约270MiB），均在Git忽略的build中，建议独立归档。

复跑：

```bash
M20V2_OUTPUT_DIR=/home/boksop/swcell/build/m20_300/v2/recheck \
sim/scripts/run_m20_v2.sh
```

重新审计和生成预算命令见[验证说明](M20_300_V2_VERIFICATION.md)。结构说明见[M20_300_V2_STRUCTURE.md](M20_300_V2_STRUCTURE.md)。Git精确清单及证据归档方案见[基线提案](M20_300_V2_GIT_BASELINE.md)，未经用户确认不暂存/commit/push。

## 7. 决策边界

功能与精确计数的V2目标已完成；数量不是先前估计的328，也未实现300。即使假设169颗译码全部免费，现实现仍有434颗，因此不能期待只打磨一个小模块便达300；这只是当前网表的减法，不是所有微架构的下界。

若继续优化，应一次只改一个明确方案，记录面积/拓扑/负载变化并复跑本三方验证。下一步可研究译码/控制因式分解、结果/标志选择共享；PC/AR共用增量器和改状态可能有时序/选择/周期代价，须先评审。本轮停在可审计的603等价结构，等待用户决定，不提前进入FPGA板级或外设阶段。
