boksop/swcell/docs/m20/M20_V24_PHYSICAL_TIMING_OPEN_ISSUES.md

# V2.4：与数字系统验收分开的实体时序事项

2026-11-04。此清单状态**NOT_VERIFIED / OPEN**；用户已明确允许C/D在规定数字延迟假设下继续，不将缺失原厂min当作数字开发的无限期门禁。

|事项|当前数字模型/证据|未来实体工作|
|---|---|---|
|16级链最低与最高传播|TAP16链2ns/级为条件配置；0.5ns敏感性仍FAILED|3.3V、负载、温度/批次下分别测rise/fall min/max及不确定度|
|同芯片/跨芯片Buffer匹配|五种候选资料边界见CLOCK_TREE_BUDGET；未定实体树|按实际电源/输入斜率/负载测跨相和输出间差；不能用同封装skew代替系统差|
|锁存器有效开关/CQ/污染/hold|每叶1～5ns有效边界是假设；不存在实体反馈锁存规格签核|真实双MUX透明/保持、交接竞争、有效边界、setup/hold和短路径实测|
|PCB、焊盘、0Ω、探头|未提取；原7ns=模型分配3＋有效边界4，不是实测PCB|原理图/布线后提取和测量；确认每次只装一个tap/来源|
|原56组问题配置|24项FAILED、32 CONDITIONAL，不删除/重分类|用实体实际边界判断哪些配置可排除、哪些须修正|
|79实际短路径局部压力|每级0.125/0.25ns假设下79/52条错误，0.5/1ns未观察错|不能乘典型值证明实体安全，优先满足全局有效非重叠|
|REF CDC|数字两级同步和独立C时基；未模拟亚稳态|同步器布局/MTBF、停振/失步检测、输入与总线窗口约束|
|SAFE_HOLD默认/供电顺序|数字控制正常停车/释放与RESET分开；Buffer禁用非安全钳位|FPGA未配置/掉电默认H=1/S=0、独立路径、首周期及电源顺序实测|
|FPGA实现与IO往返|纯RTL/XSIM联合，不做板级工程|综合、布局布线、STA/CDC与真实IO时序，不借仿真代替|

CPU/时钟数量仍543＋20＝563，不含Buffer、FPGA服务/存储/调试。当前没有追加157、改ISA/游戏码或修改PCB；V3实机开发须另由用户启动。数字验收通过与本表仍OPEN可以同时成立。
