boksop/swcell/docs/evidence/m20_v31/negative/pong_restart_before_fix.txt

{"status": "FAIL_REPRODUCED", "trigger": "menu -> Pong -> release A -> A restart", "paddles_after_restart": {"left": [[0, 0, 0, 0, 0, 0, 0, 0], [0, 0, 0, 0, 0, 0, 0, 0], [0, 0, 0, 0, 0, 0, 0, 0]], "right": [[0, 0, 0, 0, 0, 0, 0, 0], [0, 0, 0, 0, 0, 0, 0, 0], [0, 0, 0, 0, 0, 0, 0, 0]]}, "expected_each_paddle_cell": [255, 255, 255, 255, 255, 255, 255, 255], "ball_before": [102, 102, 102, 102, 102, 102, 102, 102], "expected_plus_columns": [0, 0, 24, 126, 126, 24, 0, 0], "restart_failure": true, "plus_failure": true}
