boksop/swcell/docs/evidence/m20_v3/hardware/20261104_191535_slow_game_pong_issue/states.csv

game | frame_game | frame_valid | frame_ticks | micro | retired | reads | writes | ticks | errors | pc | ar | a | z | c | gpo | ustate | rom_word | ram_addr | ram_wdata | ram_rdata | ram_ce | ram_oe | ram_we | keys | run | halted | trapped | cycle_ticks | phase_trace | oled_frames
0 | 0 | 1 | 21032 | 4482310 | 1454119 | 936021 | 212665 | 21032 | 0 | 141 | 5 | 7 | 0 | 1 | 8 | 1 | 61440 | 0 | 7 | 8 | 0 | 0 | 0 | 8 | 1 | 0 | 0 | 50 | 184 | 223867
0 | 0 | 1 | 21062 | 4488688 | 1456183 | 937389 | 212959 | 21062 | 0 | 141 | 5 | 10 | 0 | 0 | 8 | 1 | 61440 | 0 | 10 | 9 | 0 | 0 | 0 | 8 | 1 | 0 | 0 | 50 | 184 | 223926
0 | 0 | 1 | 21092 | 4495083 | 1458251 | 938736 | 213263 | 21092 | 0 | 141 | 5 | 12 | 0 | 0 | 8 | 1 | 61440 | 0 | 12 | 11 | 0 | 0 | 0 | 0 | 1 | 0 | 0 | 50 | 184 | 223985
0 | 0 | 1 | 21122 | 4501429 | 1460305 | 940068 | 213565 | 21122 | 0 | 141 | 5 | 14 | 0 | 0 | 8 | 1 | 61440 | 0 | 14 | 13 | 0 | 0 | 0 | 0 | 1 | 0 | 0 | 50 | 184 | 224043
0 | 0 | 1 | 21152 | 4507841 | 1462377 | 941412 | 213873 | 21152 | 0 | 141 | 5 | 9 | 0 | 0 | 8 | 1 | 61440 | 0 | 9 | 8 | 0 | 0 | 0 | 0 | 1 | 0 | 0 | 50 | 184 | 224102
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
