boksop/swcell/fpga/projects/diagnostics/oled_keys/rtl/swc_io_diag_uart.sv

`default_nettype none
// Atomic latest-state snapshots, coalesced while UART is busy. Counters retain events.
module swc_io_diag_uart #(parameter integer CLK_HZ=50000000,BAUD=115200,PERIOD_CYCLES=25000000)(
 input wire clk,rst,changed,snapshot_stable,
 input wire[8:0] keys,seen,input wire[31:0] events,frames,seconds,
 input wire[287:0] counts,input wire[3:0] mode,input wire[7:0] patterns,
 input wire oled_ready,rx_seen,output wire tx,output logic[31:0] merged_updates
);
 logic sending,dirty;logic[31:0] timer;logic[8:0] index;
 logic[11:0] snap_keys,snap_seen;logic[31:0] snap_events,snap_frames,snap_seconds,snap_merged;
 logic[287:0] snap_counts;logic[3:0] snap_mode;logic[7:0] snap_patterns;logic snap_oled,snap_rx;
 wire uart_ready;reg[7:0] data;
 swc_uart_tx #(.CLK_HZ(CLK_HZ),.BAUD(BAUD)) uart(.clk(clk),.rst(rst),.data(data),.valid(sending),.ready(uart_ready),.tx(tx));
 function automatic[7:0] hex_ascii(input[3:0] n);hex_ascii=n<10?8'h30+{4'b0,n}:8'h41+{4'b0,n}-8'd10;endfunction
 always_comb begin
  data=8'h0a;
  case(index)
   9'd0:data=8'h7b;
   9'd1:data=8'h22;
   9'd2:data=8'h74;
   9'd3:data=8'h79;
   9'd4:data=8'h70;
   9'd5:data=8'h65;
   9'd6:data=8'h22;
   9'd7:data=8'h3a;
   9'd8:data=8'h22;
   9'd9:data=8'h49;
   9'd10:data=8'h4f;
   9'd11:data=8'h5f;
   9'd12:data=8'h53;
   9'd13:data=8'h54;
   9'd14:data=8'h41;
   9'd15:data=8'h54;
   9'd16:data=8'h45;
   9'd17:data=8'h22;
   9'd18:data=8'h2c;
   9'd19:data=8'h22;
   9'd20:data=8'h62;
   9'd21:data=8'h75;
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
   9'd242:data=8'h2c;
   9'd243:data=8'h22;
   9'd244:data=8'h75;
   9'd245:data=8'h70;
   9'd246:data=8'h22;
   9'd247:data=8'h3a;
   9'd248:data=8'h22;
   9'd249:data=hex_ascii(snap_seconds[28+:4]);
   9'd250:data=hex_ascii(snap_seconds[24+:4]);
   9'd251:data=hex_ascii(snap_seconds[20+:4]);
   9'd252:data=hex_ascii(snap_seconds[16+:4]);
   9'd253:data=hex_ascii(snap_seconds[12+:4]);
   9'd254:data=hex_ascii(snap_seconds[8+:4]);
   9'd255:data=hex_ascii(snap_seconds[4+:4]);
   9'd256:data=hex_ascii(snap_seconds[0+:4]);
   9'd257:data=8'h22;
   9'd258:data=8'h2c;
   9'd259:data=8'h22;
   9'd260:data=8'h6f;
   9'd261:data=8'h6c;
   9'd262:data=8'h65;
   9'd263:data=8'h64;
   9'd264:data=8'h22;
   9'd265:data=8'h3a;
   9'd266:data=(snap_oled?8'h31:8'h30);
   9'd267:data=8'h2c;
   9'd268:data=8'h22;
   9'd269:data=8'h72;
   9'd270:data=8'h78;
   9'd271:data=8'h22;
   9'd272:data=8'h3a;
   9'd273:data=(snap_rx?8'h31:8'h30);
   9'd274:data=8'h2c;
   9'd275:data=8'h22;
   9'd276:data=8'h6d;
   9'd277:data=8'h65;
   9'd278:data=8'h72;
   9'd279:data=8'h67;
   9'd280:data=8'h65;
   9'd281:data=8'h64;
   9'd282:data=8'h22;
   9'd283:data=8'h3a;
   9'd284:data=8'h22;
   9'd285:data=hex_ascii(snap_merged[28+:4]);
   9'd286:data=hex_ascii(snap_merged[24+:4]);
   9'd287:data=hex_ascii(snap_merged[20+:4]);
   9'd288:data=hex_ascii(snap_merged[16+:4]);
   9'd289:data=hex_ascii(snap_merged[12+:4]);
   9'd290:data=hex_ascii(snap_merged[8+:4]);
   9'd291:data=hex_ascii(snap_merged[4+:4]);
   9'd292:data=hex_ascii(snap_merged[0+:4]);
   9'd293:data=8'h22;
   9'd294:data=8'h7d;
   9'd295:data=8'h0a;
   default:data=8'h0a;
  endcase
 end
 always_ff @(posedge clk)begin
  if(rst)begin sending<=0;dirty<=1;timer<=0;index<=0;merged_updates<=0;
   snap_keys<=0;snap_seen<=0;snap_events<=0;snap_frames<=0;snap_seconds<=0;snap_counts<=0;snap_mode<=0;snap_patterns<=0;snap_oled<=0;snap_rx<=0;snap_merged<=0;
  end else begin
   if(timer<32'(PERIOD_CYCLES))timer<=timer+1'b1;
   if(changed)begin dirty<=1;if(sending)merged_updates<=merged_updates+1'b1;end
   if(sending)begin
    if(uart_ready)begin
     if(index==9'd295)begin sending<=0;index<=0;end else index<=index+1'b1;
    end
   end else if(snapshot_stable&&(dirty||changed||timer==32'(PERIOD_CYCLES)))begin
    snap_keys<={3'b0,keys};snap_seen<={3'b0,seen};snap_events<=events;snap_frames<=frames;
    snap_counts<=counts;snap_mode<=mode;snap_patterns<=patterns;snap_seconds<=seconds;
    snap_oled<=oled_ready;snap_rx<=rx_seen;snap_merged<=merged_updates;
    sending<=1;index<=0;dirty<=0;timer<=0;
   end
  end
 end
endmodule
`default_nettype wire
