boksop/swcell/(commit log)

2026-11-03 chore(swcell): establish local source baseline
    Retrospective complete snapshot prepared on 2026-11-03. The working tree already contains V0/V1/V2 and V2.1/V2.2; this is not a fabricated historical V1/V2 development snapshot. Preserve original staged TASK text and all existing M11/M20 sources. Raw evidence remains in place, indexed by SHA256. Local only; no hardware timing qualification.
    [M20_300_V2_GIT_FILES.csv, M20_V21_GIT_FILES.csv, co_launch_risks.csv, core_bom.csv, critical_categories.csv, device_parameters.csv, dff_bindings.csv, endpoint_paths.csv]
2026-11-03 fix(git): preserve historical CSV bytes in local snapshots
    Force renormalization after adding -text attributes so all 21 inherited CRLF CSV files are stored exactly as the unchanged original worktree files. The first ordinary add used cached stat data and did not refresh these blobs. Preserve all previous commits; no raw evidence or worktree contents rewritten.
    [M20_300_V2_GIT_FILES.csv, M20_V21_GIT_FILES.csv, co_launch_risks.csv, core_bom.csv, critical_categories.csv, device_parameters.csv, dff_bindings.csv, endpoint_paths.csv]
2026-11-03 docs(m20): add v2.2 physical feasibility analysis
    Seal the already-existing V2.2 parameter, path, short-path witness, clock/reset, power, FPGA interface and PCB preplan files in the release manifest and retrospective version index. Source baseline already contained these documents; this commit does not fabricate their chronology. Hardware timing and PCB remain unqualified.
2026-11-03 docs(git): record clean local recovery and release verification
    Record two clean detached-worktree restores, 113 Python tests per restore, full V2.1 XSIM and 79 witnesses from newly produced traces. Preserve 11,534 historical files and index 1,730 new evidence files. No remote, hardware or PCB operations. Source and physical analysis artifacts are unchanged from the physical-analysis tag.
    [local_git_recovery_20261103.csv]
2026-11-03 feat(m20): verify v2.3 two-phase CPU and FPGA memory integration
    Freeze the reviewed 48-file V2.3 Mode A digital simulation baseline.
    Scope: FPGA-generated non-overlapping phases, 543-equivalent-MUX CPU,
    and FPGA synchronous ROM/RAM driven by the V2.3 internal service events.
    Evidence: 87 scenarios / 57,331 events per zero/delayed profile, illegal
    terminal/reset coverage and timing negatives; original PASS evidence preserved.
    Excludes external Johnson generation, externally clocked/asynchronous memory
    service, and physical NC7SZ157 timing signoff. V2.4 review/worktree progress
    is deliberately excluded from this commit. No remote operations.
    [evidence_sha256.csv, penetration.csv, phase_guards.csv, regression_summary.csv, timing_trace.csv]
2026-11-03 docs(m20): record accepted v2.3 Mode A stage report
2026-11-04 chore(m20): preserve staged V2.4 candidate and A/B history
    Retrospective local snapshot of the 90 previously staged files, preserving
    all staged blobs exactly before the current V2.4 release is assembled.
    Includes the archived 116-MUX Johnson candidate and fixed20 feedforward A/B
    work, with their original limitations and failed configurations retained.
    This historical snapshot is not a V2.4 acceptance or physical timing claim.
    [connections_n8.csv, evidence_sha256.csv, independent_cross_tap4.errors.csv, independent_cross_tap4.trace.csv, mux_budget.csv, mux_connections.csv, regression_summary.csv, root_and_leaf_margins.csv]
2026-11-04 feat(m20): accept V2.4 feedforward full-system digital verification
    Freeze the fixed20 feedforward generator, 543-MUX CPU state binding,
    FPGA synchronous memory service, RUN/STOP/STEP control, generators,
    independent audits, tests, key evidence and the approved Chinese report.
    Six A/B/C logic/timed profiles each pass 87 cases /57,331 events; B/C
    also pass all 50,521 illegal terminal/recovery checks. Keep the 24 failed
    timing configurations and 131 local-path mismatches as retained evidence.
    Add a clean-tree 632-cone replay using byte-preserved 79 witness inputs,
    without changing the CPU, timing model or expected failure classifications.
    Acceptance is conditional on the declared digital tim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
    [M20_V24_GIT_FILES.csv, buffer_comparison.csv, cpu79_summary.csv, decode_hold_scan.csv, delay_scan_summary.csv, effective_clocks.csv, evidence_sha256.csv, frequency_envelope.csv]
2026-11-04 fix(test): supply explicit output-guard fixtures for clean checkouts
    The first clean-tree run exposed two frozen Python guard tests that rely
    on pre-existing historical output directories. Preserve their failing log
    and leave the frozen V2.3 code/tests untouched.
    Provide empty directory fixtures only when absent, run the same 151 tests,
    and remove only those newly created directories if still empty. The public
    system runner uses this fixture-aware entry without copying historical data
    or relaxing assertions. Preserve original CSV/SVG evidence bytes.
    [M20_V24_GIT_FILES.csv]
2026-11-04 docs(m20): record V2.4 clean-tree recovery and conditional acceptance
    Record the approved Chinese stage report, complete file inventory and
    technical fingerprints, preserved initial fixture failures and successful
    final clean-tree verification. Keep raw simulations and waves outside Git.
    The final detached checkout passes 151 Python tests, 56 timing cases,
    632 local-cone experiments and B/C memory/control/minimal-CPU gates.
    Seven generated files reproduce byte-for-byte; independent count stays563.
    No changes to CPU, ISA, ROM or timing generator in this records commit.
    Physical timing, FPGA implementation and hardware validation remain open.
    [M20_V24_GIT_FILES.csv, recovery_evidence_sha256.csv]
2026-11-04 refactor(swcell): separate board resources and module FPGA projects
    Move the M11-centered board tree into shared board/common resources and
    independent functional, performance and diagnostic projects. Reserve a
    planned M20 CPU prototype entry, add project templates/catalog and move
    M11 documentation under its module with updated operational paths.
    Preserve logical RTL, original pins, raw evidence and existing tags.
    Validate 156 Python tests, M11 full XSIM, M20 B/C gates, Vivado project
    creation and explicit historical-to-current source lineage. No hardware
    programming or bitstream generation in the layout migration.
    [evidence_sha256.csv, repository_migration_20261104.csv]
2026-11-04 feat(board): add verified OLED key and LED diagnostics
2026-11-04 feat(m20): complete V3 FPGA CPU Pong and Snake hardware validation
    [f05_evidence_sha256.csv, f06_evidence_sha256.csv, mux_mapping.csv, right_paddle_2.csv, right_paddle_5.csv, snake_shuffled_cases.csv, snake_shuffled_evidence_sha256.csv, snake_shuffled_hardware_food.csv]
2026-11-04 fix(git): accept only the explicitly authorized GitHub origin
    [test_publication_audit.py]
2026-11-05 feat(m20): finalize V3.1 autonomous FPGA system and firmware 0.2
    [drawing_cycles.csv, evidence_sha256.csv, large_evidence_index.csv, mux_mapping.csv, oled_drivers.csv, rom_layout.csv, spi_bytes.csv, states.csv]
